davidmhunt/fmcw3/parts/datasheet_left_as_is.csv

ref | reason | value
C2 | generic-spec-only | 100 nF
C3 | generic-spec-only | 10 pF
C4 | generic-spec-only | 100 nF
C5 | generic-spec-only | 10 pF
C6 | generic-spec-only | 100 nF
C7 | generic-spec-only | 10 pF
C8 | needs-David | 10 pF
C9 | generic-spec-only | 100 nF
C10 | generic-spec-only | 2.2 nF
C11 | needs-David | 10 pF
C12 | generic-spec-only | 1 uF
C13 | generic-spec-only | 10 nF
C14 | generic-spec-only | 51 pF
C15 | generic-spec-only | 100 nF
C16 | generic-spec-only | 10 nF
C17 | generic-spec-only | 100 nF
C18 | generic-spec-only | 100 nF
C19 | generic-spec-only | 1 uF
C20 | generic-spec-only | 1 uF
C21 | generic-spec-only | 100 nF
C22 | generic-spec-only | 2.2 uF
C23 | generic-spec-only | 100 nF
C24 | generic-spec-only | 100 nF
C25 | generic-spec-only | 100 nF
C26 | generic-spec-only | 10 uF
C27 | generic-spec-only | 100 nF
C28 | generic-spec-only | 10 nF
C29 | generic-spec-only | 68 pF
C30 | generic-spec-only | 100 nF
C31 | generic-spec-only | 2.2 uF
C32 | generic-spec-only | 100 nF
C33 | generic-spec-only | 100 pF
C34 | generic-spec-only | 100 pF
C36 | generic-spec-only | 10 pF
C38 | generic-spec-only | 10 uF
C39 | generic-spec-only | 2.2 uF
C40 | generic-spec-only | 100 pF
C41 | generic-spec-only | 100 pF
C42 | needs-David | 18 pF
C43 | generic-spec-only | 100 nF
C44 | generic-spec-only | 10 pF
C46 | needs-David | 18 pF
C48 | needs-David | 0.5 pF
C49 | generic-spec-only | 100 nF
C52 | needs-David | 18 pF
C53 | generic-spec-only | 10 pF
C55 | needs-David | 18 pF
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
R79 | generic-spec-only | 2.2 kohm
R80 | generic-spec-only | 0 ohm
R81 | generic-spec-only | 0 ohm
R82 | generic-spec-only | 4.7 kohm
R83 | generic-spec-only | 10 kohm
R84 | generic-spec-only | 33 ohm
R85 | generic-spec-only | 33 ohm
R87 | generic-spec-only | 0 ohm
R88 | generic-spec-only | 33 ohm
R89 | generic-spec-only | 0 ohm
R90 | generic-spec-only | 0 ohm
R91 | generic-spec-only | 0 ohm
R93 | generic-spec-only | 0 ohm
R94 | generic-spec-only | 0 ohm
R97 | generic-spec-only | 49.9 ohm
R98 | generic-spec-only | 49.9 ohm
R99 | generic-spec-only | 49.9 ohm
R100 | generic-spec-only | 49.9 ohm
R103 | generic-spec-only | 0 ohm
R104 | generic-spec-only | 68 kohm
R109 | generic-spec-only | 240 ohm
R111 | generic-spec-only | 1 kohm
R112 | generic-spec-only | 4.7 kohm
R114 | generic-spec-only | 0 ohm
R115 | generic-spec-only | 0 ohm
R117 | generic-spec-only | 4.7 kohm
R118 | generic-spec-only | 4.7 kohm
R130 | generic-spec-only | 33 ohm
U4 | needs-David | KT2520K
U8 | needs-David | LTC2292
U31 | needs-David | USB-MICRO
