davidmhunt/fmcw3/parts/availability.csv

refs | qty | need | value | footprint | kind | status | dk_status | mpn | mfr | dkpn | stock | ok | lead_weeks | dk_package | datasheet | dk_url | match | candidates | needs_david | package | tolerance | voltage | dielectric | tolerance_hint | dielectric_hint | notes
C1;C71;C72;C81;C103;C104;C105;C107;C169;C172;C173;C177;C178;C214;C215 | 15 | 75 | DNP | fmcw3:C_0805b | dnp | DNP |  |  |  |  |  | n/a |  |  |  |  |  |  |  |  |  |  |  |  |  | DNP in schematic: footprint only, not sourced
C23;C30;C32;C90;C91;C92;C132;C133;C219;C221 | 10 | 50 | 100 nF | fmcw3:C_0402b | generic | generic-spec-only |  |  |  |  |  | n/a |  |  |  |  |  |  |  | 0402 | unspecified | >=6.3 V (inferred default: no supply rail on these nets) | unspecified |  | X7R
C2;C4;C9;C15;C17;C18;C24;C25;C27;C43;C49;C58;C138;C139;C150;C151;C152;C153;C154;C158;C159;C160;C161;C176;C207;C210;C211;C212;C223;C224;C225;C252 | 32 | 160 | 100 nF | fmcw3:C_0402b | generic | generic-spec-only |  |  |  |  |  | n/a |  |  |  |  |  |  |  | 0402 | unspecified | >=6.3 V (inferred: 3.6 V on 3V6) | unspecified |  | X7R
C6;C108;C115;C116;C120;C121;C122;C123 | 8 | 40 | 100 nF | fmcw3:C_0402b | generic | generic-spec-only |  |  |  |  |  | n/a |  |  |  |  |  |  |  | 0402 | unspecified | >=10 V (inferred: 5 V on Net-(U1-VP)) | unspecified |  | X7R
C21 | 1 | 5 | 100 nF | fmcw3:C_0402b | generic | generic-spec-only |  |  |  |  |  | n/a |  |  |  |  |  |  |  | 0402 | unspecified | >=16 V (inferred: 10 V on 10V) | unspecified |  | X7R
C36;C134;C135;C136;C137 | 5 | 25 | 10 pF | fmcw3:C_0402b | generic | generic-spec-only |  |  |  |  |  | n/a |  |  |  |  |  |  |  | 0402 | unspecified | >=6.3 V (inferred default: no supply rail on these nets) | unspecified |  | C0G/NP0
C3;C5;C44;C53 | 4 | 20 | 10 pF | fmcw3:C_0402b | generic | generic-spec-only |  |  |  |  |  | n/a |  |  |  |  |  |  |  | 0402 | unspecified | >=6.3 V (inferred: 3.3 V on 3V3A) | unspecified |  | C0G/NP0
C7 | 1 | 5 | 10 pF | fmcw3:C_0402b | generic | generic-spec-only |  |  |  |  |  | n/a |  |  |  |  |  |  |  | 0402 | unspecified | >=10 V (inferred: 5 V on Net-(U1-VP)) | unspecified |  | C0G/NP0
C8;C11;C109;C110;C111;C112;C113;C114 | 8 | 40 | 10 pF | fmcw3:C_0402b | generic | needs-David |  |  |  |  |  | n/a |  |  |  |  |  |  | needs-David | 0402 | unspecified | >=6.3 V (inferred default: no supply rail on these nets) | unspecified |  | C0G/NP0 | RF-path part given by value only: vendor/series/tolerance/SRF decide performance
C10 | 1 | 5 | 2.2 nF | fmcw3:C_0402b | generic | generic-spec-only |  |  |  |  |  | n/a |  |  |  |  |  |  |  | 0402 | unspecified | >=6.3 V (inferred default: no supply rail on these nets) | unspecified |  | X7R
C126;C127 | 2 | 10 | 2.2 nF | fmcw3:C_0402b | generic | generic-spec-only |  |  |  |  |  | n/a |  |  |  |  |  |  |  | 0402 | unspecified | >=10 V (inferred: 5 V on Net-(C126-Pad1)) | unspecified |  | X7R
C19;C20;C217;C218 | 4 | 20 | 1 uF | fmcw3:C_0603b | generic | generic-spec-only |  |  |  |  |  | n/a |  |  |  |  |  |  |  | 0603 | unspecified | >=6.3 V (inferred default: no supply rail on these nets) | unspecified |  | X7R
C12;C222;C249 | 3 | 15 | 1 uF | fmcw3:C_0603b | generic | generic-spec-only |  |  |  |  |  | n/a |  |  |  |  |  |  |  | 0603 | unspecified | >=6.3 V (inferred: 3 V on 3V0) | unspecified |  | X7R
C89 | 1 | 5 | 1 uF | fmcw3:C_0603b | generic | generic-spec-only |  |  |  |  |  | n/a |  |  |  |  |  |  |  | 0603 | unspecified | >=25 V (inferred: 15 V on 12V) | unspecified |  | X7R
C13;C16;C63;C65;C66;C95 | 6 | 30 | 10 nF | fmcw3:C_0402b | generic | generic-spec-only |  |  |  |  |  | n/a |  |  |  |  |  |  |  | 0402 | unspecified | >=6.3 V (inferred default: no supply rail on these nets) | unspecified |  | X7R
C28;C97;C99;C179;C206 | 5 | 25 | 10 nF | fmcw3:C_0402b | generic | generic-spec-only |  |  |  |  |  | n/a |  |  |  |  |  |  |  | 0402 | unspecified | >=6.3 V (inferred: 3.3 V on 3V3A) | unspecified |  | X7R
C96;C128;C129;C130;C131 | 5 | 25 | 10 nF | fmcw3:C_0402b | generic | generic-spec-only |  |  |  |  |  | n/a |  |  |  |  |  |  |  | 0402 | unspecified | >=10 V (inferred: 5 V on 5V) | unspecified |  | X7R
C14 | 1 | 5 | 51 pF | fmcw3:C_0402b | generic | generic-spec-only |  |  |  |  |  | n/a |  |  |  |  |  |  |  | 0402 | unspecified | >=6.3 V (inferred default: no supply rail on these nets) | unspecified |  | C0G/NP0
C22;C31;C216;C220 | 4 | 20 | 2.2 uF | fmcw3:C_0603b | generic | generic-spec-only |  |  |  |  |  | n/a |  |  |  |  |  |  |  | 0603 | unspecified | >=6.3 V (inferred default: no supply rail on these nets) | unspecified |  | X5R or X7R
C39 | 1 | 5 | 2.2 uF | fmcw3:C_0603b | generic | generic-spec-only |  |  |  |  |  | n/a |  |  |  |  |  |  |  | 0603 | unspecified | >=6.3 V (inferred: 3.3 V on Net-(U14-BSPLY)) | unspecified |  | X5R or X7R
C26;C38;C76;C77;C78;C80;C85;C87;C88;C93;C94;C101;C102;C106;C248 | 15 | 75 | 10 uF | fmcw3:C_0805b | generic | generic-spec-only |  |  |  |  |  | n/a |  |  |  |  |  |  |  | 0805 | unspecified | >=6.3 V (inferred: 3.6 V on 3V6) | unspecified |  | X5R or X7R
C79;C82;C83;C84;C86;C100;C162 | 7 | 35 | 10 uF | fmcw3:C_0805b | generic | generic-spec-only |  |  |  |  |  | n/a |  |  |  |  |  |  |  | 0805 | unspecified | >=10 V (inferred: 5.6 V on 5V6) | unspecified |  | X5R or X7R
C98 | 1 | 5 | 10 uF | fmcw3:C_0805b | generic | generic-spec-only |  |  |  |  |  | n/a |  |  |  |  |  |  |  | 0805 | unspecified | >=16 V (inferred: 10 V on 10V) | unspecified |  | X5R or X7R
C60;C61;C62;C64;C70 | 5 | 25 | 10 uF | fmcw3:C_0805b | generic | generic-spec-only |  |  |  |  |  | n/a |  |  |  |  |  |  |  | 0805 | unspecified | >=25 V (inferred: 15 V on 12V) | unspecified |  | X5R or X7R
C29;C69 | 2 | 10 | 68 pF | fmcw3:C_0402b | generic | generic-spec-only |  |  |  |  |  | n/a |  |  |  |  |  |  |  | 0402 | unspecified | >=6.3 V (inferred default: no supply rail on these nets) | unspecified |  | C0G/NP0
C33;C34;C68;C163;C164;C165;C166;C167;C168 | 9 | 45 | 100 pF | fmcw3:C_0402b | generic | generic-spec-only |  |  |  |  |  | n/a |  |  |  |  |  |  |  | 0402 | unspecified | >=6.3 V (inferred default: no supply rail on these nets) | unspecified |  | C0G/NP0
C40;C41;C180;C213 | 4 | 20 | 100 pF | fmcw3:C_0402b | generic | generic-spec-only |  |  |  |  |  | n/a |  |  |  |  |  |  |  | 0402 | unspecified | >=6.3 V (inferred: 3.3 V on Net-(U14-BSPLY)) | unspecified |  | C0G/NP0
C117;C118;C119 | 3 | 15 | 100 pF | fmcw3:C_0402b | generic | generic-spec-only |  |  |  |  |  | n/a |  |  |  |  |  |  |  | 0402 | unspecified | >=10 V (inferred: 5 V on 5VF) | unspecified |  | C0G/NP0
C35;C37;C45;C47;C50;C51;C54;C56;C59 | 9 | 45 | DNP | fmcw3:C_0603b | dnp | DNP |  |  |  |  |  | n/a |  |  |  |  |  |  |  |  |  |  |  |  |  | DNP in schematic: footprint only, not sourced
C42;C46;C52;C55 | 4 | 20 | 18 pF | fmcw3:C_0402b | generic | needs-David |  |  |  |  |  | n/a |  |  |  |  |  |  | needs-David | 0402 | unspecified | >=6.3 V (inferred: 3 V on Net-(U9-RFOUT)) | unspecified |  | C0G/NP0 | RF-path part given by value only: vendor/series/tolerance/SRF decide performance
C48;C57 | 2 | 10 | 0.5 pF | fmcw3:C_0402b | generic | needs-David |  |  |  |  |  | n/a |  |  |  |  |  |  | needs-David | 0402 | unspecified | >=6.3 V (inferred default: no supply rail on these nets) | unspecified |  | C0G/NP0 | RF-path part given by value only: vendor/series/tolerance/SRF decide performance
C67 | 1 | 5 | 39 pF | fmcw3:C_0402b | generic | generic-spec-only |  |  |  |  |  | n/a |  |  |  |  |  |  |  | 0402 | unspecified | >=6.3 V (inferred default: no supply rail on these nets) | unspecified |  | C0G/NP0
C73 | 1 | 5 | 15 nF | fmcw3:C_0402b | generic | generic-spec-only |  |  |  |  |  | n/a |  |  |  |  |  |  |  | 0402 | unspecified | >=6.3 V (inferred: 1 V on Net-(C73-Pad1)) | unspecified |  | X7R
C74 | 1 | 5 | 8.2 nF | fmcw3:C_0402b | generic | generic-spec-only |  |  |  |  |  | n/a |  |  |  |  |  |  |  | 0402 | unspecified | >=6.3 V (inferred: 3.6 V on Net-(C74-Pad1)) | unspecified |  | X7R
C75 | 1 | 5 | 4.7 nF | fmcw3:C_0402b | generic | generic-spec-only |  |  |  |  |  | n/a |  |  |  |  |  |  |  | 0402 | unspecified | >=10 V (inferred: 5.6 V on Net-(C75-Pad1)) | unspecified |  | X7R
C124;C125;C140;C141;C142;C143;C144;C145;C146;C147;C148;C149;C174;C175 | 14 | 70 | DNP | fmcw3:C_0402b | dnp | DNP |  |  |  |  |  | n/a |  |  |  |  |  |  |  |  |  |  |  |  |  | DNP in schematic: footprint only, not sourced
C155;C156;C157 | 3 | 15 | 4.7 uF | fmcw3:C_0603b | generic | generic-spec-only |  |  |  |  |  | n/a |  |  |  |  |  |  |  | 0603 | unspecified | >=6.3 V (inferred: 3.3 V on Net-(U33-VPHY)) | unspecified |  | X5R or X7R
C170;C171;C187;C189;C190;C191;C192;C193;C197;C198;C199;C200;C201;C202;C203;C204;C205;C250;C251 | 19 | 95 | 470 nF | fmcw3:C_0402b | generic | generic-spec-only |  |  |  |  |  | n/a |  |  |  |  |  |  |  | 0402 | unspecified | >=6.3 V (inferred: 3.3 V on 3V3D) | unspecified |  | X7R
C181 | 1 | 5 | 100 uF | Capacitors_SMD:C_1210 | generic | generic-spec-only |  |  |  |  |  | n/a |  |  |  |  |  |  |  | 1210 | unspecified | >=6.3 V (inferred: 1 V on 1V0) | unspecified |  | X5R or X7R
C182;C184;C196 | 3 | 15 | 47 uF | Capacitors_SMD:C_1206 | generic | generic-spec-only |  |  |  |  |  | n/a |  |  |  |  |  |  |  | 1206 | unspecified | >=6.3 V (inferred: 3.3 V on 3V3D) | unspecified |  | X5R or X7R
C183;C185;C186;C188;C194;C195 | 6 | 30 | 4.7 uF | fmcw3:C_0805b | generic | generic-spec-only |  |  |  |  |  | n/a |  |  |  |  |  |  |  | 0805 | unspecified | >=6.3 V (inferred: 3.3 V on 3V3D) | unspecified |  | X5R or X7R
C208;C209 | 2 | 10 | 15 pF | fmcw3:C_0402b | generic | generic-spec-only |  |  |  |  |  | n/a |  |  |  |  |  |  |  | 0402 | unspecified | >=6.3 V (inferred default: no supply rail on these nets) | unspecified |  | C0G/NP0 (crystal load caps)
CON1 | 1 | 5 | SD_Card_DM3BT | fmcw3:DM3BT-DSF-PEJS | mpn | Active | Active | DM3BT-DSF-PEJS | Hirose Electric Co Ltd | HR1942CT-ND | 16323 | yes | 16 |  | https://www.hirose.com/product/download/?distributor=digikey&type=specSheet&lang=en&num=DM3BT-DSF-PEJS | https://www.digikey.com/en/products/detail/hirose-electric-co-ltd/DM3BT-DSF-PEJS/1982749 | exact |  |  |  |  |  |  |  |  | SD card socket
CON2 | 1 | 5 | BARREL_JACK | fmcw3:EJ508A | mpn | Active | Active | EJ508A | MPD (Memory Protection Devices) | EJ508A-ND | 6629 | yes | 20 |  | https://www.memoryprotectiondevices.com/datasheets/EJ508A/EJ508A-datasheet.pdf | https://www.digikey.com/en/products/detail/mpd-memory-protection-devices/EJ508A/2439547 | exact |  |  |  |  |  |  |  |  | barrel jack
D1;D6 | 2 | 10 | LED | fmcw3:LED_0603 | generic | generic-spec-only |  |  |  |  |  | n/a |  |  |  |  |  |  |  | 0603 | n/a |  |  |  |  | LED: colour, Vf, current not in schematic
D2;D3;D4 | 3 | 15 | SS13FL | fmcw3:SOD-123F | mpn | Obsolete | Obsolete | SS13FL | onsemi | 2832-SS13FLTR-ND | 15000 | CHECK | 13 | SOD-123F | https://www.onsemi.com/pdf/datasheet/ss14fl-d.pdf | https://www.digikey.com/en/products/detail/onsemi/SS13FL/5305064 | exact |  |  |  |  |  |  |  |  | Schottky SOD-123F
F1;F2 | 2 | 10 | Via | fmcw3:RF_via | nopart | no-part |  |  |  |  |  | n/a |  |  |  |  |  |  |  |  |  |  |  |  |  | RF via footprint (PCB feature)
FB1;FB2;FB3;FB5;FB6;FB7;FB8;FB12;FB13;FB14 | 10 | 50 | BLM18PG181SN1D | fmcw3:C_0603b | mpn | Active | Active | BLM18PG181SN1D | Murata Electronics | 490-5263-1-ND | 426016 | yes | 29 |  | https://pim.murata.com/asset/pim4/ferriteBeadInductortypefilter/ENFA0003_PDF_FERRITEBEADINDUCTORTYPEFILTER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 | https://www.digikey.com/en/products/detail/murata-electronics/BLM18PG181SN1D/1634634 | exact |  |  |  |  |  |  |  |  | ferrite
FB4;FB11 | 2 | 10 | CIC21P101NE | fmcw3:C_0805b | mpn | Obsolete | Obsolete | CIC21P101NE | Samsung Electro-Mechanics | 1276-6374-2-ND | 0 | CHECK | 26 |  | //mm.digikey.com/Volume0/opasdata/d220001/medias/docus/2330/CIC21_ds.pdf | https://www.digikey.com/en/products/detail/samsung-electro-mechanics/CIC21P101NE/3973735 | exact |  |  |  |  |  |  |  |  | ferrite
L1;L3 | 2 | 10 | LQW15AN9N9J80D | fmcw3:C_0402b | mpn | Active | Active | LQW15AN9N9J80D | Murata Electronics | 490-7690-1-ND | 766 | yes | 25 | - | https://pim.murata.com/asset/pim4/inductor/JELF243A-0100_PDF_INDUCTOR | https://www.digikey.com/en/products/detail/murata-electronics/LQW15AN9N9J80D/4292403 | exact |  |  |  |  |  |  |  |  | 9.9 nH RF inductor
L2;L4 | 2 | 10 | 0.6 nH | fmcw3:C_0402b | generic | needs-David |  |  |  |  |  | n/a |  |  |  |  |  |  | needs-David | 0402 | unspecified |  |  |  |  | current/saturation rating, DCR, SRF not in schematic; RF-path part given by value only: vendor/series/tolerance/SRF decide performance
L5;L6;L7 | 3 | 15 | 33u (SRR6040A-330M) | fmcw3:SRR6040A | mpn | NFND | Not For New Designs | SRR6040A-330M | Bourns Inc. | SRR6040A-330MCT-ND | 777 | CHECK | 16 | - | https://www.bourns.com/docs/Product-Datasheets/SRR6040A.pdf | https://www.digikey.com/en/products/detail/bourns-inc/SRR6040A-330M/5031023 | exact |  |  |  |  |  |  |  |  | 33 uH buck inductor
L8;L9;L10;L11 | 4 | 20 | 2.2 uH | fmcw3:C_0805b | generic | generic-spec-only |  |  |  |  |  | n/a |  |  |  |  |  |  |  | 0805 | unspecified |  |  |  |  | current/saturation rating, DCR, SRF not in schematic
P1;P2 | 2 | 10 | SMA | fmcw3:CONSMA003.062 | mpn | Active | Active | CONSMA003.062 | TE Connectivity Linx | CONSMA003.062-ND | 5904 | yes | 4 |  | https://linxtechnologies.com/wp/wp-content/uploads/sma_rp-sma_specs.pdf | https://www.digikey.com/en/products/detail/te-connectivity-linx/CONSMA003-062/1577208 | exact |  |  |  |  |  |  |  |  | Linx edge-launch SMA (same footprint as U15)
P3;P4 | 2 | 10 | CONN_02X04 | Pin_Headers:Pin_Header_Straight_2x04_Pitch2.54mm_SMD | generic | generic-spec-only |  |  |  |  |  | n/a |  |  |  |  |  |  |  | SMD 2x4 2.54 mm | n/a |  |  |  |  | 2x4 2.54 mm SMD pin header, footprint Pin_Header_Straight_2x04_Pitch2.54mm_SMD; MPN to be picked by David
P5;P7;P8 | 3 | 15 | CONN_01X01 | fmcw3:MountingHole_3.2mm_M3_Pad_Via_mod | nopart | no-part |  |  |  |  |  | n/a |  |  |  |  |  |  |  |  |  |  |  |  |  | M3 mounting hole (mechanical)
P6;P9;P10;P11;P12;P13;P14;P15;P16 | 9 | 45 | CONN_01X01 | fmcw3:TP_1.00 | nopart | no-part |  |  |  |  |  | n/a |  |  |  |  |  |  |  |  |  |  |  |  |  | 1 mm test-point pad (PCB feature)
Q1 | 1 | 5 | RE1C002UN | fmcw3:SOT-416 | mpn | Active | Active | RE1C002UNTCL | Rohm Semiconductor | RE1C002UNTCLCT-ND | 586719 | yes | 16 | EMT3F (SOT-416FL) | https://fscdn.rohm.com/en/products/databook/datasheet/discrete/transistor/mosfet/re1c002untcl-e.pdf | https://www.digikey.com/en/products/detail/rohm-semiconductor/RE1C002UNTCL/5042785 | exact |  |  |  |  |  |  |  |  | MOSFET SOT-416FL; TCL = taping
Q2 | 1 | 5 | DNP(RE1C002UN) | fmcw3:SOT-416 | dnp | DNP |  |  |  |  |  | n/a |  |  |  |  |  |  |  |  |  |  |  |  |  | DNP in schematic: footprint only, not sourced
R1 | 1 | 5 | 5.49 kohm | fmcw3:R_0402b | generic | generic-spec-only |  |  |  |  |  | n/a |  |  |  |  |  |  |  | 0402 | unspecified |  |  | E96 value, 1% implied |  | power rating not in schematic (0402 default 1/16 W)
R2;R31;R40;R50;R63;R64;R65;R66;R67;R68;R69;R74;R75;R76;R77;R78;R86;R92;R101;R110 | 20 | 100 | DNP | fmcw3:R_0402b | dnp | DNP |  |  |  |  |  | n/a |  |  |  |  |  |  |  |  |  |  |  |  |  | DNP in schematic: footprint only, not sourced
R3;R8 | 2 | 10 | 470 kohm | fmcw3:R_0402b | generic | generic-spec-only |  |  |  |  |  | n/a |  |  |  |  |  |  |  | 0402 | unspecified |  |  | E24 value, 5% implied |  | power rating not in schematic (0402 default 1/16 W)
R4 | 1 | 5 | 3.1 kohm | fmcw3:R_0402b | generic | generic-spec-only |  |  |  |  |  | n/a |  |  |  |  |  |  |  | 0402 | unspecified |  |  | value outside E24/E96 |  | power rating not in schematic (0402 default 1/16 W)
R5;R6;R7;R18;R82;R112;R117;R118 | 8 | 40 | 4.7 kohm | fmcw3:R_0402b | generic | generic-spec-only |  |  |  |  |  | n/a |  |  |  |  |  |  |  | 0402 | unspecified |  |  | E24 value, 5% implied |  | power rating not in schematic (0402 default 1/16 W)
R9;R11;R12 | 3 | 15 | 18 ohm | fmcw3:R_0402b | generic | needs-David |  |  |  |  |  | n/a |  |  |  |  |  |  | needs-David | 0402 | unspecified |  |  | E24 value, 5% implied |  | power rating not in schematic (0402 default 1/16 W); RF-path part given by value only: vendor/series/tolerance/SRF decide performance
R10 | 1 | 5 | 6.98 kohm | fmcw3:R_0402b | generic | generic-spec-only |  |  |  |  |  | n/a |  |  |  |  |  |  |  | 0402 | unspecified |  |  | E96 value, 1% implied |  | power rating not in schematic (0402 default 1/16 W)
R13;R15;R16;R38;R84;R85;R88;R130 | 8 | 40 | 33 ohm | fmcw3:R_0402b | generic | generic-spec-only |  |  |  |  |  | n/a |  |  |  |  |  |  |  | 0402 | unspecified |  |  | E24 value, 5% implied |  | power rating not in schematic (0402 default 1/16 W)
R14 | 1 | 5 | 39 kohm | fmcw3:R_0402b | generic | generic-spec-only |  |  |  |  |  | n/a |  |  |  |  |  |  |  | 0402 | unspecified |  |  | E24 value, 5% implied |  | power rating not in schematic (0402 default 1/16 W)
R51;R52;R53;R54;R97;R98;R99;R100 | 8 | 40 | 49.9 ohm | fmcw3:R_0402b | generic | generic-spec-only |  |  |  |  |  | n/a |  |  |  |  |  |  |  | 0402 | unspecified |  |  | E96 value, 1% implied |  | power rating not in schematic (0402 default 1/16 W)
R17 | 1 | 5 | 49.9 ohm | fmcw3:R_0402b | generic | needs-David |  |  |  |  |  | n/a |  |  |  |  |  |  | needs-David | 0402 | unspecified |  |  | E96 value, 1% implied |  | power rating not in schematic (0402 default 1/16 W); RF-path part given by value only: vendor/series/tolerance/SRF decide performance
R20;R70;R80;R81;R87;R89;R90;R91;R93;R94;R103;R114;R115 | 13 | 65 | 0 ohm | fmcw3:R_0402b | generic | generic-spec-only |  |  |  |  |  | n/a |  |  |  |  |  |  |  | 0402 | unspecified |  |  | 0 ohm jumper |  | power rating not in schematic (0402 default 1/16 W)
R21 | 1 | 5 | 22 ohm | fmcw3:R_0402b | generic | generic-spec-only |  |  |  |  |  | n/a |  |  |  |  |  |  |  | 0402 | unspecified |  |  | E24 value, 5% implied |  | power rating not in schematic (0402 default 1/16 W)
R22;R23;R42 | 3 | 15 | 100 ohm | fmcw3:R_0402b | generic | generic-spec-only |  |  |  |  |  | n/a |  |  |  |  |  |  |  | 0402 | unspecified |  |  | E96 value, 1% implied |  | power rating not in schematic (0402 default 1/16 W)
R24;R109 | 2 | 10 | 240 ohm | fmcw3:R_0402b | generic | generic-spec-only |  |  |  |  |  | n/a |  |  |  |  |  |  |  | 0402 | unspecified |  |  | E24 value, 5% implied |  | power rating not in schematic (0402 default 1/16 W)
R25;R26;R104 | 3 | 15 | 68 kohm | fmcw3:R_0402b | generic | generic-spec-only |  |  |  |  |  | n/a |  |  |  |  |  |  |  | 0402 | unspecified |  |  | E24 value, 5% implied |  | power rating not in schematic (0402 default 1/16 W)
R27 | 1 | 5 | 15 kohm | fmcw3:R_0402b | generic | generic-spec-only |  |  |  |  |  | n/a |  |  |  |  |  |  |  | 0402 | unspecified |  |  | E96 value, 1% implied |  | power rating not in schematic (0402 default 1/16 W)
R28 | 1 | 5 | 59 kohm | fmcw3:R_0402b | generic | generic-spec-only |  |  |  |  |  | n/a |  |  |  |  |  |  |  | 0402 | unspecified |  |  | E96 value, 1% implied |  | power rating not in schematic (0402 default 1/16 W)
R29 | 1 | 5 | 6.8 kohm | fmcw3:R_0402b | generic | generic-spec-only |  |  |  |  |  | n/a |  |  |  |  |  |  |  | 0402 | unspecified |  |  | E24 value, 5% implied |  | power rating not in schematic (0402 default 1/16 W)
R30;R59;R60;R61;R62 | 5 | 25 | 8.2 kohm | fmcw3:R_0402b | generic | generic-spec-only |  |  |  |  |  | n/a |  |  |  |  |  |  |  | 0402 | unspecified |  |  | E24 value, 5% implied |  | power rating not in schematic (0402 default 1/16 W)
R32;R34;R36 | 3 | 15 | 4.99 kohm | fmcw3:R_0402b | generic | generic-spec-only |  |  |  |  |  | n/a |  |  |  |  |  |  |  | 0402 | unspecified |  |  | E96 value, 1% implied |  | power rating not in schematic (0402 default 1/16 W)
R33 | 1 | 5 | 7.5 kohm | fmcw3:R_0402b | generic | generic-spec-only |  |  |  |  |  | n/a |  |  |  |  |  |  |  | 0402 | unspecified |  |  | E96 value, 1% implied |  | power rating not in schematic (0402 default 1/16 W)
R35;R72;R111 | 3 | 15 | 1 kohm | fmcw3:R_0402b | generic | generic-spec-only |  |  |  |  |  | n/a |  |  |  |  |  |  |  | 0402 | unspecified |  |  | E96 value, 1% implied |  | power rating not in schematic (0402 default 1/16 W)
R37 | 1 | 5 | 590 ohm | fmcw3:R_0402b | generic | generic-spec-only |  |  |  |  |  | n/a |  |  |  |  |  |  |  | 0402 | unspecified |  |  | E96 value, 1% implied |  | power rating not in schematic (0402 default 1/16 W)
R39 | 1 | 5 | 47 kohm | fmcw3:R_0402b | generic | generic-spec-only |  |  |  |  |  | n/a |  |  |  |  |  |  |  | 0402 | unspecified |  |  | E24 value, 5% implied |  | power rating not in schematic (0402 default 1/16 W)
R41 | 1 | 5 | 56 ohm | fmcw3:R_0402b | generic | generic-spec-only |  |  |  |  |  | n/a |  |  |  |  |  |  |  | 0402 | unspecified |  |  | E24 value, 5% implied |  | power rating not in schematic (0402 default 1/16 W)
R43 | 1 | 5 | 10.5 kohm | fmcw3:R_0402b | generic | generic-spec-only |  |  |  |  |  | n/a |  |  |  |  |  |  |  | 0402 | unspecified |  |  | E96 value, 1% implied |  | power rating not in schematic (0402 default 1/16 W)
R44;R49 | 2 | 10 | 2 kohm | fmcw3:R_0402b | generic | generic-spec-only |  |  |  |  |  | n/a |  |  |  |  |  |  |  | 0402 | unspecified |  |  | E96 value, 1% implied |  | power rating not in schematic (0402 default 1/16 W)
R45 | 1 | 5 | 1.87 kohm | fmcw3:R_0402b | generic | generic-spec-only |  |  |  |  |  | n/a |  |  |  |  |  |  |  | 0402 | unspecified |  |  | E96 value, 1% implied |  | power rating not in schematic (0402 default 1/16 W)
R46 | 1 | 5 | 1.5 kohm | fmcw3:R_0402b | generic | generic-spec-only |  |  |  |  |  | n/a |  |  |  |  |  |  |  | 0402 | unspecified |  |  | E96 value, 1% implied |  | power rating not in schematic (0402 default 1/16 W)
R47 | 1 | 5 | 3.57 kohm | fmcw3:R_0402b | generic | generic-spec-only |  |  |  |  |  | n/a |  |  |  |  |  |  |  | 0402 | unspecified |  |  | E96 value, 1% implied |  | power rating not in schematic (0402 default 1/16 W)
R48 | 1 | 5 | 1.15 kohm | fmcw3:R_0402b | generic | generic-spec-only |  |  |  |  |  | n/a |  |  |  |  |  |  |  | 0402 | unspecified |  |  | E96 value, 1% implied |  | power rating not in schematic (0402 default 1/16 W)
R55;R56;R57;R58 | 4 | 20 | 550 ohm | fmcw3:R_0402b | generic | generic-spec-only |  |  |  |  |  | n/a |  |  |  |  |  |  |  | 0402 | unspecified |  |  | value outside E24/E96 |  | power rating not in schematic (0402 default 1/16 W)
R71 | 1 | 5 | 12 kohm | fmcw3:R_0402b | generic | generic-spec-only |  |  |  |  |  | n/a |  |  |  |  |  |  |  | 0402 | unspecified |  |  | E24 value, 5% implied |  | power rating not in schematic (0402 default 1/16 W)
R73;R83 | 2 | 10 | 10 kohm | fmcw3:R_0402b | generic | generic-spec-only |  |  |  |  |  | n/a |  |  |  |  |  |  |  | 0402 | unspecified |  |  | E96 value, 1% implied |  | power rating not in schematic (0402 default 1/16 W)
R79 | 1 | 5 | 2.2 kohm | fmcw3:R_0402b | generic | generic-spec-only |  |  |  |  |  | n/a |  |  |  |  |  |  |  | 0402 | unspecified |  |  | E24 value, 5% implied |  | power rating not in schematic (0402 default 1/16 W)
SW2 | 1 | 5 | SW_PUSH | fmcw3:EVP-AWBA2A | mpn | Obsolete | Obsolete | EVP-AWBA2A | Panasonic Industry | P16850TR-ND | 0 | CHECK | 12 |  | //mm.digikey.com/Volume0/opasdata/d220001/medias/docus/2142/EVPAW.pdf | https://www.digikey.com/en/products/detail/panasonic-industry/EVP-AWBA2A/4930563 | exact |  |  |  |  |  |  |  |  | tactile switch
U1 | 1 | 5 | ADF4158 | fmcw3:VFQFN-24 | mpn | Active | Active | ADF4158CCPZ | Analog Devices Inc. | 505-ADF4158CCPZ-ND | 838 | yes | 12 | 24-LFCSP (4x4) | https://www.analog.com/media/en/technical-documentation/data-sheets/ADF4158.pdf | https://www.digikey.com/en/products/detail/analog-devices-inc/ADF4158CCPZ/2700204 | exact |  |  |  |  |  |  |  |  | PLL; MPN from schematic manf# field
U2 | 1 | 5 | LP5907-1.8 | fmcw3:SOT-23-5 | mpn | Active | Active | LP5907MFX-1.8/NOPB | Texas Instruments | 296-41463-1-ND | 9060 | yes | 16 | SOT-23-5 | https://www.ti.com/lit/ds/symlink/lp5907.pdf?ts=1782050205678 | https://www.digikey.com/en/products/detail/texas-instruments/LP5907MFX-1-8-NOPB/3911201 | exact |  |  |  |  |  |  |  |  | LDO; MFX = SOT-23-5 (matches footprint)
U3;U12 | 2 | 10 | PAT1220-6dB | fmcw3:PAT1220 | mpn | Active | Active | PAT1220-C-6DB-T5 | Susumu | PAT126CT-ND | 4759 | yes | 32 |  | https://www.susumu.co.jp/common/pdf/n_catalog_partition16_en.pdf | https://www.digikey.com/en/products/detail/susumu/PAT1220-C-6DB-T5/948837 | exact |  |  |  |  |  |  |  |  | Susumu 0805 attenuator: C=50 ohm, 06=6 dB, T5=tape
U4 | 1 | 5 | KT2520K | fmcw3:KT2520K | mpn | needs-David |  |  |  |  |  | n/a |  |  |  |  | candidates | KT2520K26000ZAW18TAS [Obsolete, stock 0, 478-KT2520K26000ZAW18TASTR-ND]; KT2520K40000DAW18TAS [Obsolete, stock 0, 478-KT2520K40000DAW18TASTR-ND]; KT2520K37400ZAW18TBS [Active, stock 0, 478-KT2520K37400ZAW18TBS-ND]; KT2520K38400ZAW18TES [Obsolete, stock 0, 478-KT2520K38400ZAW18TESTR-ND]; KT2520K16369ACW18TAS [Obsolete, stock 0, 478-KT2520K16369ACW18TASTR-ND] | needs-David |  |  |  |  |  |  | TCXO: frequency and stability not in schematic or docs; supply is 1.8 V (net 1V8_OSC) so only 1.8 V variants listed; family mostly Obsolete
U5 | 1 | 5 | NC7S04P5X | TO_SOT_Packages_SMD:SOT-353_SC-70-5 | mpn | Active | Active | NC7S04P5X | onsemi | NC7S04P5XCT-ND | 77480 | yes | 52 | SC-70-5 | https://www.onsemi.com/pub/Collateral/NC7S04-D.PDF | https://www.digikey.com/en/products/detail/onsemi/NC7S04P5X/965417 | exact
U6 | 1 | 5 | NB3N551 | fmcw3:DFN-8 | mpn | Obsolete | Obsolete | NB3N551MNR4G | onsemi | NB3N551MNR4GOSCT-ND | 0 | CHECK | 28 | 8-DFN (2x2) | //mm.digikey.com/Volume0/opasdata/d220001/medias/docus/7560/NB3N551DR2G%20%281%29.pdf | https://www.digikey.com/en/products/detail/onsemi/NB3N551MNR4G/1792369 | exact |  |  |  |  |  |  |  |  | clock buffer; DFN-8 2x2 footprint (onsemi 506CN) -> MN variant, only DFN8 orderable code
U7 | 1 | 5 | TLV172DCK | TO_SOT_Packages_SMD:SOT-353_SC-70-5 | mpn | Active | Active | TLV172IDCKR | Texas Instruments | 296-48697-1-ND | 2171 | yes | 9 | SC-70-5 | https://www.ti.com/general/docs/suppproductinfo.tsp?distId=10 | https://www.digikey.com/en/products/detail/texas-instruments/TLV172IDCKR/6564682 | exact |  |  |  |  |  |  |  |  | value TLV172DCK; I grade, SC70-5 reel
U8 | 1 | 5 | LTC2292 | Housings_DFN_QFN:QFN-64-1EP_9x9mm_Pitch0.5mm | mpn | needs-David |  |  |  |  |  | n/a |  |  |  |  | candidates | LTC2292CUP#PBF [Active, stock 60, LTC2292CUP#PBF-ND]; LTC2292IUP#PBF [Active, stock 344, 505-LTC2292IUP#PBF-ND] | needs-David |  |  |  |  |  |  | dual ADC, 64-QFN 9x9 = UP package; C (0-70 C) vs I (-40-85 C) grade not in schematic
U9;U13 | 2 | 10 | TRF37A73 | fmcw3:DFN-8-1EP_2x2mm_Pitch0.5mm | mpn | Active | Active | TRF37A73IDSGR | Texas Instruments | 296-48786-1-ND | 3550 | yes | 26 | 8-WSON (2x2) | https://www.ti.com/general/docs/suppproductinfo.tsp?distId=10 | https://www.digikey.com/en/products/detail/texas-instruments/TRF37A73IDSGR/6572562 | exact |  |  |  |  |  |  |  |  | RF amp, WSON-8 2x2; IDSGT is the 250-pc reel of the same part
U10 | 1 | 5 | HMC431LP4 | fmcw3:VQFN-24 | mpn | Active | Active | HMC431LP4ETR | Analog Devices Inc. | 1127-1036-1-ND | 0 | CHECK | 10 | 24-QFN (4x4) | https://www.analog.com/media/en/technical-documentation/data-sheets/hmc431.pdf | https://www.digikey.com/en/products/detail/analog-devices-inc/HMC431LP4ETR/3452258 | exact |  |  |  |  |  |  |  |  | VCO; MPN from schematic manf# field
U11;U16 | 2 | 10 | SKY65404 | fmcw3:XFDFN-6 | mpn | Active | Active | SKY65404-31 | Skyworks Solutions Inc. | 863-1398-1-ND | 76248 | yes | 22 | 6-QFN (1.5x1.5) | https://www.skyworksinc.com/-/media/5C3EBEFF9AA745DDA3613C3EA77D7ADB.pdf | https://www.digikey.com/en/products/detail/skyworks-solutions-inc/SKY65404-31/2764790 | exact |  |  |  |  |  |  |  |  | LNA 4.9-5.9 GHz
U14 | 1 | 5 | MGA-25203 | fmcw3:MGA-25203 | mpn | Obsolete | Obsolete | MGA-25203-BLKG | Broadcom Limited | 516-2289-ND | 0 | CHECK | 16 | - |  | https://www.digikey.com/en/products/detail/broadcom-limited/MGA-25203-BLKG/4966712 | exact |  |  |  |  |  |  |  |  | PA; MPN from schematic manf# field
U15 | 1 | 5 | SMA | fmcw3:CONSMA003.062 | mpn | Active | Active | CONSMA003.062 | TE Connectivity Linx | CONSMA003.062-ND | 5904 | yes | 4 |  | https://linxtechnologies.com/wp/wp-content/uploads/sma_rp-sma_specs.pdf | https://www.digikey.com/en/products/detail/te-connectivity-linx/CONSMA003-062/1577208 | exact |  |  |  |  |  |  |  |  | Linx edge-launch SMA
U17;U18;U19 | 3 | 15 | L7980 | Housings_DFN_QFN:DFN-8-1EP_3x3mm_Pitch0.5mm | mpn | Active | Active | L7980TR | STMicroelectronics | 497-10813-1-ND | 177 | yes | 30 | 8-VFQFPN (3x3) | https://www.st.com/content/ccc/resource/technical/document/datasheet/19/f6/ef/53/6a/98/4f/36/CD00217462.pdf/files/CD00217462.pdf/jcr:content/translations/en.C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 | https://www.digikey.com/en/products/detail/stmicroelectronics/L7980TR/2469143 | exact |  |  |  |  |  |  |  |  | buck; footprint DFN-8-1EP 3x3 -> L7980 (VFQFPN 3x3); the old L7980ATR pick was HSOP8, wrong package
U20;U39 | 2 | 10 | LP5907-3.0 | fmcw3:SOT-23-5 | mpn | Active | Active | LP5907MFX-3.0/NOPB | Texas Instruments | 296-40357-1-ND | 15562 | yes | 16 | SOT-23-5 | https://www.ti.com/lit/ds/symlink/lp5907.pdf?ts=1782050205678 | https://www.digikey.com/en/products/detail/texas-instruments/LP5907MFX-3-0-NOPB/3906438 | exact |  |  |  |  |  |  |  |  | LDO; MFX = SOT-23-5
U21 | 1 | 5 | LP2985A-10DBVR | fmcw3:SOT-23-5 | mpn | Active | Active | LP2985A-10DBVR | Texas Instruments | 296-24264-1-ND | 2970 | yes | 9 | SOT-23-5 | https://www.ti.com/general/docs/suppproductinfo.tsp?distId=10 | https://www.digikey.com/en/products/detail/texas-instruments/LP2985A-10DBVR/2038541 | exact |  |  |  |  |  |  |  |  | LDO, 1.0 V fixed; value field is the full MPN
U22;U23;U24 | 3 | 15 | TPS7A91 | fmcw3:SON-10_2.5x2.5mm | mpn | Active | Active | TPS7A9101DSKT | Texas Instruments | 296-45298-1-ND | 82 | yes | 16 | 10-SON (2.5x2.5) | https://www.ti.com/general/docs/suppproductinfo.tsp?distId=10 | https://www.digikey.com/en/products/detail/texas-instruments/TPS7A9101DSKT/6588889 | exact |  |  |  |  |  |  |  |  | adjustable LDO (FB nets present), DSK = 10-SON 2.5x2.5; DSKR is the same die in 3000-pc reel
U25 | 1 | 5 | MIC5301-3.3 | fmcw3:SOT-23-5 | mpn | Active | Active | MIC5301-3.3YD5-TR | Microchip Technology | 576-2840-1-ND | 5482 | yes | 6 | TSOT-23-5 | https://ww1.microchip.com/downloads/en/DeviceDoc/mic5301.pdf | https://www.digikey.com/en/products/detail/microchip-technology/MIC5301-3-3YD5-TR/1616991 | exact |  |  |  |  |  |  |  |  | 3.3 V LDO; footprint SOT-23-5 -> YD5 (TSOT-23-5); the old YMT pick was 6-pin 1.6x1.6 MLF, wrong package
U26;U27;U28 | 3 | 15 | 5400BL15B050E | fmcw3:5400BL15B050E | mpn | Active | Active | 5400BL15B0050001E | Johanson Technology Inc. | 712-5400BL15B0050001ECT-ND | 6878 | yes | 18 |  | https://www.johansontechnology.com/datasheets/5400BL15B050/5400BL15B050.pdf | https://www.digikey.com/en/products/detail/johanson-technology-inc/5400BL15B0050001E/1560729 | exact |  |  |  |  |  |  |  |  | Johanson balun; 050 = 50 ohm balanced (0100/0200 are 100/200 ohm variants)
U29 | 1 | 5 | ADL5802 | Housings_DFN_QFN:QFN-24-1EP_4x4mm_Pitch0.5mm | mpn | Active | Active | ADL5802ACPZ-R7 | Analog Devices Inc. | ADL5802ACPZ-R7CT-ND | 1473 | yes | 10 | 24-LFCSP (4x4) | https://www.analog.com/media/en/technical-documentation/data-sheets/ADL5802.pdf | https://www.digikey.com/en/products/detail/analog-devices-inc/ADL5802ACPZ-R7/2606734 | exact |  |  |  |  |  |  |  |  | mixer; only A-grade LFCSP-24 4x4 orderable code
U30 | 1 | 5 | XC7A15T-1FTG256C | fmcw3:FTG256 | mpn | Active | Active | XC7A15T-1FTG256C | AMD | 122-1930-ND | 0 | CHECK | 52 | 256-FTBGA (17x17) | https://docs.amd.com/v/u/en-US/ds180_7Series_Overview | https://www.digikey.com/en/products/detail/amd/XC7A15T-1FTG256C/5248117 | exact |  |  |  |  |  |  |  |  | Artix-7 FPGA; 7 schematic units A-G = 1 physical part
U31 | 1 | 5 | USB-MICRO | fmcw3:USB_MICRO | mpn | needs-David |  |  |  |  |  | n/a |  |  |  |  | candidates | 10118194-0001LF [Active, stock 75505, 609-4618-1-ND]; 0473460001 [Active, stock 15312, WM17141CT-ND]; 1050170001 [Active, stock 52976, WM1399CT-ND]; 629105136821 [Active, stock 8686, 732-3155-1-ND] | needs-David |  |  |  |  |  |  | micro-B USB receptacle; footprint USB_MICRO is 5 pads at 0.65 mm pitch (0.4x1.35) plus shield pads; no MPN anywhere in the design; compare footprint to candidate drawings
U32 | 1 | 5 | 93LC46B | fmcw3:SOT-23-6 | mpn | Active | Active | 93LC46BT-I/OT | Microchip Technology | 93LC46BT-I/OTCT-ND | 175016 | yes | 17 | SOT-23-6 | https://ww1.microchip.com/downloads/en/DeviceDoc/20001749K.pdf | https://www.digikey.com/en/products/detail/microchip-technology/93LC46BT-I-OT/572840 | exact |  |  |  |  |  |  |  |  | EEPROM, SOT-23-6 = OT package; I temp grade chosen as default (E/OT also exists)
U33 | 1 | 5 | FT2232H | Housings_QFP:LQFP-64_10x10mm_Pitch0.5mm | mpn | Active | Active | FT2232HL-REEL | FTDI, Future Technology Devices International Ltd | 768-1024-1-ND | 0 | CHECK | 50 | 64-LQFP (10x10) | https://ftdichip.com/wp-content/uploads/2025/11/DS_FT2232H.pdf | https://www.digikey.com/en/products/detail/ftdi-future-technology-devices-international-ltd/FT2232HL-REEL/1986053 | exact |  |  |  |  |  |  |  |  | USB bridge, LQFP-64 10x10 = HL; FT2232HL-TRAY is the tray pack
U34;U35 | 2 | 10 | ADA4940-2 | fmcw3:VFQFN-24 | mpn | Active | Active | ADA4940-2ACPZ-R7 | Analog Devices Inc. | 505-ADA4940-2ACPZ-R7CT-ND | 0 | CHECK | 55 | 24-LFCSP (4x4) | https://www.analog.com/media/en/technical-documentation/data-sheets/ADA4940-1_4940-2.pdf | https://www.digikey.com/en/products/detail/analog-devices-inc/ADA4940-2ACPZ-R7/2793303 | exact |  |  |  |  |  |  |  |  | dual ADC driver, LFCSP-24; U34/U35 are 2 physical ICs (units A,B each); -R2/-RL are other reel sizes
U40 | 1 | 5 | W25Q32JV | Housings_DFN_QFN:DFN-S-8-1EP_6x5mm_Pitch1.27mm | mpn | Obsolete | Obsolete | W25Q32JVZPIQ | Winbond Electronics | 256-W25Q32JVZPIQ-TUBE-ND | 129555 | CHECK | 52 | 8-WSON (6x5) | https://www.winbond.com/resource-files/w25q32jv%20revg%2003272018%20plus.pdf | https://www.digikey.com/en/products/detail/winbond-electronics/W25Q32JVZPIQ/6167525 | exact |  |  |  |  |  |  |  |  | DFN-S-8 6x5 = WSON-8 (ZP)
Y1 | 1 | 5 | ABM10-167-12.000MHZ-T3 | fmcw3:ABM10 | mpn | Active | Active | ABM10-167-12.000MHZ-T3 | Abracon LLC | 535-13521-1-ND | 19864 | yes | 14 | 4-SMD (2.5x2) | https://abracon.com/Resonators/ABM10-167-12.000MHz.pdf | https://www.digikey.com/en/products/detail/abracon-llc/ABM10-167-12-000MHZ-T3/6140264 | exact |  |  |  |  |  |  |  |  | crystal
Z1 | 1 | 5 | 15dB COUPLER | fmcw3:coupler | nopart | no-part |  |  |  |  |  | n/a |  |  |  |  |  |  |  |  |  |  |  |  |  | printed 15 dB coupler (PCB copper, footprint 'coupler')
