davidmhunt/fmcw3/parts/fields_to_apply.csv

ref | kind | Manufacturer | MPN | DigiKey PN | Status | Package | Tolerance | Voltage | Dielectric | spec_only | basis
C23 | generic |  |  |  |  | 0402 | unspecified | >=6.3 V (inferred default: no supply rail on these nets) | unspecified | yes | value+footprint from schematic; voltage inferred from net; tolerance/dielectric unspecified
C30 | generic |  |  |  |  | 0402 | unspecified | >=6.3 V (inferred default: no supply rail on these nets) | unspecified | yes | value+footprint from schematic; voltage inferred from net; tolerance/dielectric unspecified
C32 | generic |  |  |  |  | 0402 | unspecified | >=6.3 V (inferred default: no supply rail on these nets) | unspecified | yes | value+footprint from schematic; voltage inferred from net; tolerance/dielectric unspecified
C90 | generic |  |  |  |  | 0402 | unspecified | >=6.3 V (inferred default: no supply rail on these nets) | unspecified | yes | value+footprint from schematic; voltage inferred from net; tolerance/dielectric unspecified
C91 | generic |  |  |  |  | 0402 | unspecified | >=6.3 V (inferred default: no supply rail on these nets) | unspecified | yes | value+footprint from schematic; voltage inferred from net; tolerance/dielectric unspecified
C92 | generic |  |  |  |  | 0402 | unspecified | >=6.3 V (inferred default: no supply rail on these nets) | unspecified | yes | value+footprint from schematic; voltage inferred from net; tolerance/dielectric unspecified
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
C182 | generic |  |  |  |  | 1206 | unspecified | >=6.3 V (inferred: 3.3 V on 3V3D) | unspecified | yes | value+footprint from schematic; voltage inferred from net; tolerance/dielectric unspecified
C184 | generic |  |  |  |  | 1206 | unspecified | >=6.3 V (inferred: 3.3 V on 3V3D) | unspecified | yes | value+footprint from schematic; voltage inferred from net; tolerance/dielectric unspecified
C196 | generic |  |  |  |  | 1206 | unspecified | >=6.3 V (inferred: 3.3 V on 3V3D) | unspecified | yes | value+footprint from schematic; voltage inferred from net; tolerance/dielectric unspecified
C183 | generic |  |  |  |  | 0805 | unspecified | >=6.3 V (inferred: 3.3 V on 3V3D) | unspecified | yes | value+footprint from schematic; voltage inferred from net; tolerance/dielectric unspecified
C185 | generic |  |  |  |  | 0805 | unspecified | >=6.3 V (inferred: 3.3 V on 3V3D) | unspecified | yes | value+footprint from schematic; voltage inferred from net; tolerance/dielectric unspecified
C186 | generic |  |  |  |  | 0805 | unspecified | >=6.3 V (inferred: 3.3 V on 3V3D) | unspecified | yes | value+footprint from schematic; voltage inferred from net; tolerance/dielectric unspecified
C188 | generic |  |  |  |  | 0805 | unspecified | >=6.3 V (inferred: 3.3 V on 3V3D) | unspecified | yes | value+footprint from schematic; voltage inferred from net; tolerance/dielectric unspecified
C194 | generic |  |  |  |  | 0805 | unspecified | >=6.3 V (inferred: 3.3 V on 3V3D) | unspecified | yes | value+footprint from schematic; voltage inferred from net; tolerance/dielectric unspecified
C195 | generic |  |  |  |  | 0805 | unspecified | >=6.3 V (inferred: 3.3 V on 3V3D) | unspecified | yes | value+footprint from schematic; voltage inferred from net; tolerance/dielectric unspecified
C208 | generic |  |  |  |  | 0402 | unspecified | >=6.3 V (inferred default: no supply rail on these nets) | unspecified | yes | value+footprint from schematic; voltage inferred from net; tolerance/dielectric unspecified
C209 | generic |  |  |  |  | 0402 | unspecified | >=6.3 V (inferred default: no supply rail on these nets) | unspecified | yes | value+footprint from schematic; voltage inferred from net; tolerance/dielectric unspecified
CON1 | mpn | Hirose Electric Co Ltd | DM3BT-DSF-PEJS | HR1942CT-ND |  |  |  |  |  | no | exact MPN, DigiKey lookup
CON2 | mpn | MPD (Memory Protection Devices) | EJ508A | EJ508A-ND |  |  |  |  |  | no | exact MPN, DigiKey lookup
D1 | generic |  |  |  |  | 0603 | n/a |  |  | yes | value+footprint from schematic; voltage inferred from net; tolerance/dielectric unspecified
D6 | generic |  |  |  |  | 0603 | n/a |  |  | yes | value+footprint from schematic; voltage inferred from net; tolerance/dielectric unspecified
D2 | mpn | onsemi | SS13FL | 2832-SS13FLTR-ND | Obsolete: see docs/hardware/fmcw3 memo |  |  |  |  | no | exact MPN, DigiKey lookup
D3 | mpn | onsemi | SS13FL | 2832-SS13FLTR-ND | Obsolete: see docs/hardware/fmcw3 memo |  |  |  |  | no | exact MPN, DigiKey lookup
D4 | mpn | onsemi | SS13FL | 2832-SS13FLTR-ND | Obsolete: see docs/hardware/fmcw3 memo |  |  |  |  | no | exact MPN, DigiKey lookup
FB1 | mpn | Murata Electronics | BLM18PG181SN1D | 490-5263-1-ND |  |  |  |  |  | no | exact MPN, DigiKey lookup
FB2 | mpn | Murata Electronics | BLM18PG181SN1D | 490-5263-1-ND |  |  |  |  |  | no | exact MPN, DigiKey lookup
FB3 | mpn | Murata Electronics | BLM18PG181SN1D | 490-5263-1-ND |  |  |  |  |  | no | exact MPN, DigiKey lookup
FB5 | mpn | Murata Electronics | BLM18PG181SN1D | 490-5263-1-ND |  |  |  |  |  | no | exact MPN, DigiKey lookup
FB6 | mpn | Murata Electronics | BLM18PG181SN1D | 490-5263-1-ND |  |  |  |  |  | no | exact MPN, DigiKey lookup
FB7 | mpn | Murata Electronics | BLM18PG181SN1D | 490-5263-1-ND |  |  |  |  |  | no | exact MPN, DigiKey lookup
FB8 | mpn | Murata Electronics | BLM18PG181SN1D | 490-5263-1-ND |  |  |  |  |  | no | exact MPN, DigiKey lookup
FB12 | mpn | Murata Electronics | BLM18PG181SN1D | 490-5263-1-ND |  |  |  |  |  | no | exact MPN, DigiKey lookup
FB13 | mpn | Murata Electronics | BLM18PG181SN1D | 490-5263-1-ND |  |  |  |  |  | no | exact MPN, DigiKey lookup
FB14 | mpn | Murata Electronics | BLM18PG181SN1D | 490-5263-1-ND |  |  |  |  |  | no | exact MPN, DigiKey lookup
FB4 | mpn | Samsung Electro-Mechanics | CIC21P101NE | 1276-6374-2-ND | Obsolete: see docs/hardware/fmcw3 memo |  |  |  |  | no | exact MPN, DigiKey lookup
FB11 | mpn | Samsung Electro-Mechanics | CIC21P101NE | 1276-6374-2-ND | Obsolete: see docs/hardware/fmcw3 memo |  |  |  |  | no | exact MPN, DigiKey lookup
L1 | mpn | Murata Electronics | LQW15AN9N9J80D | 490-7690-1-ND |  |  |  |  |  | no | exact MPN, DigiKey lookup
L3 | mpn | Murata Electronics | LQW15AN9N9J80D | 490-7690-1-ND |  |  |  |  |  | no | exact MPN, DigiKey lookup
L2 | generic |  |  |  | needs-David: see docs/hardware/fmcw3 memo | 0402 | unspecified |  |  | yes | value+footprint from schematic; voltage inferred from net; tolerance/dielectric unspecified
L4 | generic |  |  |  | needs-David: see docs/hardware/fmcw3 memo | 0402 | unspecified |  |  | yes | value+footprint from schematic; voltage inferred from net; tolerance/dielectric unspecified
L5 | mpn | Bourns Inc. | SRR6040A-330M | SRR6040A-330MCT-ND | NFND: see docs/hardware/fmcw3 memo |  |  |  |  | no | exact MPN, DigiKey lookup
L6 | mpn | Bourns Inc. | SRR6040A-330M | SRR6040A-330MCT-ND | NFND: see docs/hardware/fmcw3 memo |  |  |  |  | no | exact MPN, DigiKey lookup
L7 | mpn | Bourns Inc. | SRR6040A-330M | SRR6040A-330MCT-ND | NFND: see docs/hardware/fmcw3 memo |  |  |  |  | no | exact MPN, DigiKey lookup
L8 | generic |  |  |  |  | 0805 | unspecified |  |  | yes | value+footprint from schematic; voltage inferred from net; tolerance/dielectric unspecified
L9 | generic |  |  |  |  | 0805 | unspecified |  |  | yes | value+footprint from schematic; voltage inferred from net; tolerance/dielectric unspecified
L10 | generic |  |  |  |  | 0805 | unspecified |  |  | yes | value+footprint from schematic; voltage inferred from net; tolerance/dielectric unspecified
L11 | generic |  |  |  |  | 0805 | unspecified |  |  | yes | value+footprint from schematic; voltage inferred from net; tolerance/dielectric unspecified
P1 | mpn | TE Connectivity Linx | CONSMA003.062 | CONSMA003.062-ND |  |  |  |  |  | no | exact MPN, DigiKey lookup
P2 | mpn | TE Connectivity Linx | CONSMA003.062 | CONSMA003.062-ND |  |  |  |  |  | no | exact MPN, DigiKey lookup
P3 | generic |  |  |  |  | SMD 2x4 2.54 mm | n/a |  |  | yes | value+footprint from schematic; voltage inferred from net; tolerance/dielectric unspecified
P4 | generic |  |  |  |  | SMD 2x4 2.54 mm | n/a |  |  | yes | value+footprint from schematic; voltage inferred from net; tolerance/dielectric unspecified
Q1 | mpn | Rohm Semiconductor | RE1C002UNTCL | RE1C002UNTCLCT-ND |  |  |  |  |  | no | exact MPN, DigiKey lookup
R1 | generic |  |  |  |  | 0402 | unspecified |  |  | yes | value+footprint from schematic; voltage inferred from net; tolerance/dielectric unspecified
R3 | generic |  |  |  |  | 0402 | unspecified |  |  | yes | value+footprint from schematic; voltage inferred from net; tolerance/dielectric unspecified
R8 | generic |  |  |  |  | 0402 | unspecified |  |  | yes | value+footprint from schematic; voltage inferred from net; tolerance/dielectric unspecified
R4 | generic |  |  |  |  | 0402 | unspecified |  |  | yes | value+footprint from schematic; voltage inferred from net; tolerance/dielectric unspecified
R5 | generic |  |  |  |  | 0402 | unspecified |  |  | yes | value+footprint from schematic; voltage inferred from net; tolerance/dielectric unspecified
R6 | generic |  |  |  |  | 0402 | unspecified |  |  | yes | value+footprint from schematic; voltage inferred from net; tolerance/dielectric unspecified
R7 | generic |  |  |  |  | 0402 | unspecified |  |  | yes | value+footprint from schematic; voltage inferred from net; tolerance/dielectric unspecified
R18 | generic |  |  |  |  | 0402 | unspecified |  |  | yes | value+footprint from schematic; voltage inferred from net; tolerance/dielectric unspecified
R82 | generic |  |  |  |  | 0402 | unspecified |  |  | yes | value+footprint from schematic; voltage inferred from net; tolerance/dielectric unspecified
R112 | generic |  |  |  |  | 0402 | unspecified |  |  | yes | value+footprint from schematic; voltage inferred from net; tolerance/dielectric unspecified
R117 | generic |  |  |  |  | 0402 | unspecified |  |  | yes | value+footprint from schematic; voltage inferred from net; tolerance/dielectric unspecified
R118 | generic |  |  |  |  | 0402 | unspecified |  |  | yes | value+footprint from schematic; voltage inferred from net; tolerance/dielectric unspecified
R9 | generic |  |  |  | needs-David: see docs/hardware/fmcw3 memo | 0402 | unspecified |  |  | yes | value+footprint from schematic; voltage inferred from net; tolerance/dielectric unspecified
R11 | generic |  |  |  | needs-David: see docs/hardware/fmcw3 memo | 0402 | unspecified |  |  | yes | value+footprint from schematic; voltage inferred from net; tolerance/dielectric unspecified
R12 | generic |  |  |  | needs-David: see docs/hardware/fmcw3 memo | 0402 | unspecified |  |  | yes | value+footprint from schematic; voltage inferred from net; tolerance/dielectric unspecified
R10 | generic |  |  |  |  | 0402 | unspecified |  |  | yes | value+footprint from schematic; voltage inferred from net; tolerance/dielectric unspecified
R13 | generic |  |  |  |  | 0402 | unspecified |  |  | yes | value+footprint from schematic; voltage inferred from net; tolerance/dielectric unspecified
R15 | generic |  |  |  |  | 0402 | unspecified |  |  | yes | value+footprint from schematic; voltage inferred from net; tolerance/dielectric unspecified
R16 | generic |  |  |  |  | 0402 | unspecified |  |  | yes | value+footprint from schematic; voltage inferred from net; tolerance/dielectric unspecified
R38 | generic |  |  |  |  | 0402 | unspecified |  |  | yes | value+footprint from schematic; voltage inferred from net; tolerance/dielectric unspecified
R84 | generic |  |  |  |  | 0402 | unspecified |  |  | yes | value+footprint from schematic; voltage inferred from net; tolerance/dielectric unspecified
R85 | generic |  |  |  |  | 0402 | unspecified |  |  | yes | value+footprint from schematic; voltage inferred from net; tolerance/dielectric unspecified
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
R79 | generic |  |  |  |  | 0402 | unspecified |  |  | yes | value+footprint from schematic; voltage inferred from net; tolerance/dielectric unspecified
SW2 | mpn | Panasonic Industry | EVP-AWBA2A | P16850TR-ND | Obsolete: see docs/hardware/fmcw3 memo |  |  |  |  | no | exact MPN, DigiKey lookup
U1 | mpn | Analog Devices Inc. | ADF4158CCPZ | 505-ADF4158CCPZ-ND |  |  |  |  |  | no | exact MPN, DigiKey lookup
U2 | mpn | Texas Instruments | LP5907MFX-1.8/NOPB | 296-41463-1-ND |  |  |  |  |  | no | exact MPN, DigiKey lookup
U3 | mpn | Susumu | PAT1220-C-6DB-T5 | PAT126CT-ND |  |  |  |  |  | no | exact MPN, DigiKey lookup
U12 | mpn | Susumu | PAT1220-C-6DB-T5 | PAT126CT-ND |  |  |  |  |  | no | exact MPN, DigiKey lookup
U4 | mpn |  |  |  | needs-David: see docs/hardware/fmcw3 memo |  |  |  |  | no
U5 | mpn | onsemi | NC7S04P5X | NC7S04P5XCT-ND |  |  |  |  |  | no | exact MPN, DigiKey lookup
U6 | mpn | onsemi | NB3N551MNR4G | NB3N551MNR4GOSCT-ND | Obsolete: see docs/hardware/fmcw3 memo |  |  |  |  | no | exact MPN, DigiKey lookup
U7 | mpn | Texas Instruments | TLV172IDCKR | 296-48697-1-ND |  |  |  |  |  | no | exact MPN, DigiKey lookup
U8 | mpn |  |  |  | needs-David: see docs/hardware/fmcw3 memo |  |  |  |  | no
U9 | mpn | Texas Instruments | TRF37A73IDSGR | 296-48786-1-ND |  |  |  |  |  | no | exact MPN, DigiKey lookup
U13 | mpn | Texas Instruments | TRF37A73IDSGR | 296-48786-1-ND |  |  |  |  |  | no | exact MPN, DigiKey lookup
U10 | mpn | Analog Devices Inc. | HMC431LP4ETR | 1127-1036-1-ND |  |  |  |  |  | no | exact MPN, DigiKey lookup
U11 | mpn | Skyworks Solutions Inc. | SKY65404-31 | 863-1398-1-ND |  |  |  |  |  | no | exact MPN, DigiKey lookup
U16 | mpn | Skyworks Solutions Inc. | SKY65404-31 | 863-1398-1-ND |  |  |  |  |  | no | exact MPN, DigiKey lookup
U14 | mpn | Broadcom Limited | MGA-25203-BLKG | 516-2289-ND | Obsolete: see docs/hardware/fmcw3 memo |  |  |  |  | no | exact MPN, DigiKey lookup
U15 | mpn | TE Connectivity Linx | CONSMA003.062 | CONSMA003.062-ND |  |  |  |  |  | no | exact MPN, DigiKey lookup
U17 | mpn | STMicroelectronics | L7980TR | 497-10813-1-ND |  |  |  |  |  | no | exact MPN, DigiKey lookup
U18 | mpn | STMicroelectronics | L7980TR | 497-10813-1-ND |  |  |  |  |  | no | exact MPN, DigiKey lookup
U19 | mpn | STMicroelectronics | L7980TR | 497-10813-1-ND |  |  |  |  |  | no | exact MPN, DigiKey lookup
U20 | mpn | Texas Instruments | LP5907MFX-3.0/NOPB | 296-40357-1-ND |  |  |  |  |  | no | exact MPN, DigiKey lookup
U39 | mpn | Texas Instruments | LP5907MFX-3.0/NOPB | 296-40357-1-ND |  |  |  |  |  | no | exact MPN, DigiKey lookup
U21 | mpn | Texas Instruments | LP2985A-10DBVR | 296-24264-1-ND |  |  |  |  |  | no | exact MPN, DigiKey lookup
U22 | mpn | Texas Instruments | TPS7A9101DSKT | 296-45298-1-ND |  |  |  |  |  | no | exact MPN, DigiKey lookup
U23 | mpn | Texas Instruments | TPS7A9101DSKT | 296-45298-1-ND |  |  |  |  |  | no | exact MPN, DigiKey lookup
U24 | mpn | Texas Instruments | TPS7A9101DSKT | 296-45298-1-ND |  |  |  |  |  | no | exact MPN, DigiKey lookup
U25 | mpn | Microchip Technology | MIC5301-3.3YD5-TR | 576-2840-1-ND |  |  |  |  |  | no | exact MPN, DigiKey lookup
U26 | mpn | Johanson Technology Inc. | 5400BL15B0050001E | 712-5400BL15B0050001ECT-ND |  |  |  |  |  | no | exact MPN, DigiKey lookup
U27 | mpn | Johanson Technology Inc. | 5400BL15B0050001E | 712-5400BL15B0050001ECT-ND |  |  |  |  |  | no | exact MPN, DigiKey lookup
U28 | mpn | Johanson Technology Inc. | 5400BL15B0050001E | 712-5400BL15B0050001ECT-ND |  |  |  |  |  | no | exact MPN, DigiKey lookup
U29 | mpn | Analog Devices Inc. | ADL5802ACPZ-R7 | ADL5802ACPZ-R7CT-ND |  |  |  |  |  | no | exact MPN, DigiKey lookup
U30 | mpn | AMD | XC7A15T-1FTG256C | 122-1930-ND |  |  |  |  |  | no | exact MPN, DigiKey lookup
U31 | mpn |  |  |  | needs-David: see docs/hardware/fmcw3 memo |  |  |  |  | no
U32 | mpn | Microchip Technology | 93LC46BT-I/OT | 93LC46BT-I/OTCT-ND |  |  |  |  |  | no | exact MPN, DigiKey lookup
U33 | mpn | FTDI, Future Technology Devices International Ltd | FT2232HL-REEL | 768-1024-1-ND |  |  |  |  |  | no | exact MPN, DigiKey lookup
U34 | mpn | Analog Devices Inc. | ADA4940-2ACPZ-R7 | 505-ADA4940-2ACPZ-R7CT-ND |  |  |  |  |  | no | exact MPN, DigiKey lookup
U35 | mpn | Analog Devices Inc. | ADA4940-2ACPZ-R7 | 505-ADA4940-2ACPZ-R7CT-ND |  |  |  |  |  | no | exact MPN, DigiKey lookup
U40 | mpn | Winbond Electronics | W25Q32JVZPIQ | 256-W25Q32JVZPIQ-TUBE-ND | Obsolete: see docs/hardware/fmcw3 memo |  |  |  |  | no | exact MPN, DigiKey lookup
Y1 | mpn | Abracon LLC | ABM10-167-12.000MHZ-T3 | 535-13521-1-ND |  |  |  |  |  | no | exact MPN, DigiKey lookup
