davidmhunt/fmcw3/parts/datasheets/manifest.csv

MPN | key | refs | manufacturer | url | local_filename | sha256 | retrieved | status | mirrors | notes
DM3BT-DSF-PEJS |  | CON1 | Hirose Electric Co Ltd | https://www.hirose.com/product/download/?distributor=digikey&type=specSheet&lang=en&num=DM3BT-DSF-PEJS | DM3BT-DSF-PEJS.pdf | acc2594b1eca43381a9cf2905e4b9865dae7398562d894eb9a32612a29a4313b | 2026-09-30 | fetched
EJ508A |  | CON2 | MPD (Memory Protection Devices) | https://www.memoryprotectiondevices.com/datasheets/EJ508A/EJ508A-datasheet.pdf | EJ508A-datasheet.pdf | 71f8107da26a7def30b2d42122af2e2c6a6a653bd1b3798088db9164e33e675a | 2026-09-30 | fetched
SS13FL | ss13fl | D2;D3;D4 | onsemi | https://www.onsemi.com/pdf/datasheet/ss14fl-d.pdf | ss14fl-d.pdf | 0d6ebeb827eccbdec126406bdf36c0bd4a76215fbd6b4569a108120a1b436d40 | 2026-09-30 | fetched
BLM18PG181SN1D |  | FB1;FB2;FB3;FB5;FB6;FB7;FB8;FB12;FB13;FB14 | Murata Electronics | https://pim.murata.com/asset/pim4/ferriteBeadInductortypefilter/ENFA0003_PDF_FERRITEBEADINDUCTORTYPEFILTER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 | BLM18PG181SN1D.pdf | 82694c0ea97fe0d08407dbb680c179e1354f7103a48d03c11ee97ea0a4593876 | 2026-09-30 | fetched
CIC21P101NE | cic21 | FB4;FB11 | Samsung Electro-Mechanics | https://mm.digikey.com/Volume0/opasdata/d220001/medias/docus/2330/CIC21_ds.pdf | CIC21_ds.pdf | df15e8dc23ed0fbcb01d9bf19a268b66a6d15345d22ba57a425ba881bcceacdf | 2026-09-30 | fetched
LQW15AN9N9J80D |  | L1;L3 | Murata Electronics | https://pim.murata.com/asset/pim4/inductor/JELF243A-0100_PDF_INDUCTOR | LQW15AN9N9J80D.pdf | 2bca847ecc569c11674d6af7ab390ed19be23467d925f48e04e7800825cb0a7c | 2026-09-30 | fetched
SRR6040A-330M | srr6040a | L5;L6;L7 | Bourns Inc. | https://www.bourns.com/docs/Product-Datasheets/SRR6040A.pdf | SRR6040A.pdf | 23fd3511104e636e3bc54f9ad0dd6f5756245b5ec44f4d7690745b41bffbd360 | 2026-09-30 | fetched
CONSMA003.062 |  | P1;P2;U15 | TE Connectivity Linx | https://linxtechnologies.com/wp/wp-content/uploads/sma_rp-sma_specs.pdf | sma_rp-sma_specs.pdf |  |  | unreachable |  | note: file name suggests an RP-SMA family spec; confirm it covers CONSMA003.062 (standard SMA edge mount) when pulled
RE1C002UNTCL |  | Q1 | Rohm Semiconductor | https://fscdn.rohm.com/en/products/databook/datasheet/discrete/transistor/mosfet/re1c002untcl-e.pdf | re1c002untcl-e.pdf | 55cb3637d7d88357ba7de26af070392291146e1beb4629fffcff99aa9196c435 | 2026-09-30 | fetched
EVP-AWBA2A | evp | SW2 | Panasonic Industry | https://mm.digikey.com/Volume0/opasdata/d220001/medias/docus/2142/EVPAW.pdf | EVPAW.pdf | e990c92df0636f80b15304a40d7b23826eb1a20c2eb0659d5a00d838c6b5fc77 | 2026-09-30 | fetched
ADF4158CCPZ |  | U1 | Analog Devices Inc. | https://www.analog.com/media/en/technical-documentation/data-sheets/ADF4158.pdf | ADF4158.pdf | 2560d0cbf414267eb7b7776840c86d7d0fbf7990bf769ae4351f58a5678d3919 | 2026-09-30 | fetched
LP5907MFX-1.8/NOPB;LP5907MFX-3.0/NOPB |  | U2;U20;U39 | Texas Instruments | https://www.ti.com/lit/ds/symlink/lp5907.pdf | lp5907.pdf | f5deda2f0cd6f251622fa0fbb57fd0ddff831b797f96b9a0a53ed35059e1c4ba | 2026-09-30 | fetched
PAT1220-C-6DB-T5 |  | U3;U12 | Susumu | https://www.susumu.co.jp/common/pdf/n_catalog_partition16_en.pdf | n_catalog_partition16_en.pdf | c8399aff8f6ca27f8b392d1488c3db3061828da831ce9197d40da635fa6b50d2 | 2026-09-30 | fetched
NC7S04P5X |  | U5 | onsemi | https://www.onsemi.com/pub/Collateral/NC7S04-D.PDF | NC7S04-D.pdf | 0738c7fa4d9c60f144df0f8e1c690b6a691c98a32a18d3e41380f1ac23f114eb | 2026-09-30 | fetched
NB3N551MNR4G |  | U6 | onsemi | https://mm.digikey.com/Volume0/opasdata/d220001/medias/docus/7560/NB3N551DR2G%20%281%29.pdf | NB3N551_ds.pdf | 1baa7951fc0a3ea8e8c069e2bc48dddefafabf28dcef199eb355a3aa801e3b88 | 2026-09-30 | fetched
TLV172IDCKR |  | U7 | Texas Instruments | https://www.ti.com/lit/ds/symlink/tlv172.pdf | tlv172.pdf | 54f3b511c86fd2fc6ed1ee4e83f9c5345ec0b950b4411c7c287dd6350f7829f4 | 2026-09-30 | fetched
TRF37A73IDSGR |  | U9;U13 | Texas Instruments | https://www.ti.com/lit/ds/symlink/trf37a73.pdf | trf37a73.pdf | 776e5945eda48dd1008366ac0589030f2c740e1184d61d64e4ade5759cf564e3 | 2026-09-30 | fetched
HMC431LP4ETR |  | U10 | Analog Devices Inc. | https://www.analog.com/media/en/technical-documentation/data-sheets/hmc431.pdf | hmc431.pdf | c5a1cde939a0c30b5d200990fa0f1a031a676259f3117d4b0f658ed781eba5dc | 2026-09-30 | fetched
SKY65404-31 |  | U11;U16 | Skyworks Solutions Inc. | https://www.skyworksinc.com/-/media/5C3EBEFF9AA745DDA3613C3EA77D7ADB.pdf | SKY65404-31.pdf | 1825735b6ad3aec564f7fc7a6d0f6ef29e3ce2be7b88fff5b2224526b8457f13 | 2026-09-30 | fetched
MGA-25203-BLKG | mga | U14 | Broadcom Limited | https://docs.rs-online.com/1583/0900766b812f924c.pdf | MGA-25203_ds.pdf | f68ee90e421cfaa14d1a916d458e08763eedc0a6a907eb6424b9aa56a3c3b5ac | 2026-09-30 | fetched
L7980TR |  | U17;U18;U19 | STMicroelectronics | https://www.st.com/resource/en/datasheet/l7980.pdf | l7980.pdf | b7f105882a98b839ff8e15f0b47fda897746f7f88454b9de9475bfcddcc9a49b | 2026-09-30 | fetched
LP2985A-10DBVR |  | U21 | Texas Instruments | https://www.ti.com/lit/ds/symlink/lp2985.pdf | lp2985.pdf | 29a9758cb28a12c1990cb8dba96cb792554906f00fe625aa310bc6cd6ea3f26f | 2026-09-30 | fetched
TPS7A9101DSKT |  | U22;U23;U24 | Texas Instruments | https://www.ti.com/lit/ds/symlink/tps7a91.pdf | tps7a91.pdf | b824121af123ed0cc8240cb7a9fc6d83d51fedaf3b3a8083e8f2be576206c1e7 | 2026-09-30 | fetched
MIC5301-3.3YD5-TR |  | U25 | Microchip Technology | https://ww1.microchip.com/downloads/en/DeviceDoc/mic5301.pdf | mic5301.pdf | 9b64563312cfa7ff00d64b87fbf4c3c53e0f9ef2a0b57b5bb50479463f340ece | 2026-09-30 | fetched
5400BL15B0050001E |  | U26;U27;U28 | Johanson Technology Inc. | https://www.johansontechnology.com/datasheets/5400BL15B050/5400BL15B050.pdf | 5400BL15B050.pdf | 523539ab176758a7df02bae64647b2f0b4163459f27bccdc36fc9469f9420442 | 2026-09-30 | fetched
ADL5802ACPZ-R7 |  | U29 | Analog Devices Inc. | https://www.analog.com/media/en/technical-documentation/data-sheets/ADL5802.pdf | ADL5802.pdf | 4b435a1df5354bf63e68a6c213d64ff1f4d6c570fc74160e793608564a8fb7c2 | 2026-09-30 | fetched
XC7A15T-1FTG256C |  | U30 | AMD | https://docs.amd.com/v/u/en-US/ds180_7Series_Overview | ds180_7Series_Overview.pdf | c59daf6779821b478788c145643fc1e2d0b742d5cc3249b516c79bba424101a1 | 2026-09-30 | fetched | https://www.farnell.com/datasheets/2553941.pdf|https://www.eng.auburn.edu/~nelson/courses/elec4200/FPGA/ds180_7Series_Overview.pdf | mirror is DS180 v2.5 (2017); newer revisions at the vendor URL
93LC46BT-I/OT | mc93 | U32 | Microchip Technology | https://ww1.microchip.com/downloads/en/DeviceDoc/20001749K.pdf | 93XX46ABC_20001749K.pdf | 979133d99be10a4839c438e3c6d8a45ee861f94289722210a92b94b5434c042b | 2026-09-30 | fetched
FT2232HL-REEL | ft2232 | U33 | FTDI, Future Technology Devices International Ltd | https://ftdichip.com/wp-content/uploads/2025/11/DS_FT2232H.pdf | DS_FT2232H.pdf | fdad2bde5c68310de44e04860f325f0f1976a6b8facf5cd9b0656626f291544b | 2026-09-30 | fetched | https://www.farnell.com/datasheets/2066050.pdf|https://www.farnell.com/datasheets/327778.pdf | mirror is v2.3; vendor URL has v2.8+
ADA4940-2ACPZ-R7 |  | U34;U35 | Analog Devices Inc. | https://www.analog.com/media/en/technical-documentation/data-sheets/ADA4940-1_4940-2.pdf | ADA4940-1_4940-2.pdf | 6b693320b837e145ce5ac07b669329dbbe332eb2712c97793c7a8230bd87dbe8 | 2026-09-30 | fetched
W25Q32JVZPIQ | w25 | U40 | Winbond Electronics | https://www.winbond.com/resource-files/w25q32jv%20revg%2003272018%20plus.pdf | W25Q32JV.pdf | b2585095ac503e7cee7916ab3f025a51699b49e2cad7f6782e92b828c1cc09d8 | 2026-09-30 | fetched
ABM10-167-12.000MHZ-T3 |  | Y1 | Abracon LLC | https://abracon.com/Resonators/ABM10-167-12.000MHz.pdf | ABM10-167-12.000MHz.pdf | 7661b52ac01693f8d6c15db0e0405efca5b1f6fbeaf522a7d183897f4ec3e107 | 2026-09-30 | fetched
KT2520K40000DAW18TAS | kyo40 |  | Kyocera | https://mm.digikey.com/Volume0/opasdata/d220001/medias/docus/26/KT2520K40000DAW18TAS_Spec.pdf | KT2520K40000DAW18TAS_Spec.pdf | 5cfcdbcccfbd7c742eea70703e4c2f8c72806728d28d41c8241f2aa526d3ac8f | 2026-09-30 | fetched |  | U4 original (Obsolete, unresolved/needs-David; Datasheet field left as is)
TG2520SMN 40.0000M-ECGNNM0 | epson |  | Seiko Epson | https://download.epsondevice.com/td/pdf/brief/TG2016SMN_en.pdf | TG2016SMN_en.pdf | e70abee4adef9e668cfbe767d0943de7bb6dcdc0fa3403a8de28913000d3925f | 2026-09-30 | fetched |  | U4 candidate (brief; no phase noise)
TG2520SMN (full) |  |  | Seiko Epson | https://www5.epsondevice.com/en/products/tcxo/tg2520smn.html | TG2520SMN_product_page.html | ce106eb4730abbb95cf786961064db775a3b59dc8971b82225e045a39a49e320 | 2026-09-30 | fetched |  | U4 candidate full datasheet with phase noise: product page (HTML); use its datasheet link
SE5004L-R | se5004 |  | Skyworks Solutions Inc. | https://www.skyworksinc.com/-/media/2C9BF894D0E745E694030D0B4226B4E0.pdf | SE5004L.pdf | 3236a5ff9a30a2a7067775d4b8e55f0d9138a55b21282354a968649672dbbdf6 | 2026-09-30 | fetched |  | U14 candidate
SRR6838A-330M | srr6838a |  | Bourns Inc. | https://bourns.com/docs/product-datasheets/srr6838a.pdf | SRR6838A.pdf | f78b54b0d3016f83885b93ab3716cbf7b17b18067ef7e9b7c65bbf10488e55be | 2026-09-30 | fetched |  | L5-L7 candidate
SRN6045TA-330M | srn6045 |  | Bourns Inc. | https://www.bourns.com/docs/Product-Datasheets/SRN6045TA.pdf | SRN6045TA.pdf | a5144a82a215a9176eef5deb8baa5879f8a261f6cc56027fda4ac47c303905be | 2026-09-30 | fetched |  | L5-L7 candidate
BLM21PG121SN1D;BLM21PG221SN1D | blm21 |  | Murata Electronics | https://pim.murata.com/asset/pim4/ferriteBeadInductortypefilter/ENFA0005_PDF_FERRITEBEADINDUCTORTYPEFILTER | ENFA0005_BLM21P.pdf | 423ebf03ae5b5550b7f2f86b4832111972705d0ef721c650ec44a2129b5d6034 | 2026-09-30 | fetched |  | FB4/FB11 candidates
EVP-AWBD4A | evpd4 |  | Panasonic Industry | https://www3.panasonic.biz/ac/cdn/e/control/switch/light-touch/catalog/sw_lt_eng_3020s.pdf | sw_lt_eng_3020s.pdf | 905fc7e573b2795a070690c9c9674f864af395fc1bf005112dc4133341ceba27 | 2026-09-30 | fetched |  | SW2 candidate
MBR130LSFT1G | mbr130 |  | onsemi | https://www.onsemi.com/pdf/datasheet/mbr130lsft1-d.pdf | mbr130lsft1-d.pdf | 75431c4729230d063b9975f3035ce775cabdd65cef08c798665e0e9a2be05b21 | 2026-09-30 | fetched |  | D2-D4 candidate
DSS13U | dss13u |  | SMC Diode Solutions | https://www.smc-diodes.com/propdf/DSS12U%20THRU%20DSS125U%20N1873%20REV.A.pdf | DSS12U_THRU_DSS125U.pdf | 2c8741a71615c657c68b145829a06c57c4ed0c964944c00e940359345626611c | 2026-09-30 | fetched | https://datasheet.octopart.com/DSS14UTR-SMC-Diode-Solutions-datasheet-156002739.pdf | D2-D4 candidate; family datasheet (DSS12U thru DSS120U) via Octopart mirror
5PB1104CMG | r5pb |  | Renesas | https://www.renesas.com/us/en/document/dst/5pb11xx-family-datasheet | 5pb11xx-family-datasheet.pdf | 24ac8e22b754e383410c700b6187be6ec25dc684bd79c6841704dcde6a19438f | 2026-09-30 | fetched |  | U6 candidate
CDCLVC1104PW |  |  | Texas Instruments | https://www.ti.com/lit/ds/symlink/cdclvc1104.pdf | cdclvc1104.pdf | 7b5ccb44b8bc0016ad2ccc11335aaed807d6dd04dce0078dc0ea0fc196be7820 | 2026-09-30 | fetched |  | U6 candidate
MX25L3233FZNI-08G | mx25 |  | Macronix | https://www.macronix.com/Lists/Datasheet/Attachments/8933/MX25L3233F,%203V,%2032Mb,%20v1.7.pdf | MX25L3233F.pdf | c34badd3067e5f29ccc790fbf9d0e37ccc4b29d7f9384cc830bf478b96f2822d | 2026-09-30 | fetched |  | U40 candidate
IS25LP032D-JKLE | is25 |  | ISSI | https://www.issi.com/WW/pdf/25LP-WP032D.pdf | 25LP-WP032D.pdf | 7c0d9aae36858bb5ff61a34b5b8e278d052a51648e3097bd43830e532fef1b29 | 2026-09-30 | fetched |  | U40 candidate
LTC2292 | ltc2292 |  | Linear Technology / Analog Devices | https://mm.digikey.com/Volume0/opasdata/d220001/medias/docus/747/LTC2291-93_RevA_8-10-07.pdf | LTC2291-93_RevA.pdf | fd4f66ca71b66bbd56404a21468dffa49d8051921fbf2c3a4f525ac7d0fceac0 | 2026-09-30 | fetched |  | U8 (needs-David, C vs I grade; Datasheet field left as is)
629105136821 | wurth |  | Wurth Elektronik | https://www.we-online.com/catalog/datasheet/629105136821.pdf | 629105136821.pdf | 8e31b959aa98025dae836a9defdd251f9dedf206a7e17ae99ca426962b3ee447 | 2026-09-30 | fetched |  | U31 candidate
10118194-0001LF |  |  | Amphenol ICC | https://cdn.amphenol-cs.com/media/wysiwyg/files/documentation/datasheet/inputoutput/io_usb_micro.pdf | io_usb_micro.pdf |  |  | unreachable |  | U31 candidate
105017-0001 |  |  | Molex | https://www.molex.com/pdm_docs/sd/1050170001_sd.pdf | 1050170001_sd.pdf | 0f9a2c473931680b823f154528f671584077b75a098af873c9e9e6ebc3bad45c | 2026-09-30 | fetched | https://www.farnell.com/datasheets/1810930.pdf | U31 candidate; Farnell mirror (Molex product page, 2014)
47346-0001 |  |  | Molex | https://www.molex.com/en-us/products/part-detail/473460001?display=pdf | 473460001_sd.pdf | 1e78f9c1521e4012e3fdec7a7244862cbb1090ad30e23c95a7edad947ae62a79 | 2026-09-30 | fetched | https://www.farnell.com/datasheets/1630785.pdf|https://static.chipdip.ru/lib/086/DOC034086450.pdf | U31 candidate; Farnell mirror (Molex product page)
Artix-7 product table | avnet |  | Xilinx / AMD | https://www.avnet.com/fsp/opasdata/d120001/medias/docus/3/$v2/Xilinx_Artix7-Product-Table.pdf | Xilinx_Artix7-Product-Table.pdf | e0d3de4147cfb244c06d25968f3ed0269717f73ab87d9b120c2916589e73107e | 2026-09-30 | fetched |  | U30 migration (FTG256 table)
(blog) Third version of homemade 6 GHz FMCW radar | forsten |  | Forsten | https://hforsten.com/third-version-of-homemade-6-ghz-fmcw-radar.html | forsten_blog.html | 247304efb06c4488c6acc5a3f0caed9da385d57608cea78e20b692d66da50d6c | 2026-09-30 | fetched |  | memo source, not a datasheet
(README) matthuszagh/fmcw-radar | fork |  | matthuszagh | https://github.com/matthuszagh/fmcw-radar | fork_readme.org | 90dfec9a87f55993560e64b139b8ca7b33a9c3307301bd14585980d1a4f04d87 | 2026-09-30 | fetched | https://raw.githubusercontent.com/matthuszagh/fmcw-radar/master/README.org | memo source, not a datasheet
