davidmhunt/fmcw3/hardware/fmcw3.pdf

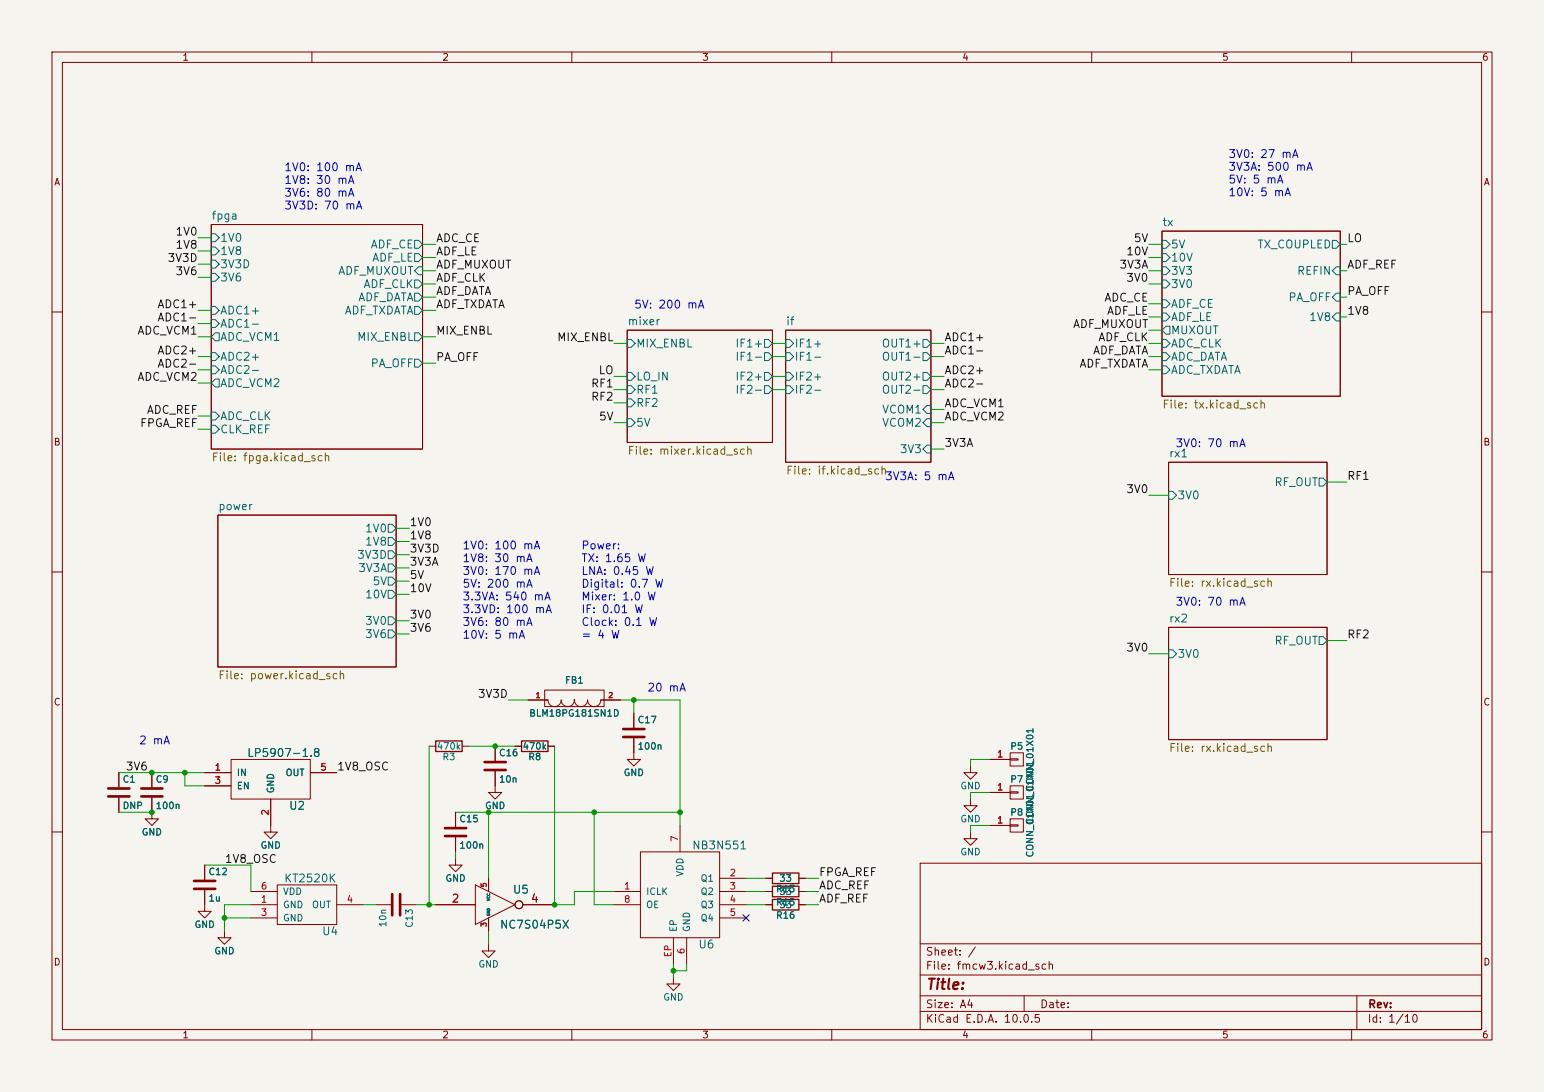
[picture p1: page 1]

Size: A4 | Rev:
KiCad E.D.A. 10.0.5 | Id: 1/10

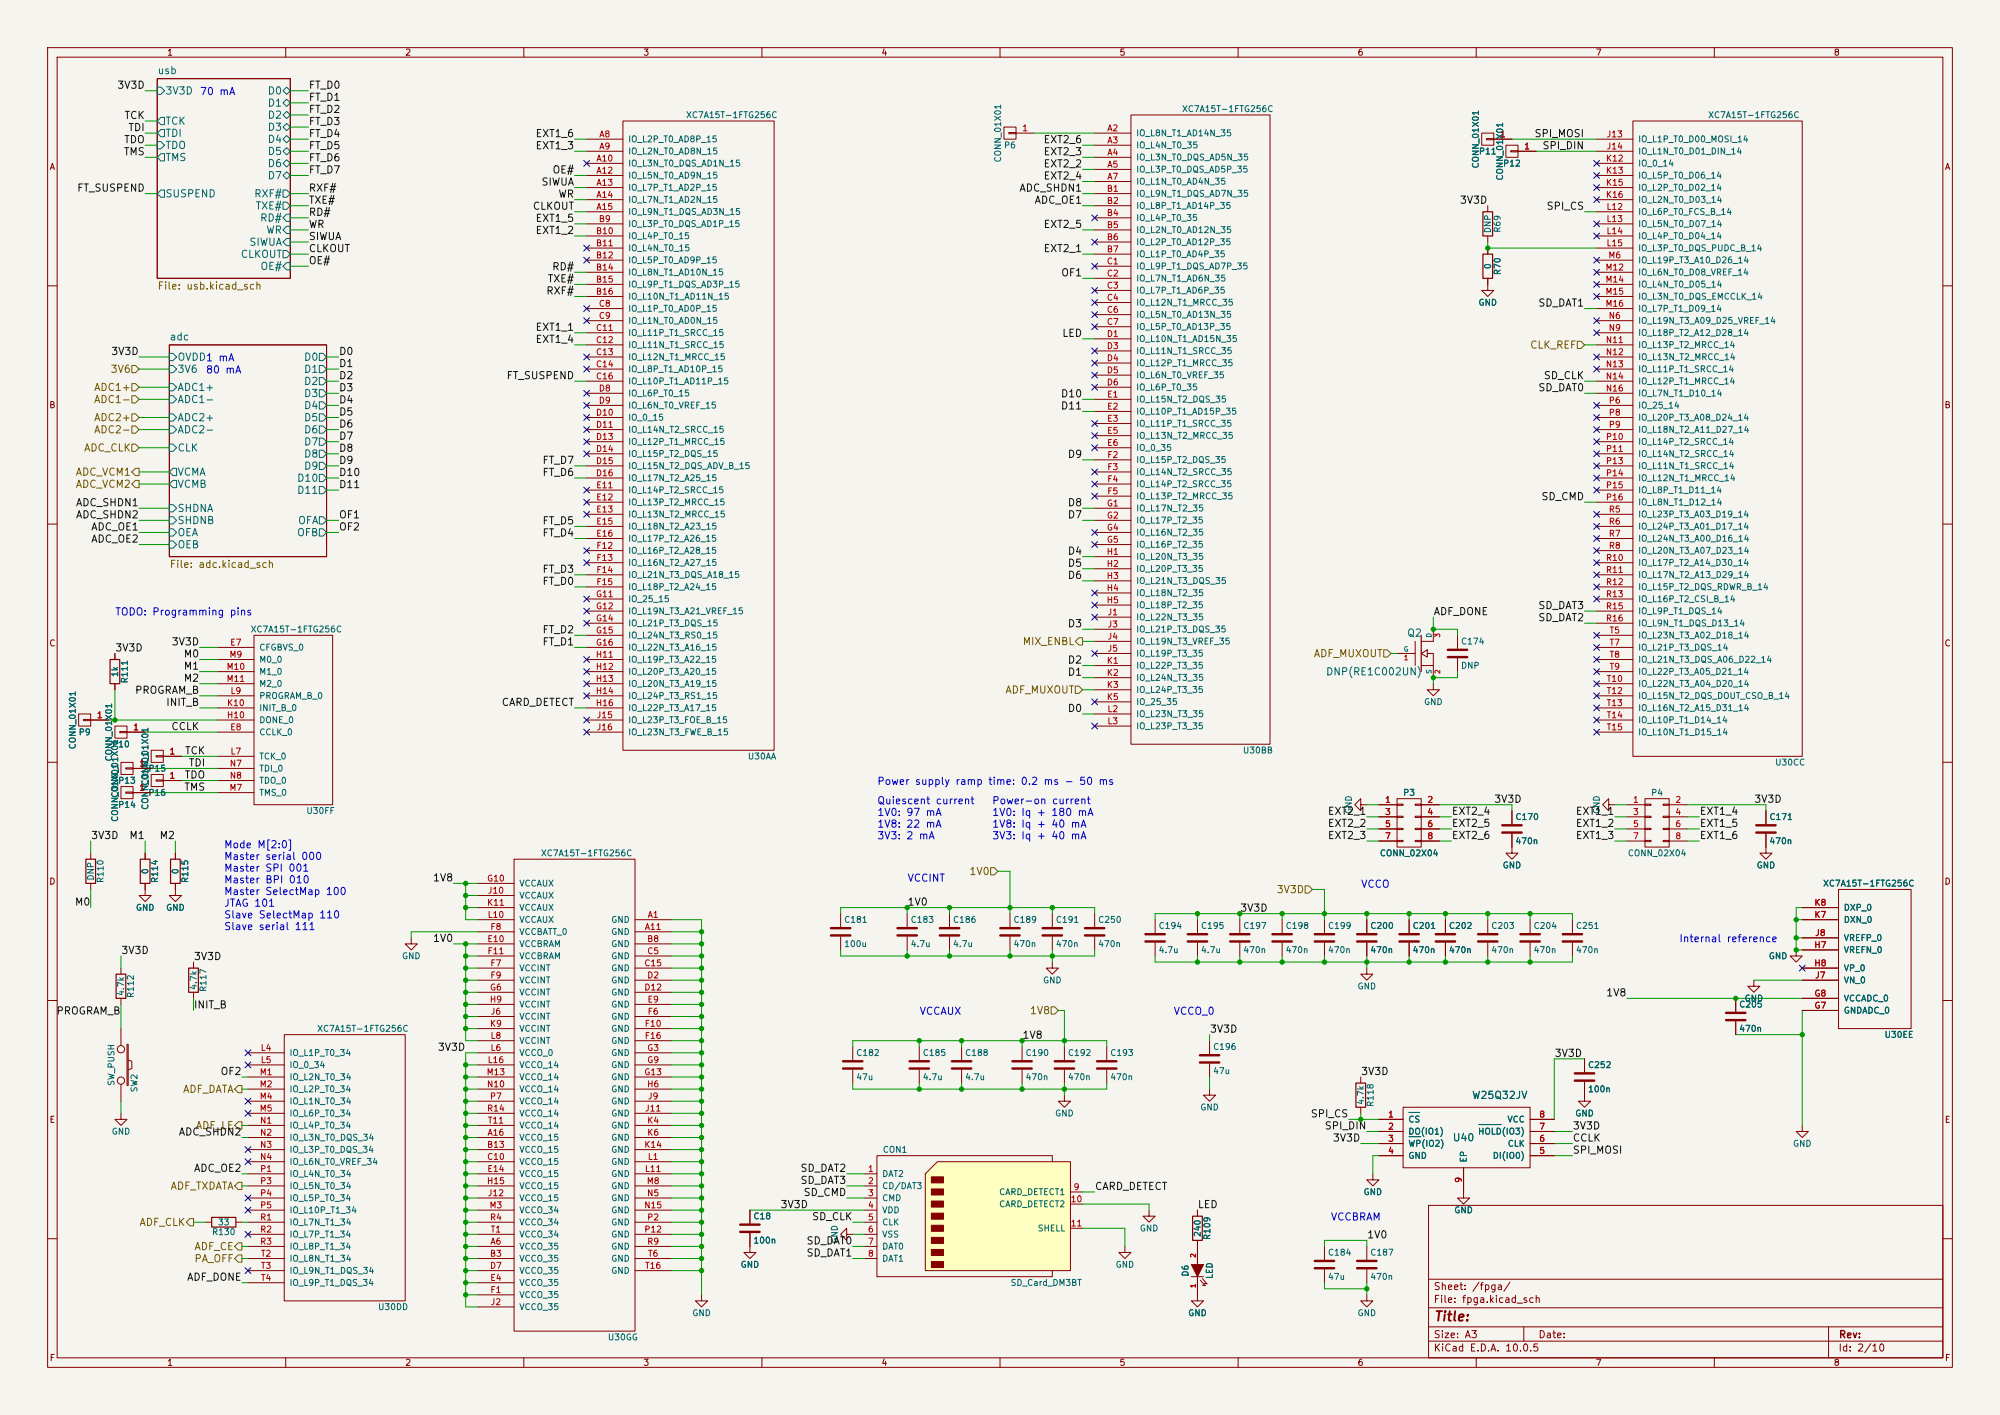
[picture p2: page 2]

1 P10 CONN_01X01
GND R115 0 R114 0 GND DNP R110 GND

Power supply ramp time: 0.2 ms - 50 ms Power-on current

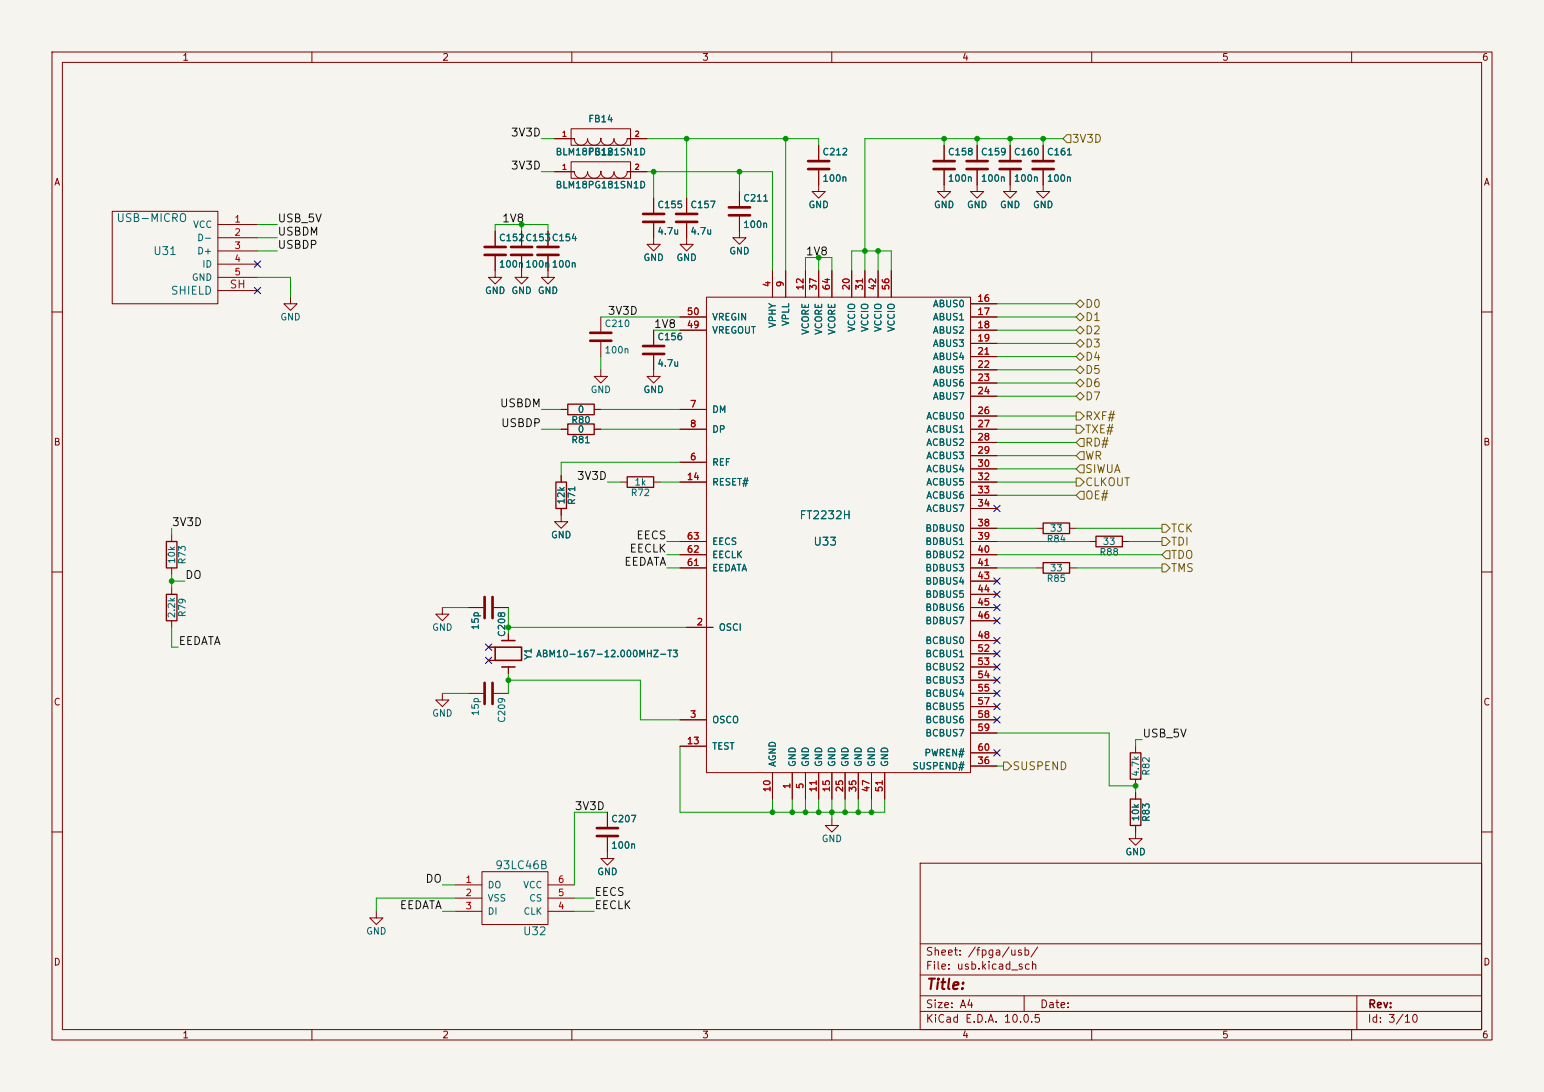
[picture p3: page 3]

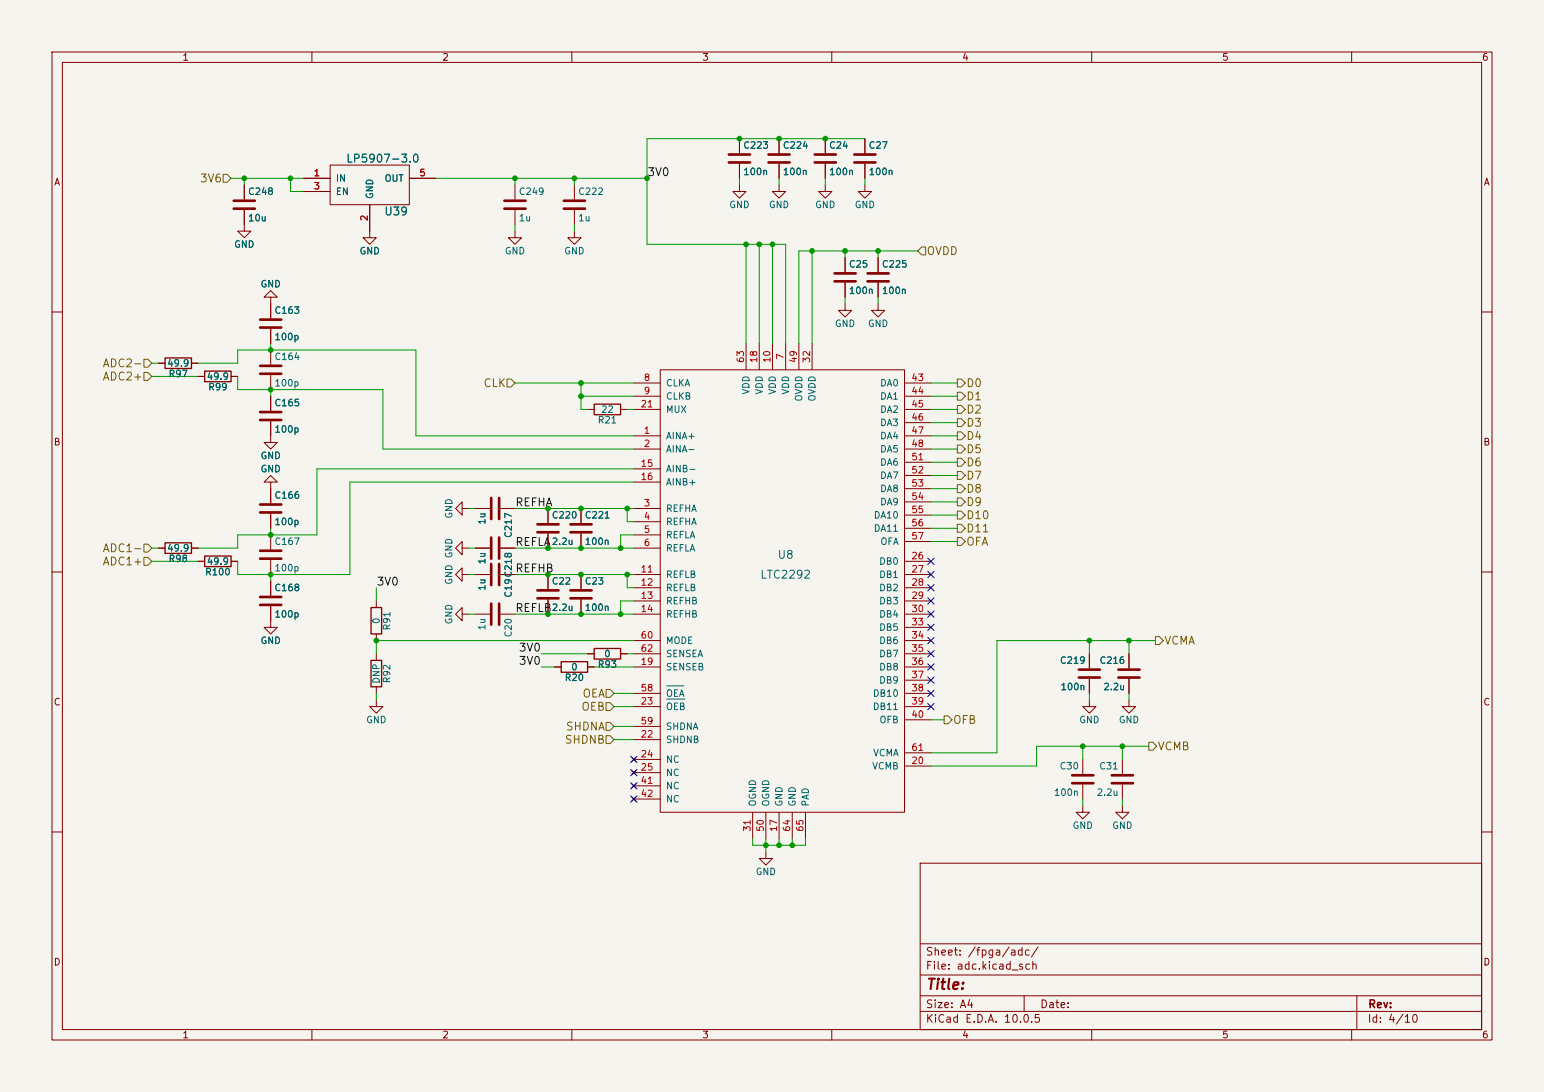
[picture p4: page 4]

7 CLKA 8 CLKB 9 VDD 10 REFLB 11 REFLB 12 REFHB 13 REFHB 14

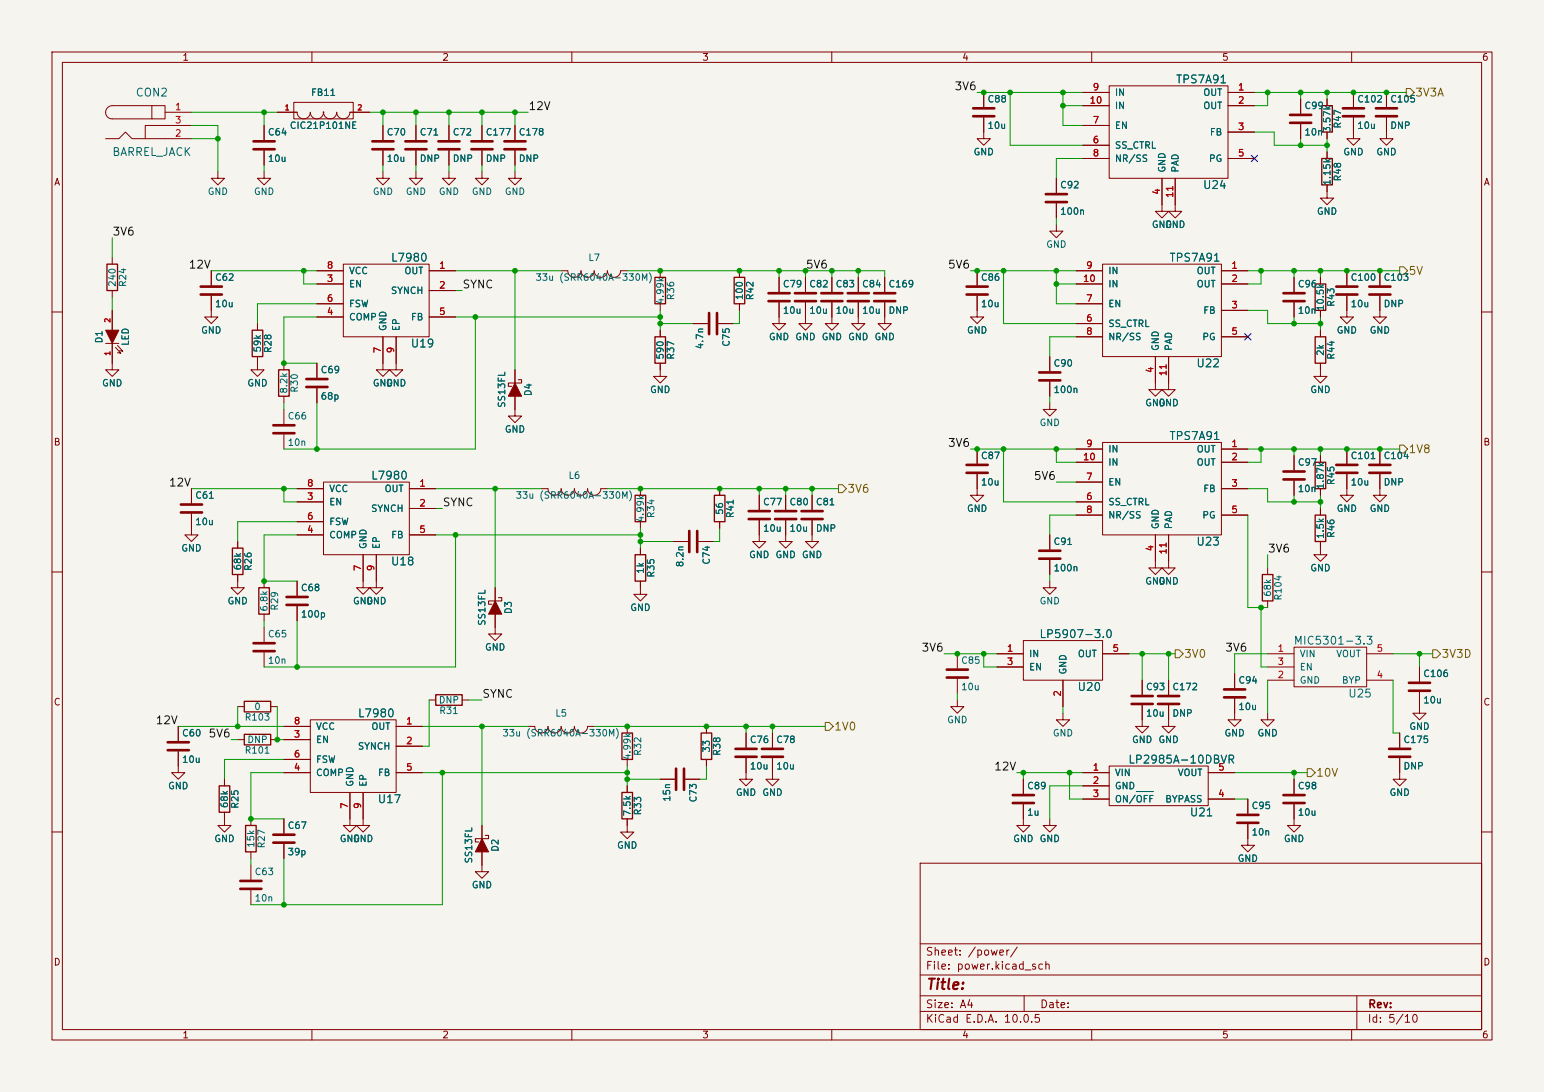
[picture p5: page 5]

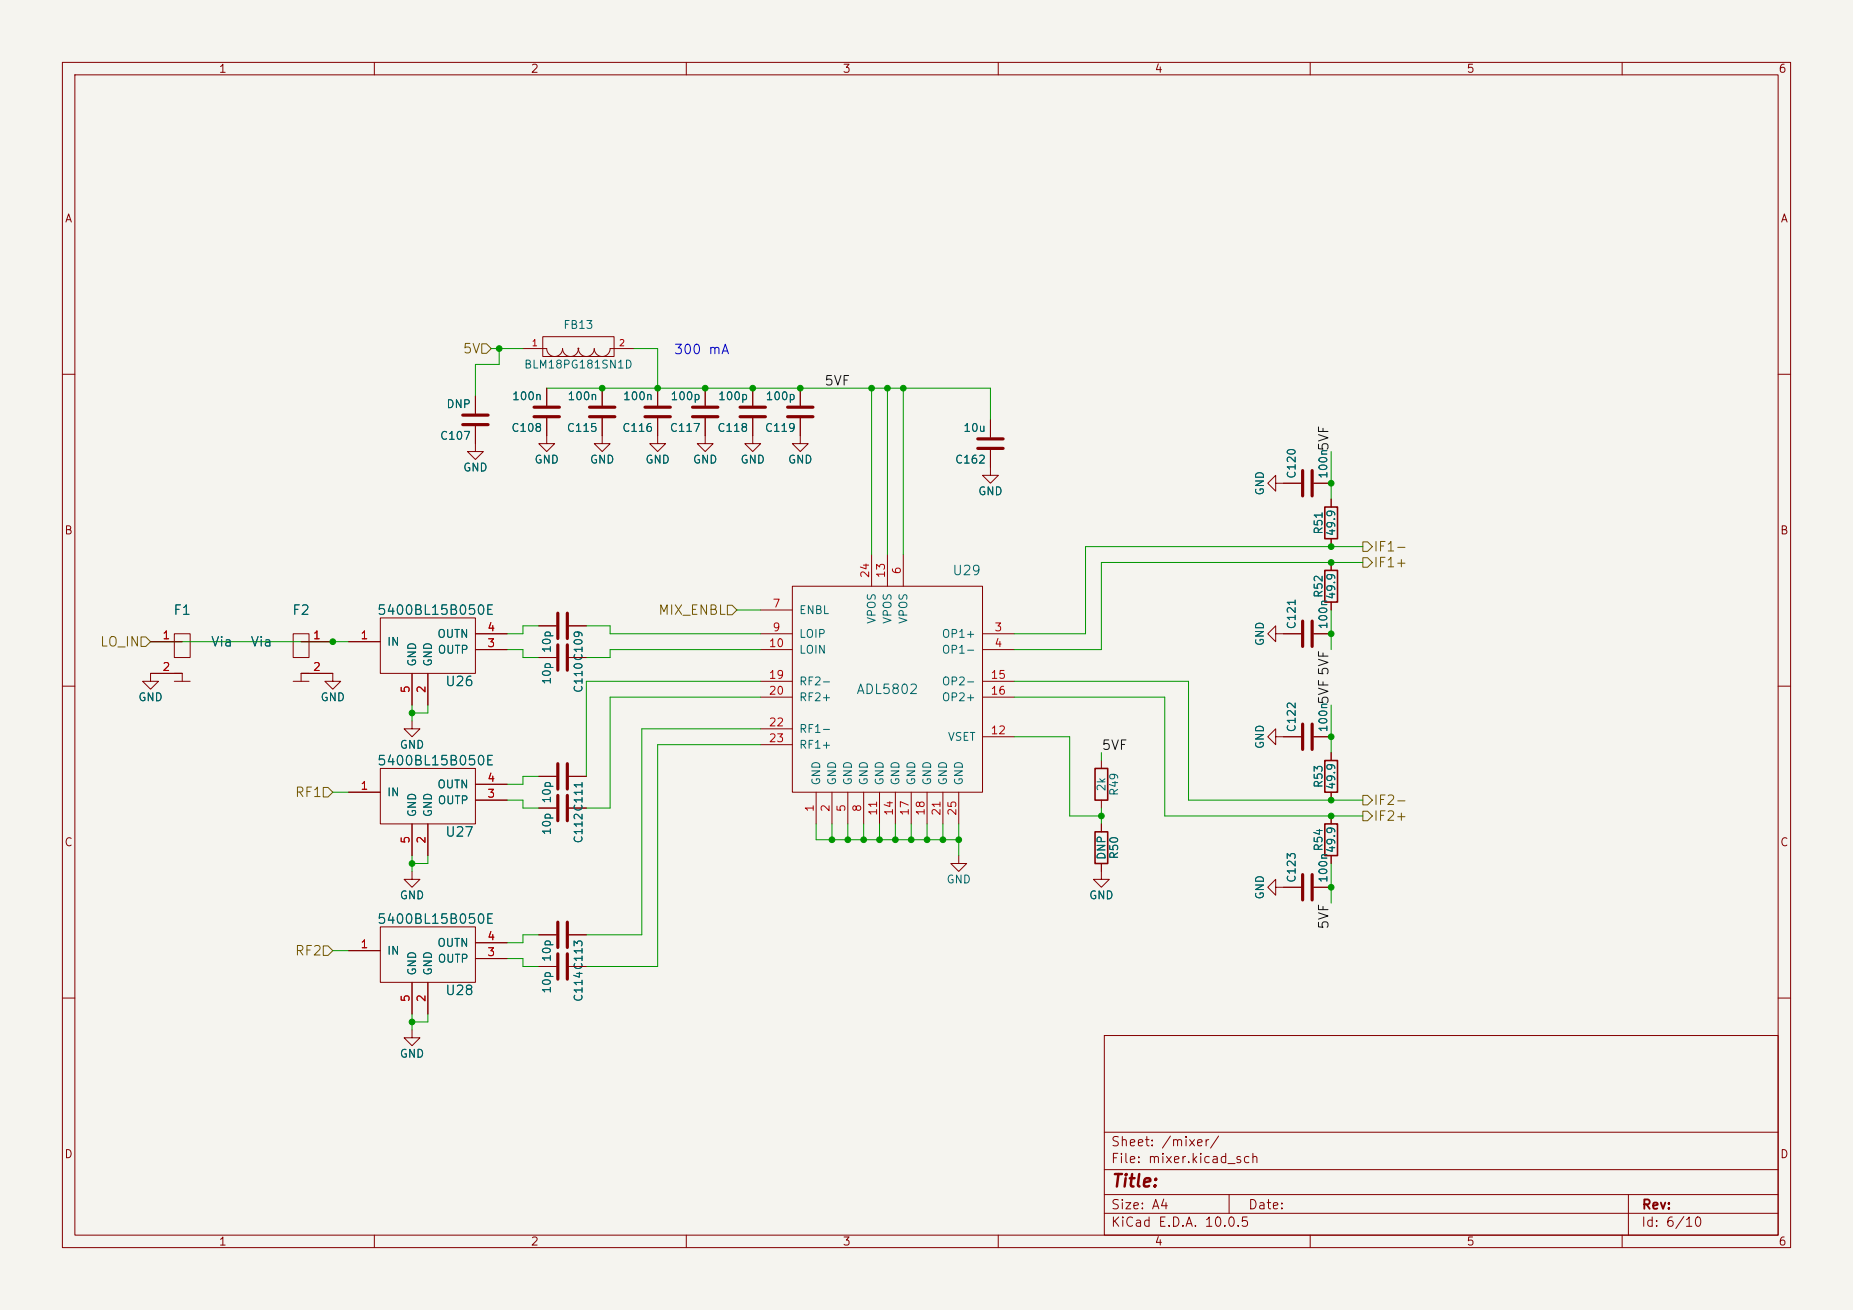
[picture p6: page 6]

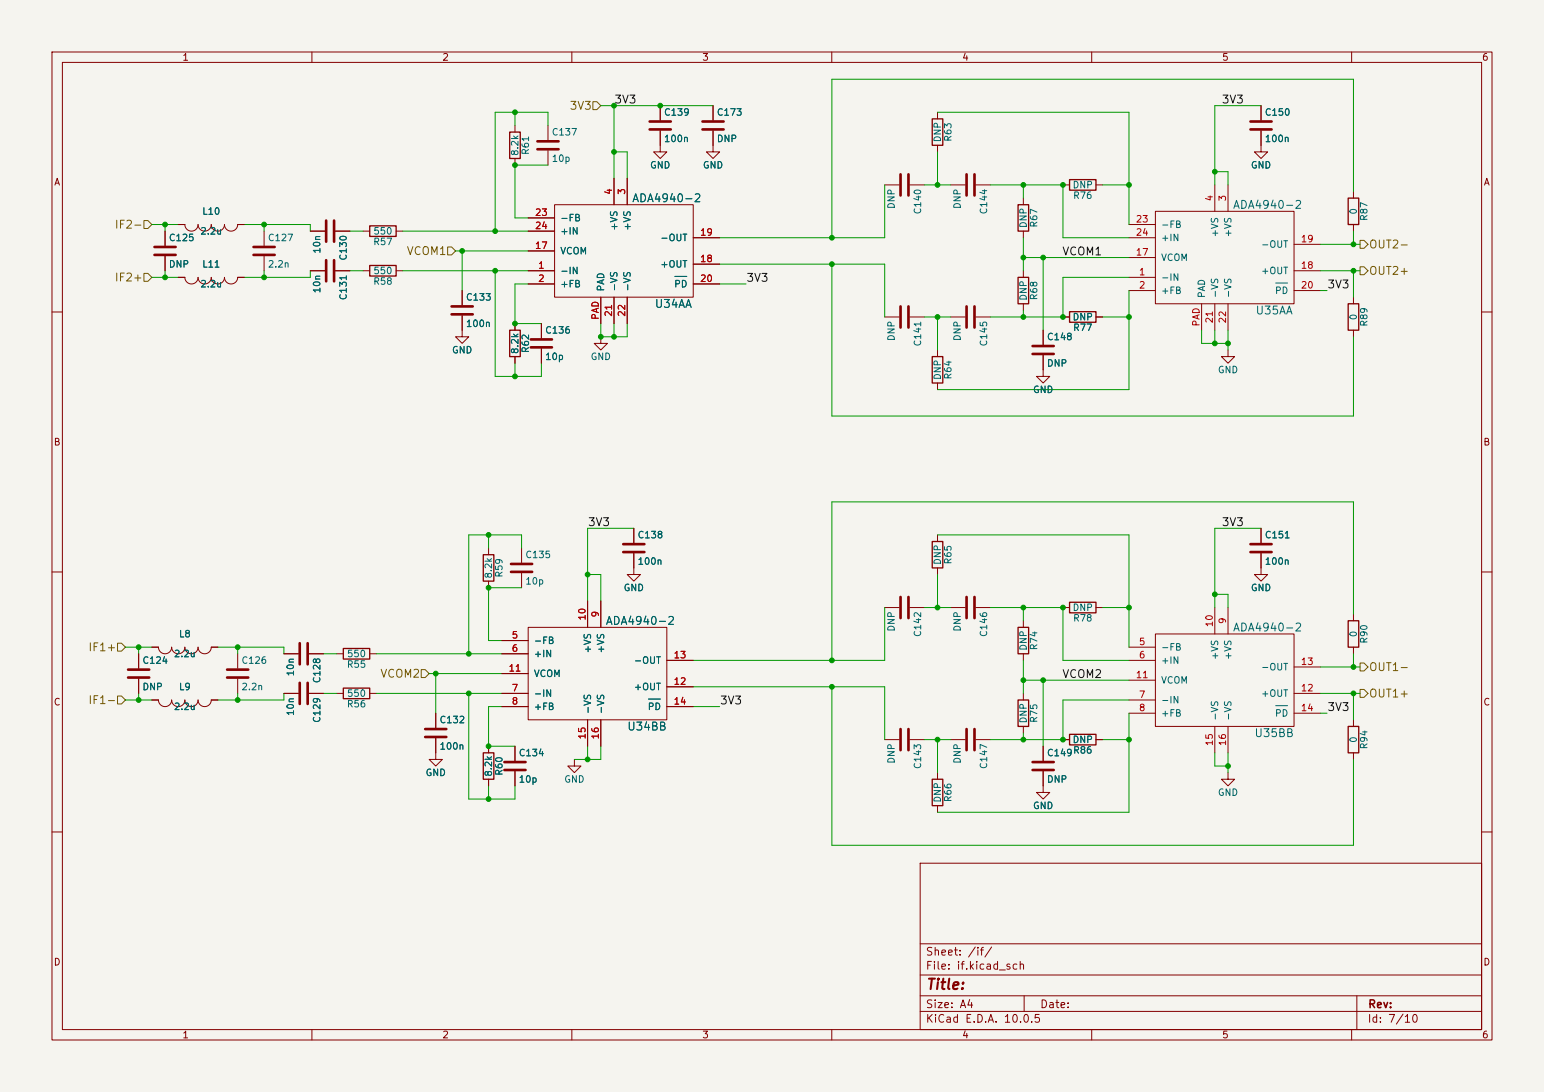
[picture p7: page 7]

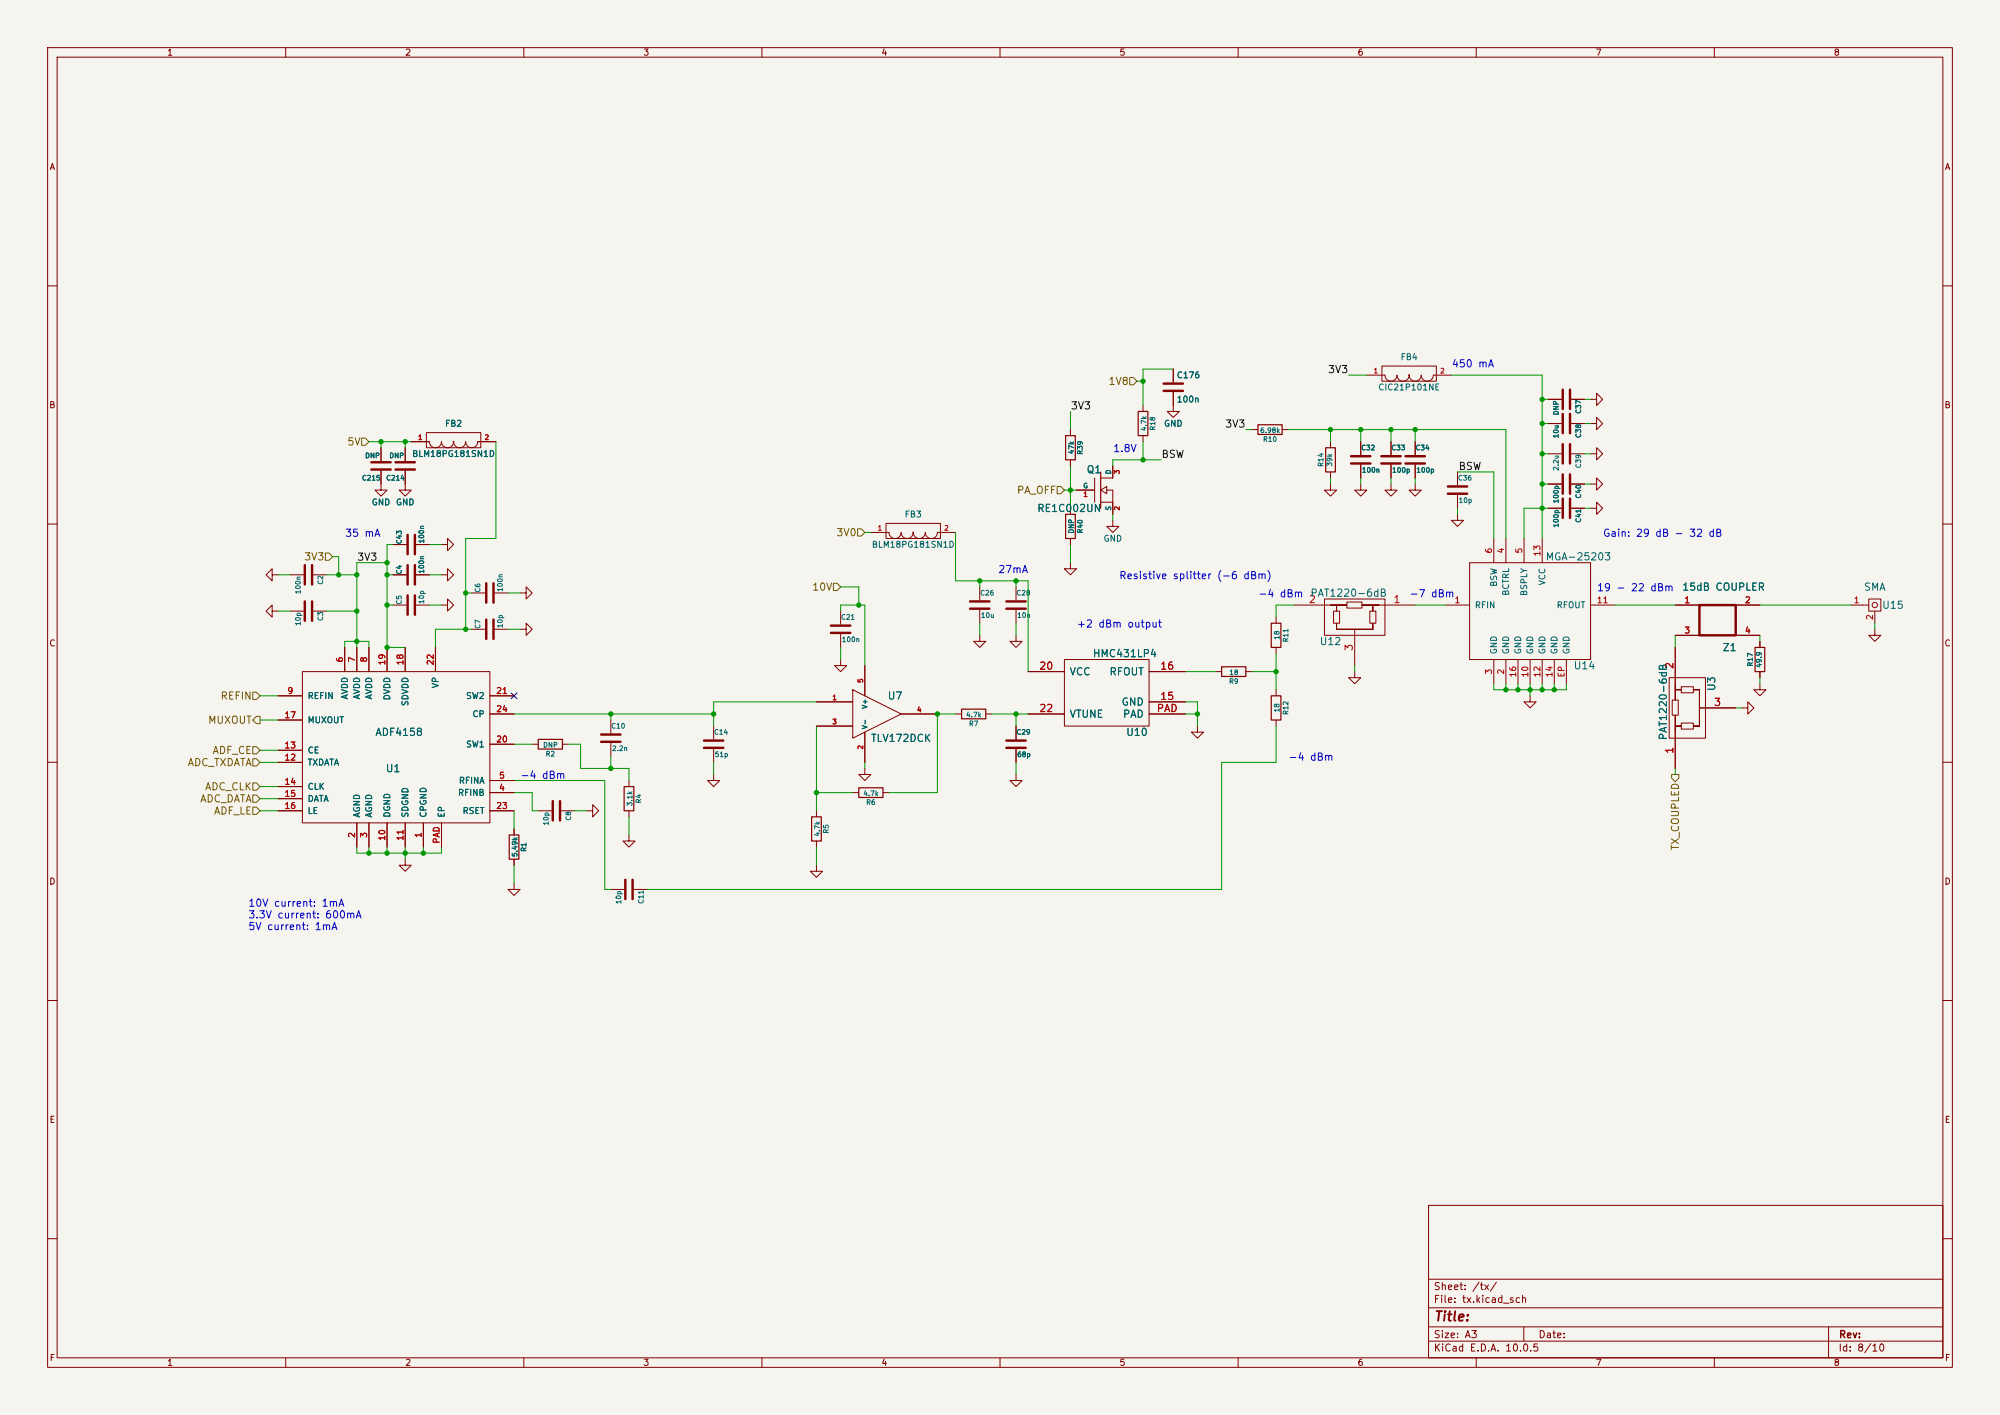
[picture p8: page 8]

6 GND 10 RFOUT 11 GND 12 VCC 13 GND 14 GND 16 GND EPU14

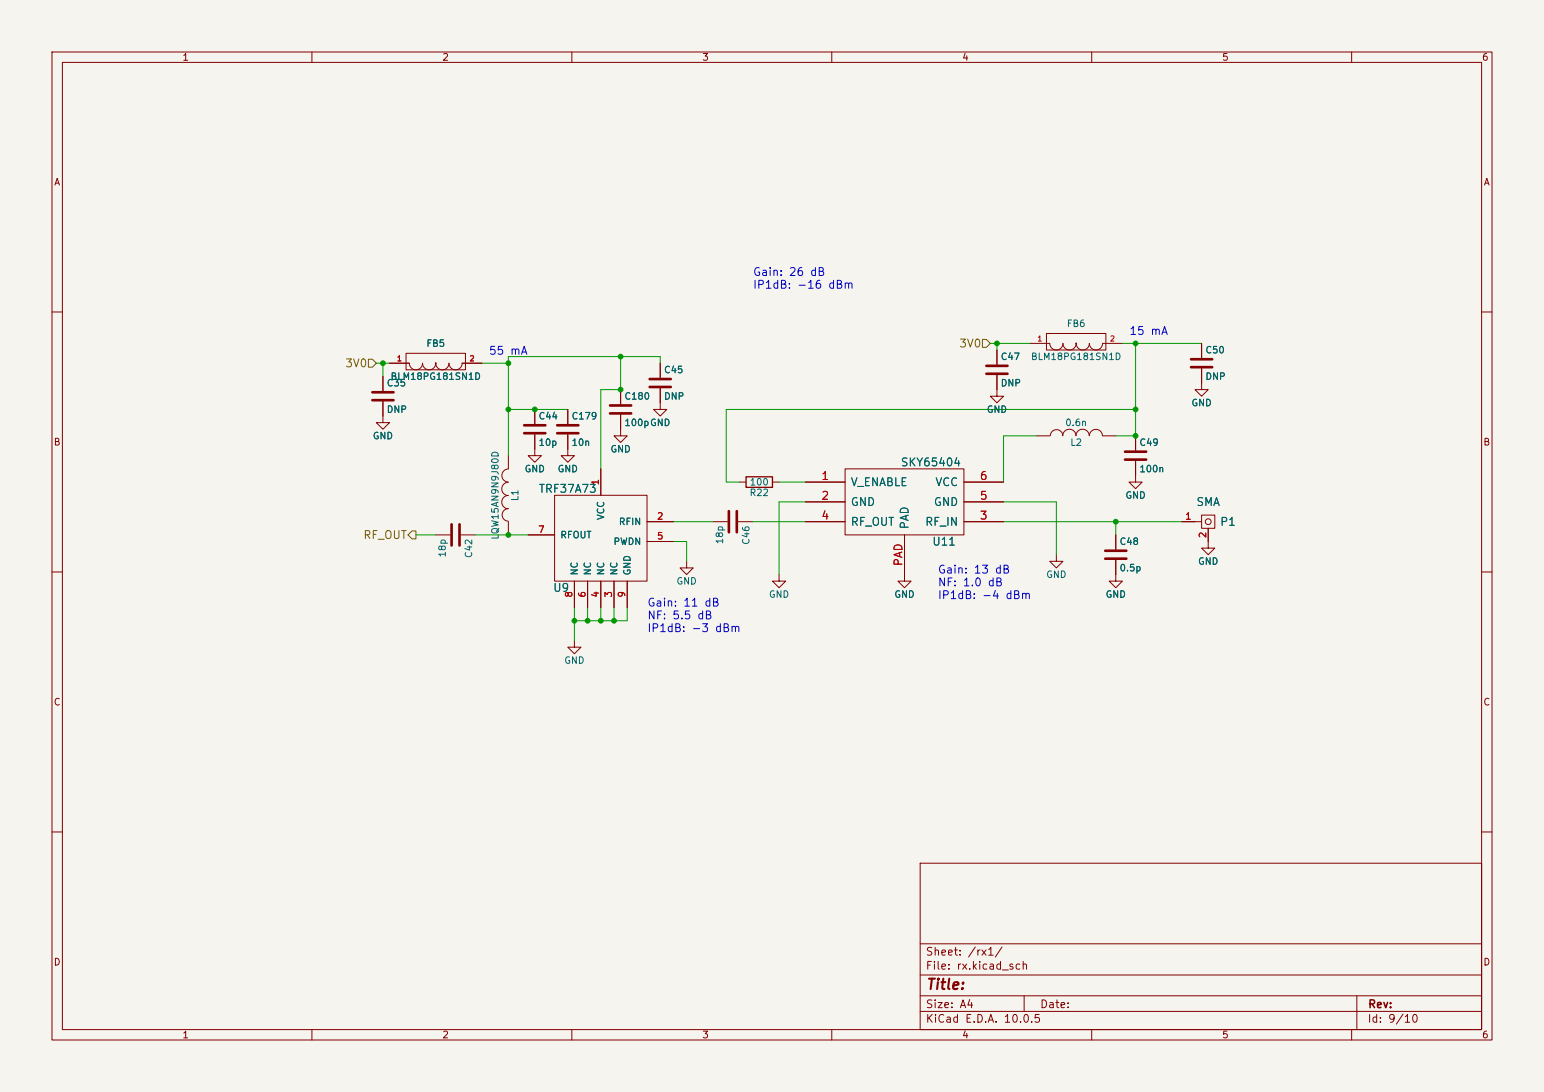
[picture p9: page 9]

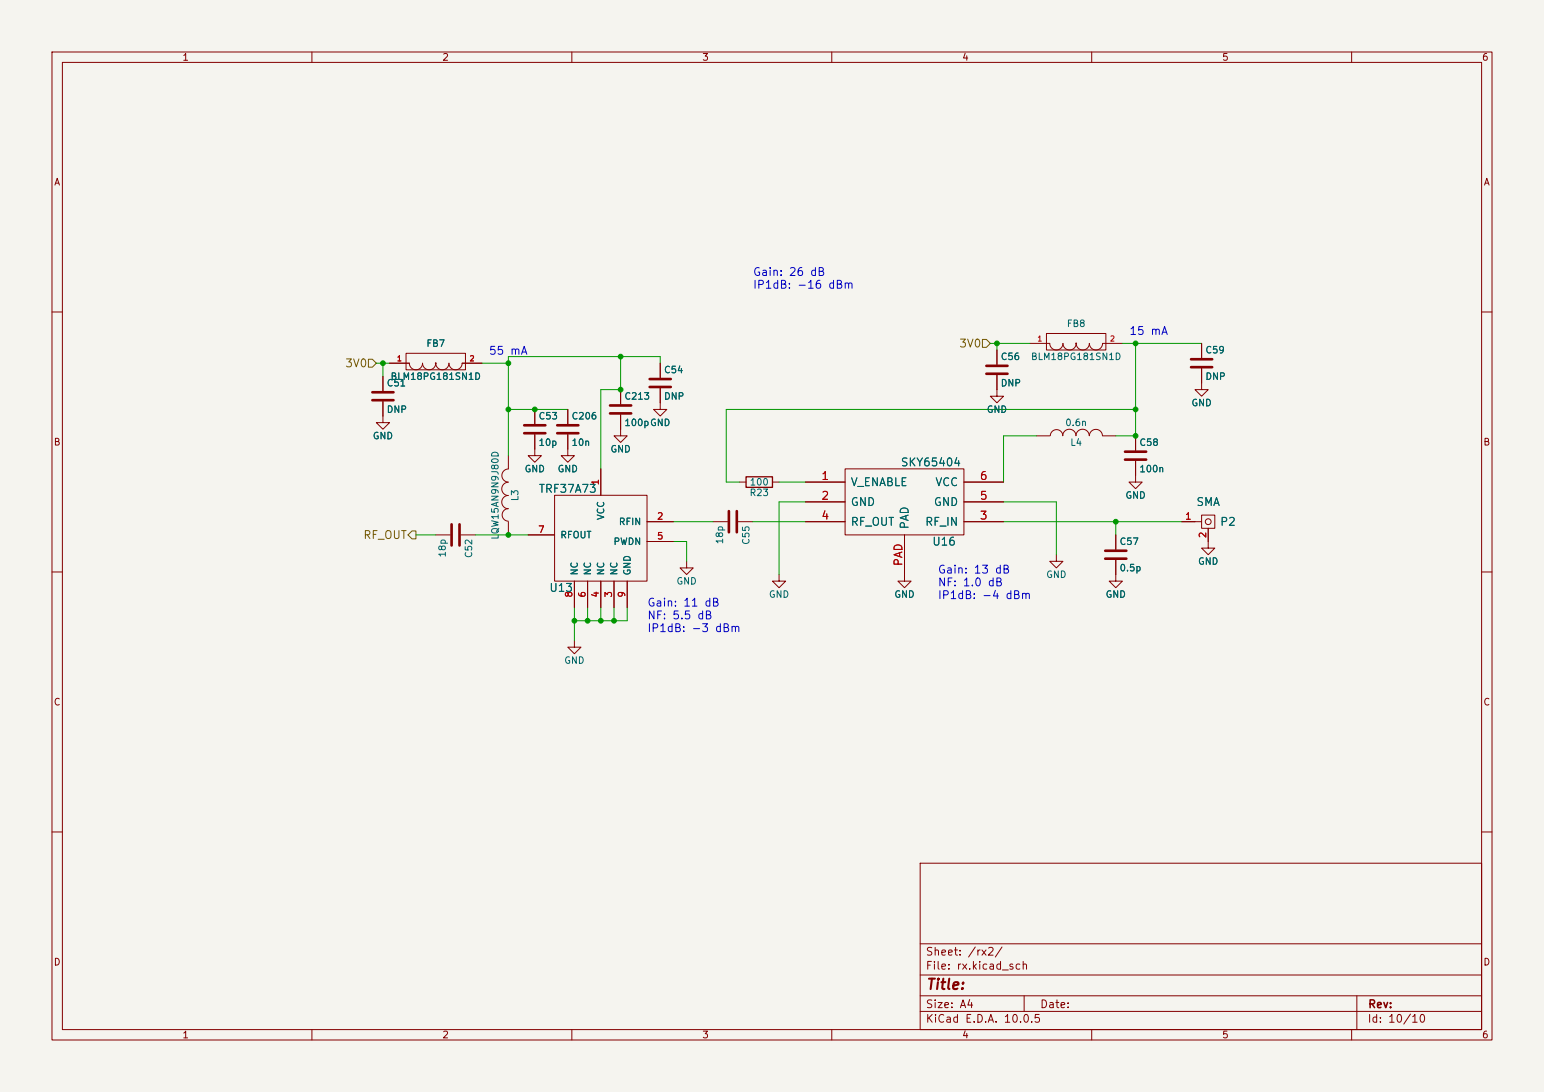
[picture p10: page 10]
