davidmhunt/fmcw3/hardware/legacy/fmcw3_original_2017.pdf

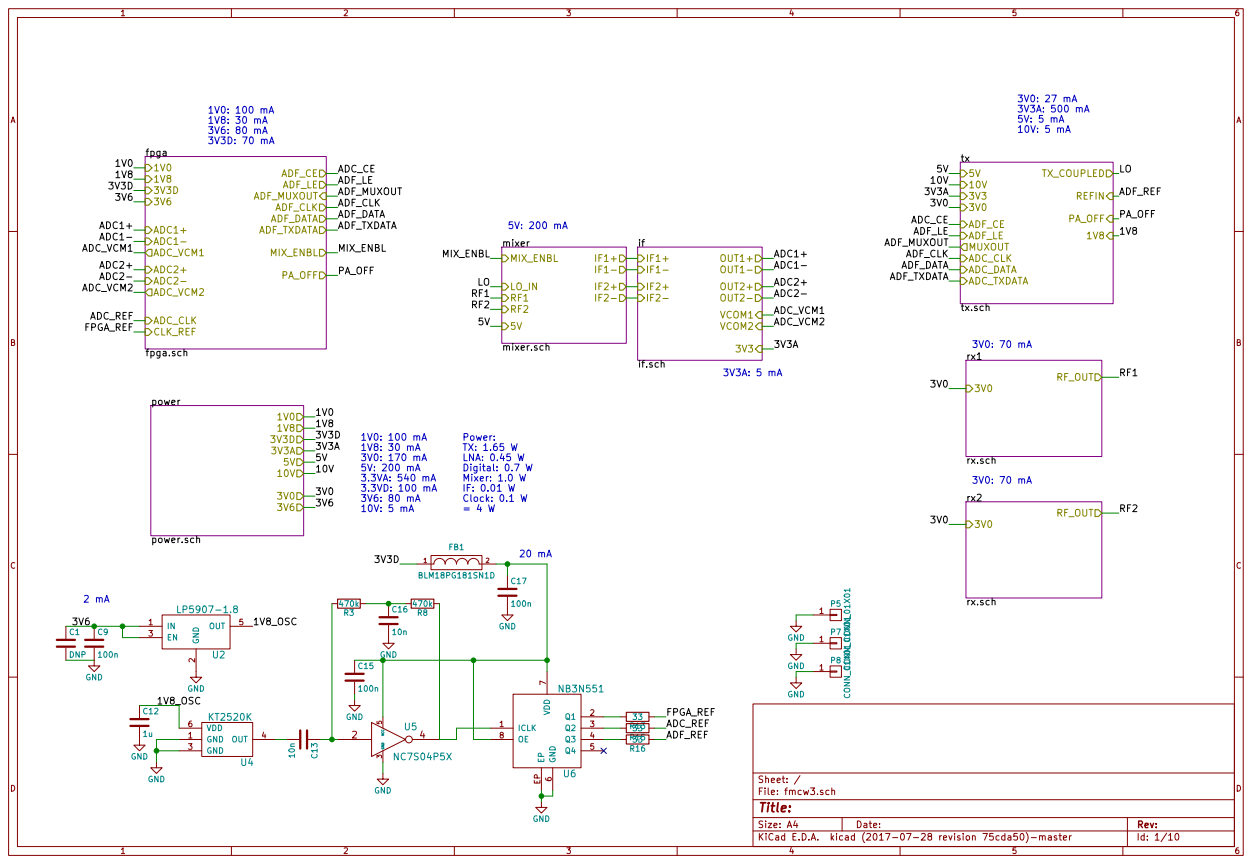
[picture p11: page 1]

Id: 1/10 Title: File: fmcw3.sch Sheet: /

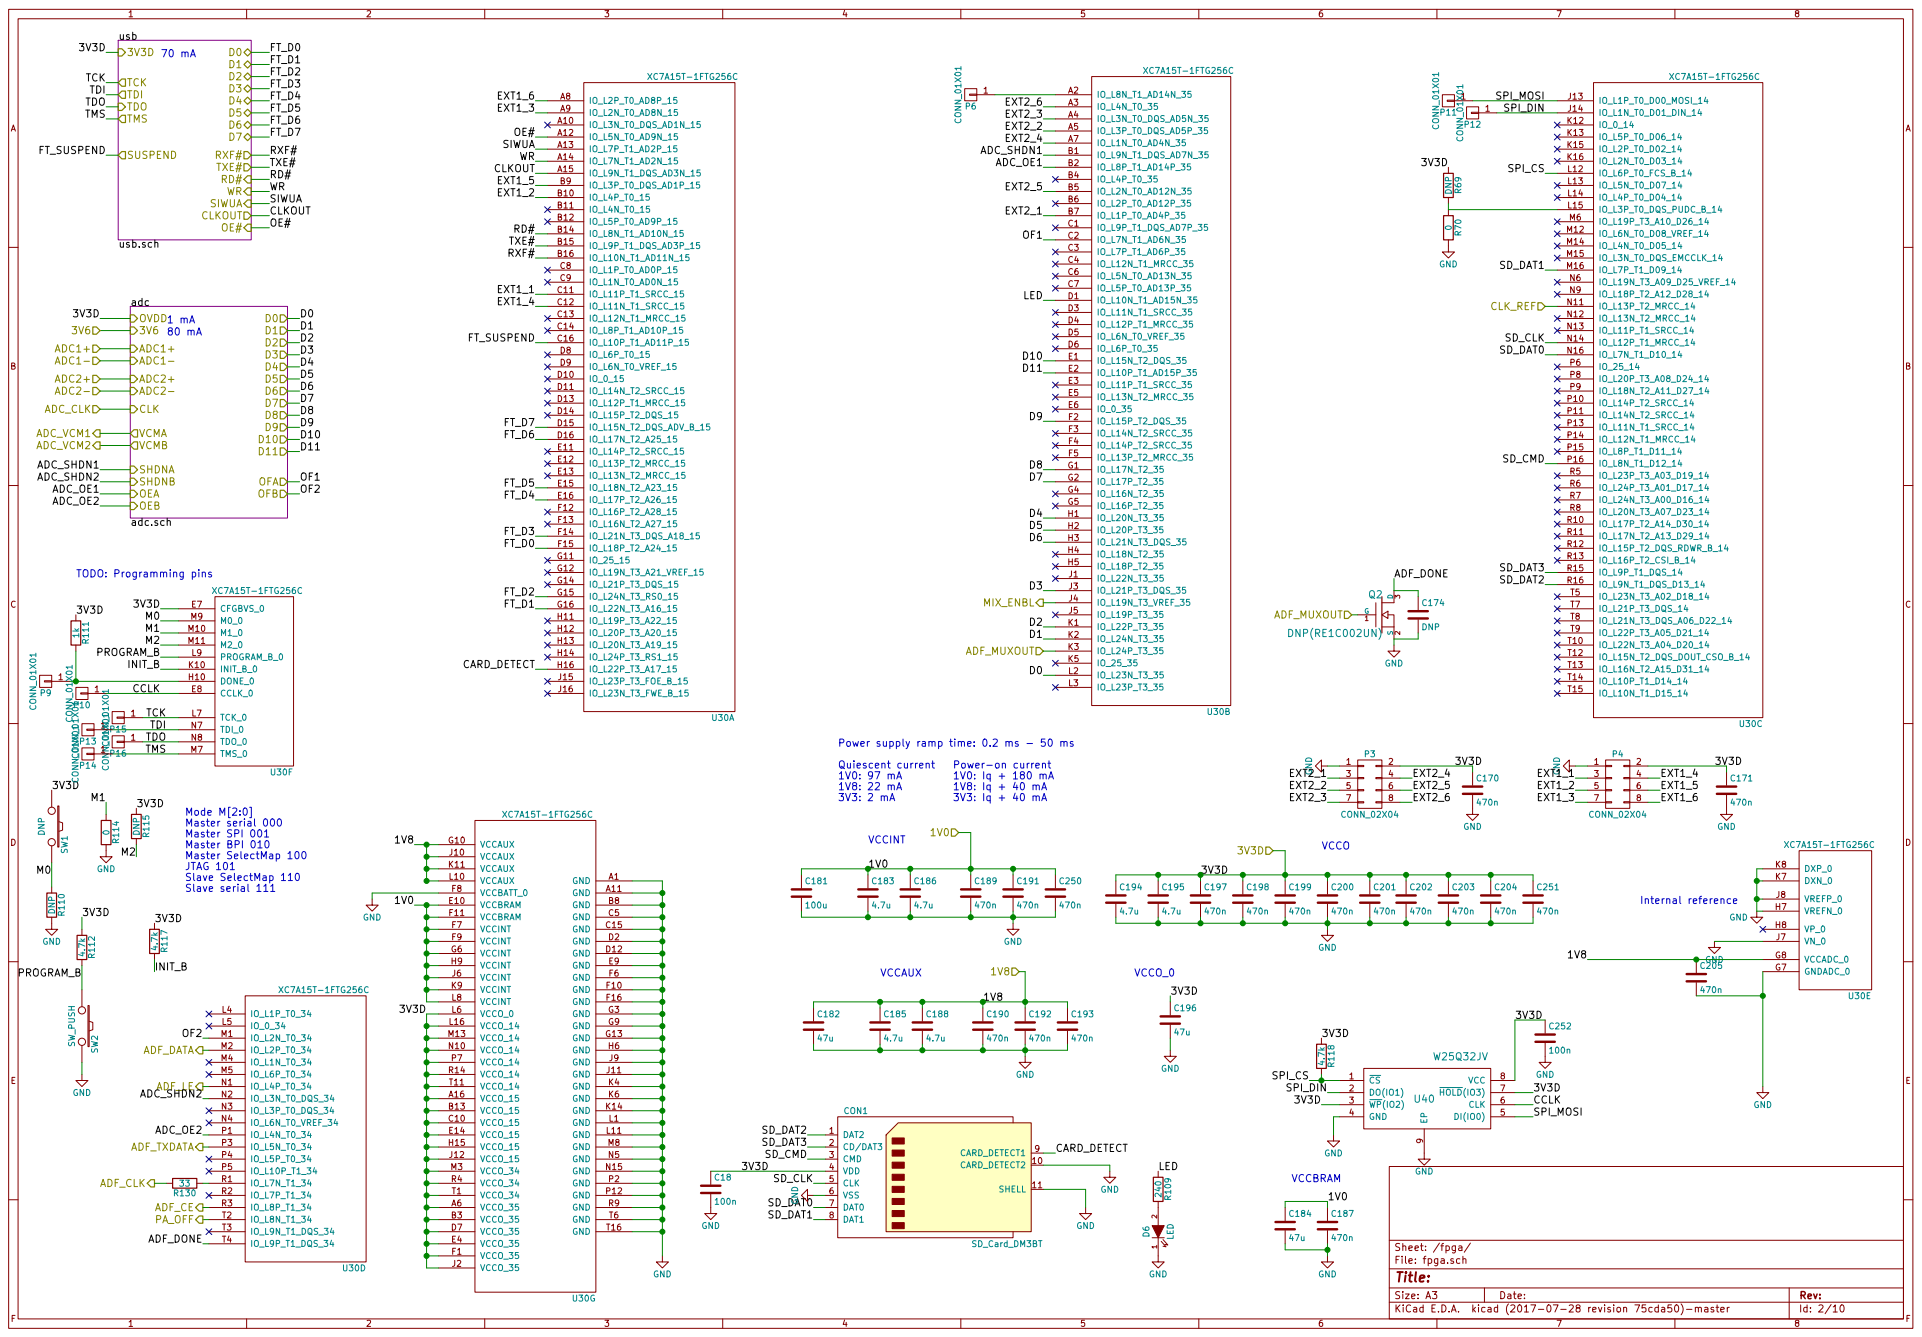
[picture p12: page 2]

SIWUA CLKOUT OE# SUSPEND

Power supply ramp time: 0.2 ms - 50 ms
Internal reference Quiescent current 1V0: 97 mA

Power-on current 1V0: Iq + 180 mA

Id: 2/10 Title: File: fpga.sch Sheet: /fpga/

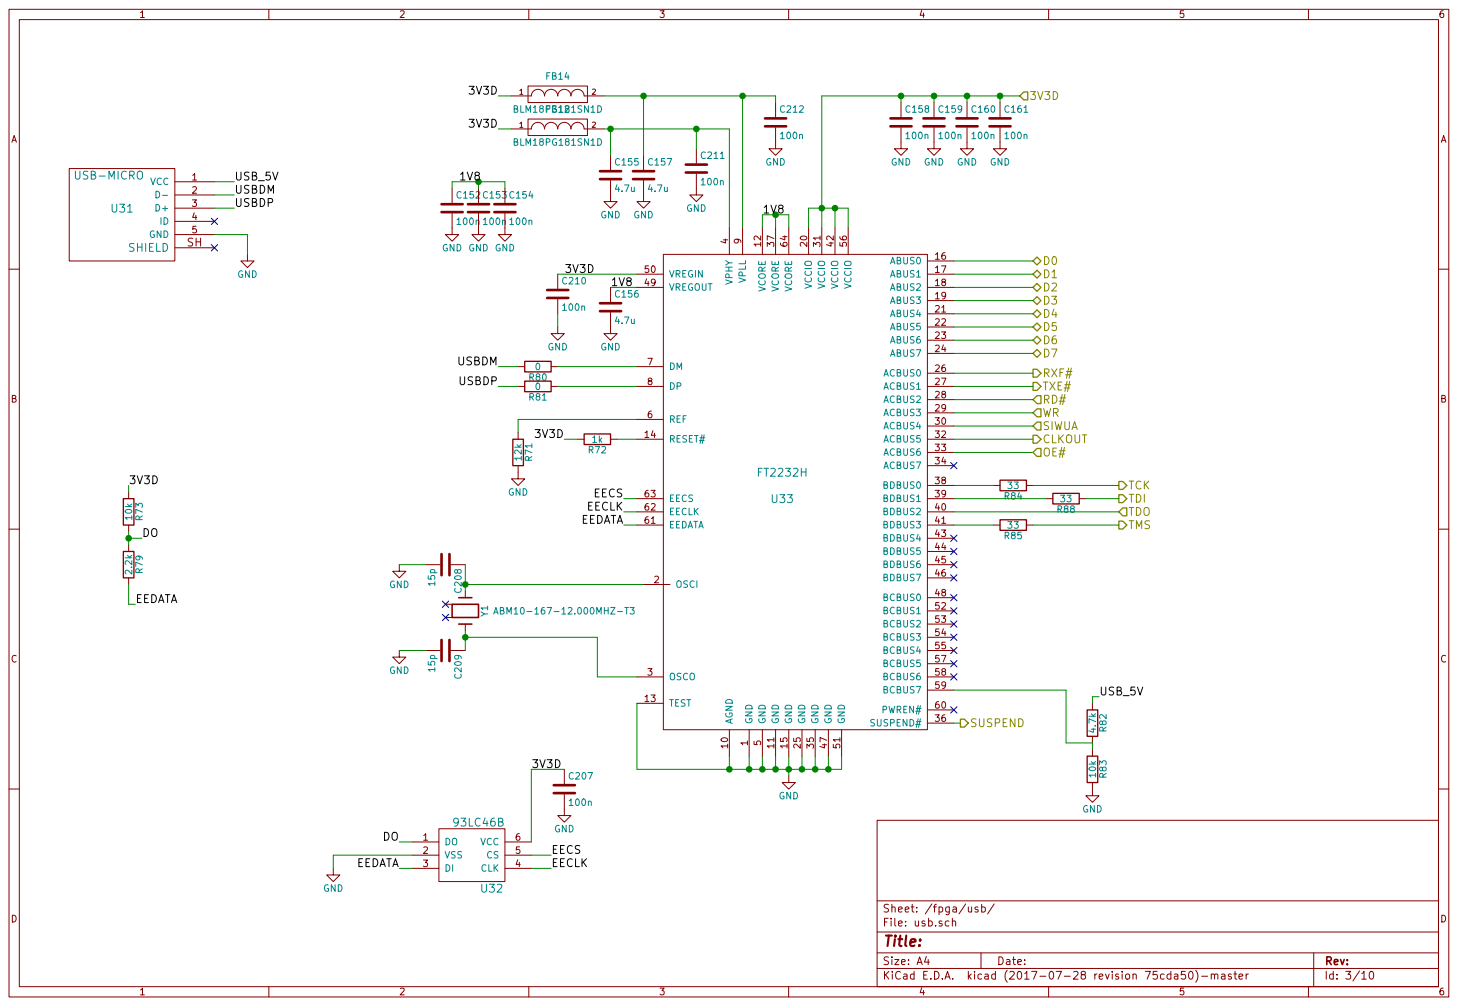
[picture p13: page 3]

Id: 3/10 Title: File: usb.sch Sheet: /fpga/usb/

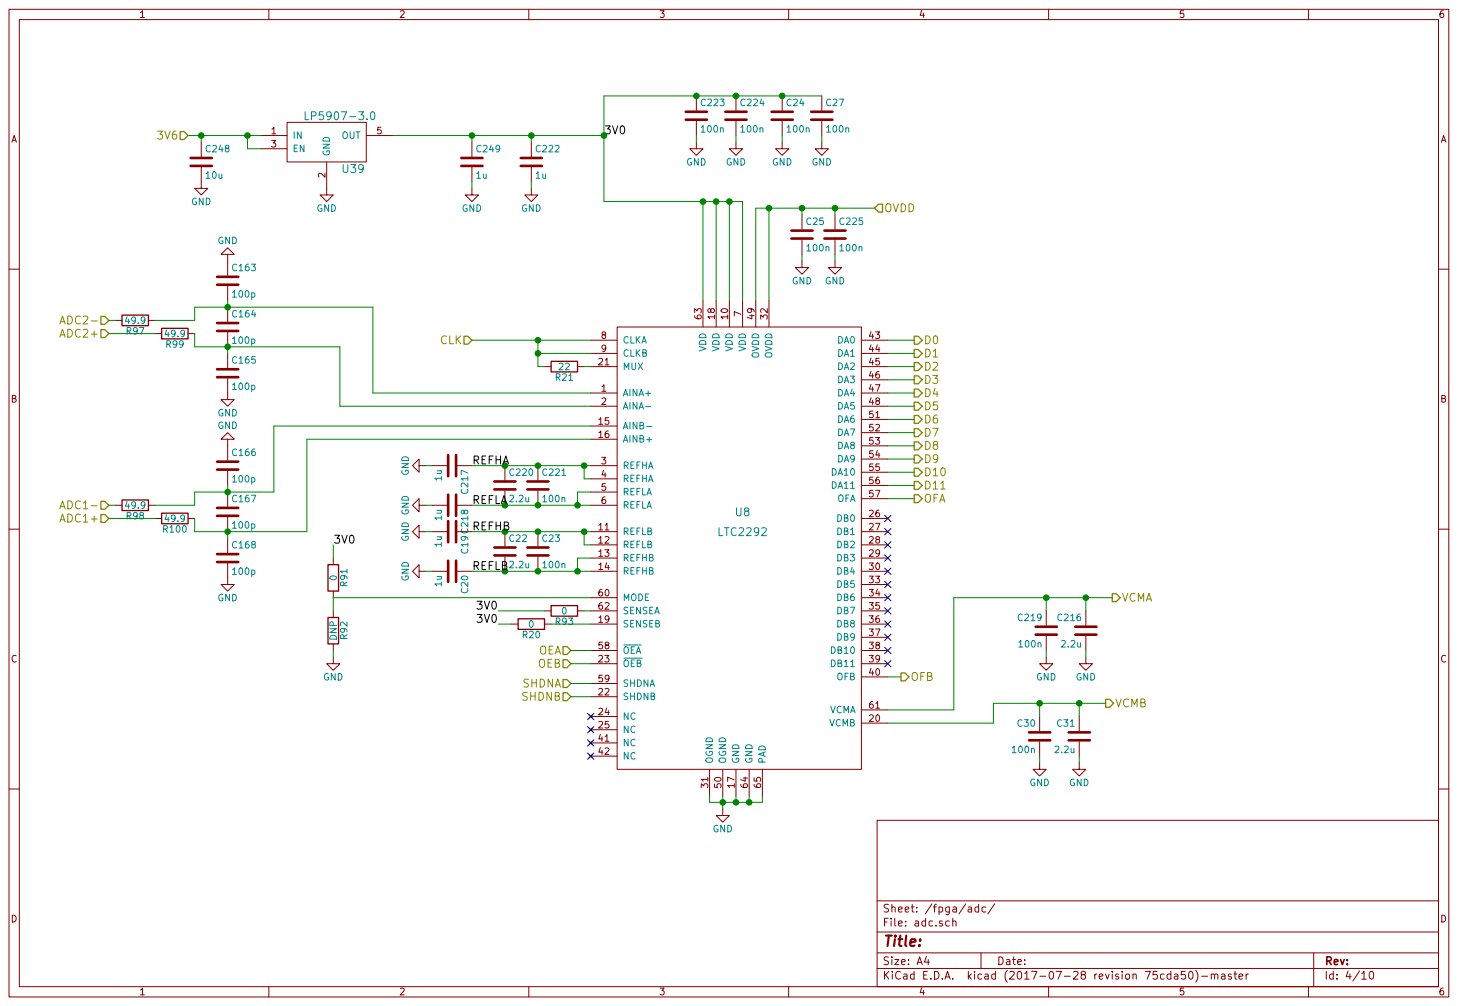
[picture p14: page 4]

7 CLKA 8 CLKB 9 VDD 10 VCMB 20 DB4 30 OFB 40 OGND 50 MODE 60 REFLB 11 MUX 21 OGND 31 NC 41 DA6 51 VCMA 61 REFLB 12 SHDNB 22 OVDD 32 NC 42 DA7 52 SENSEA 62 REFHB 13 OEB 23 DB5 33 DA0 43 DA8 53 VDD 63 REFHB 14 NC 24 DB6 34 DA1 44 DA9 54 GND 64 AINB- 15 NC 25 DB7 35 DA2 45 DA10 55 PAD 65 AINB+ 16 DB0 26 DB8 36 DA3 46 DA11 56 GND 17 DB1 27 DB9 37 DA4 47 OFA 57 VDD 18 DB2 28 DB10 38 DA5 48 OEA 58 SENSEB 19 DB3 29 DB11 39 OVDD 49 SHDNA 59 U8

Id: 4/10 Title: File: adc.sch Sheet: /fpga/adc/

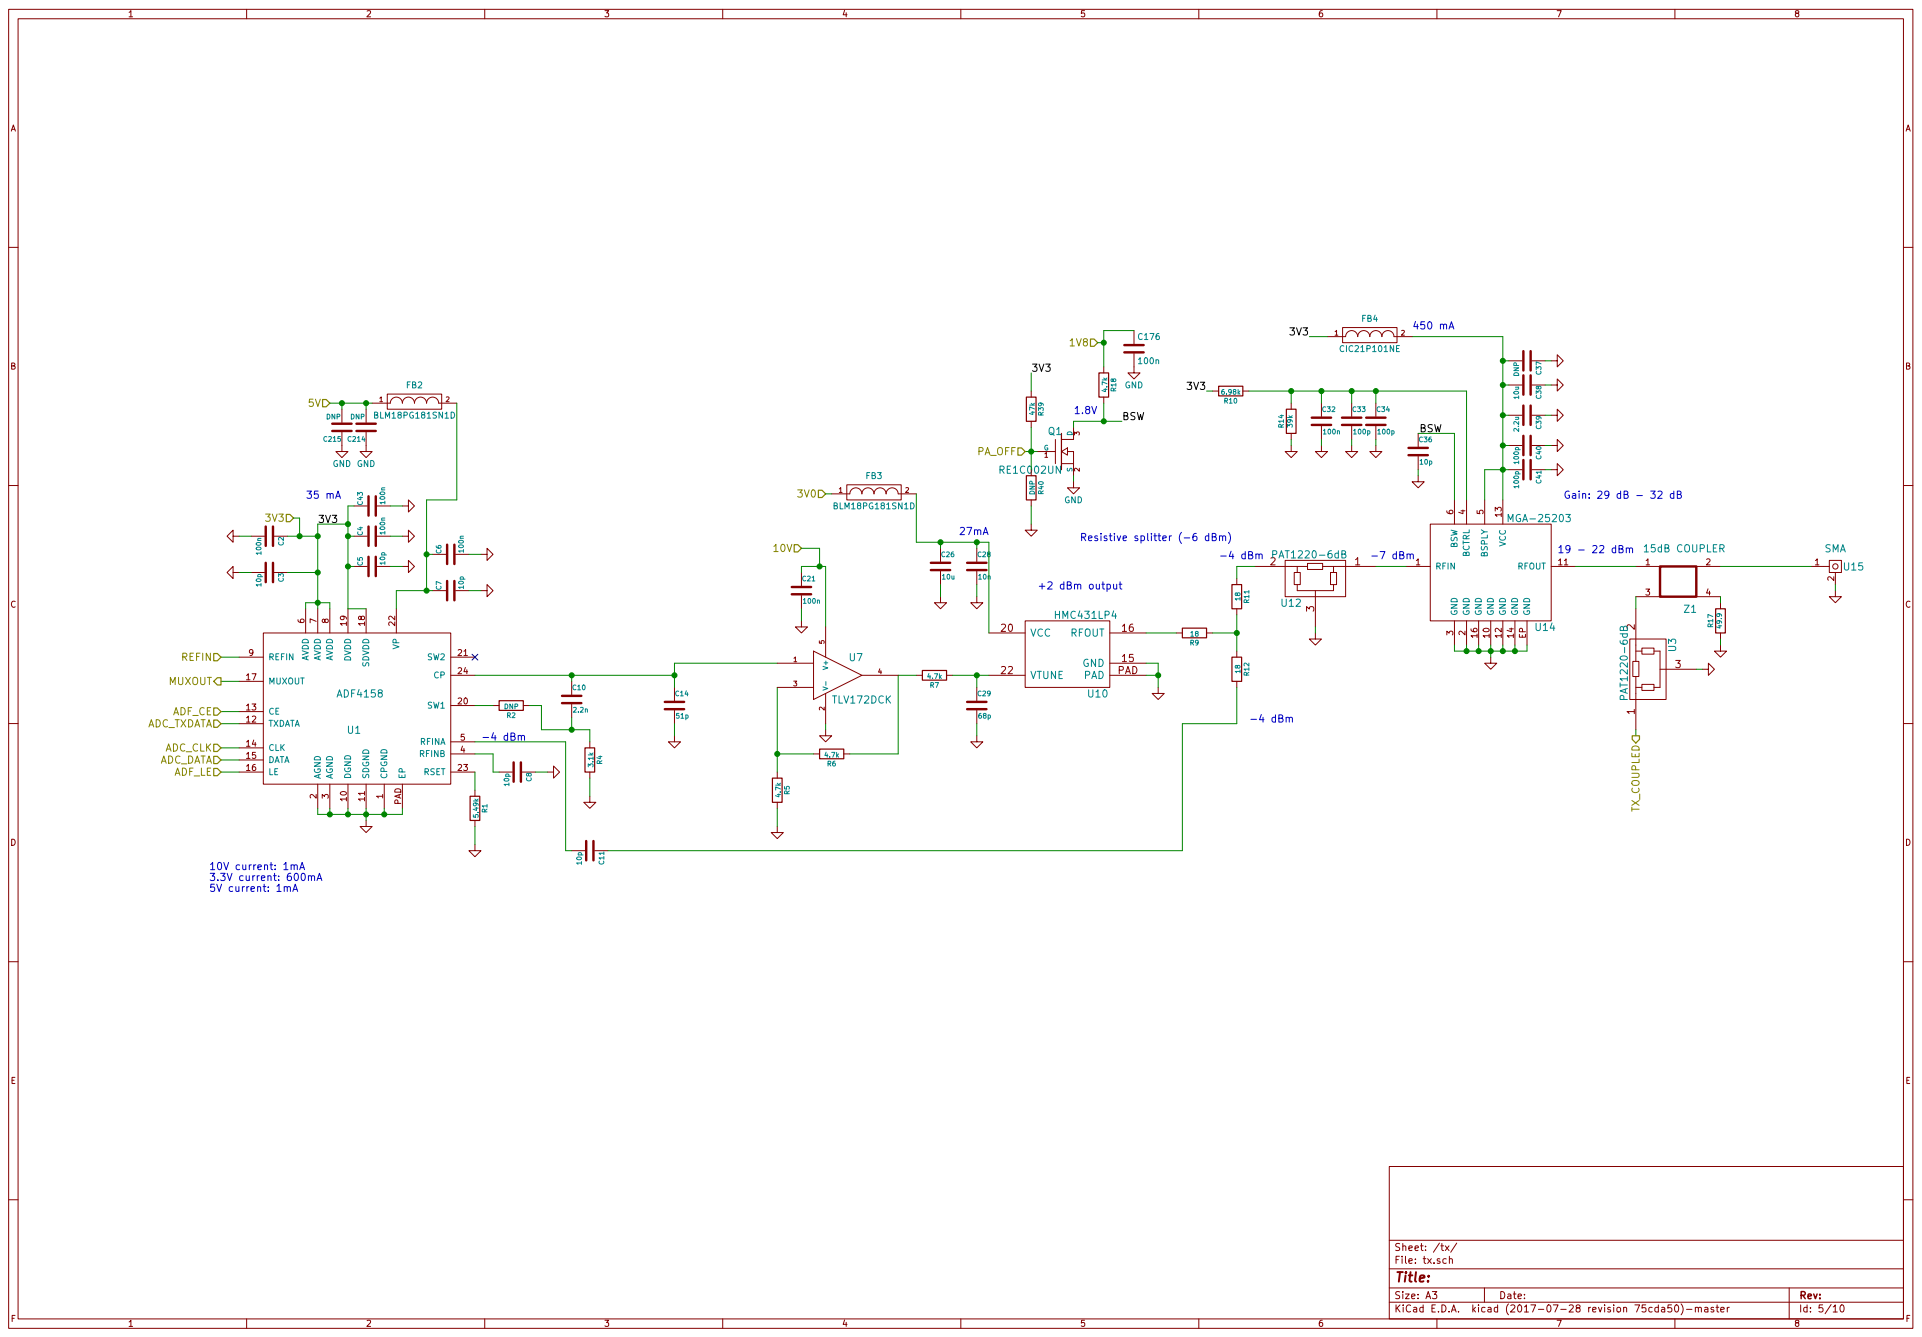
[picture p15: page 5]

6 GND 10 RFOUT 11 GND 12 VCC 13 GND 14 GND 16 GND EPU14 MGA-25203 C40 100p C39 2.2u 10u C38 DNP C37 C33

8 REFIN 9 DGND 10 SW1 20 SDGND 11 SW2 21 TXDATA 12 VP 22 CE 13 RSET 23 CLK 14 CP 24 DATA 15

Id: 5/10 Title: File: tx.sch Sheet: /tx/

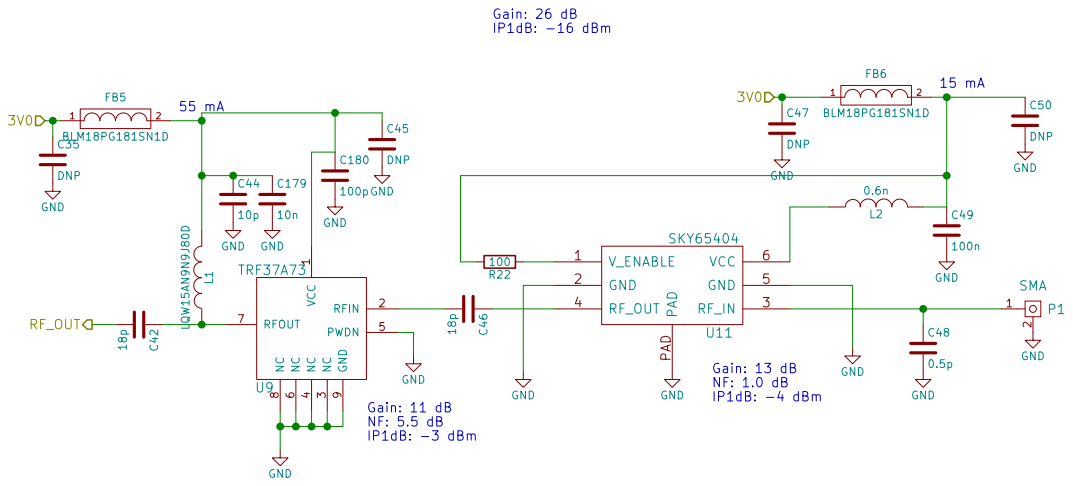
[picture p16: page 6]

IP1dB: -16 dBm
C47 DNP GND Gain: 13 dB NF: 1.0 dB

Gain: 11 dB NF: 5.5 dB

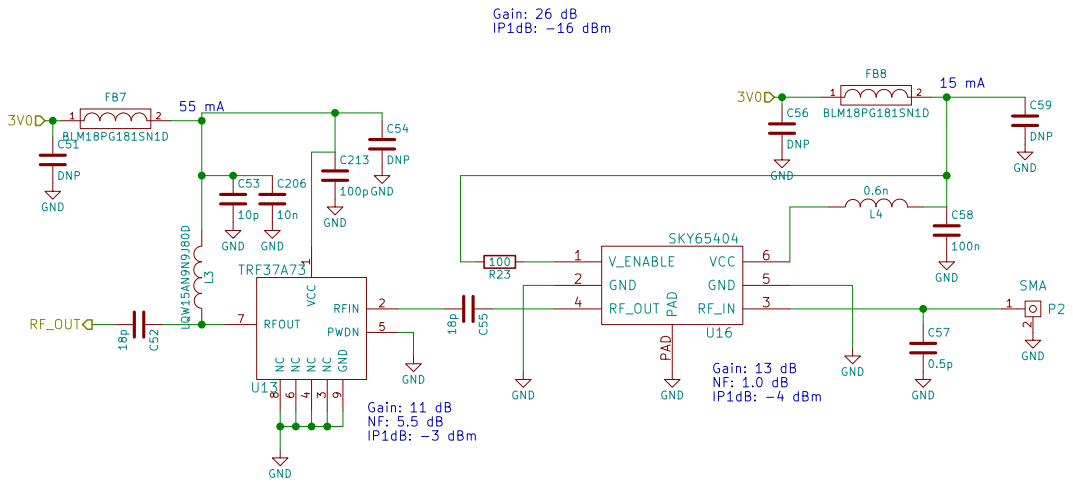
[picture p17: page 7]

IP1dB: -16 dBm
C56 DNP GND Gain: 13 dB NF: 1.0 dB

Gain: 11 dB NF: 5.5 dB

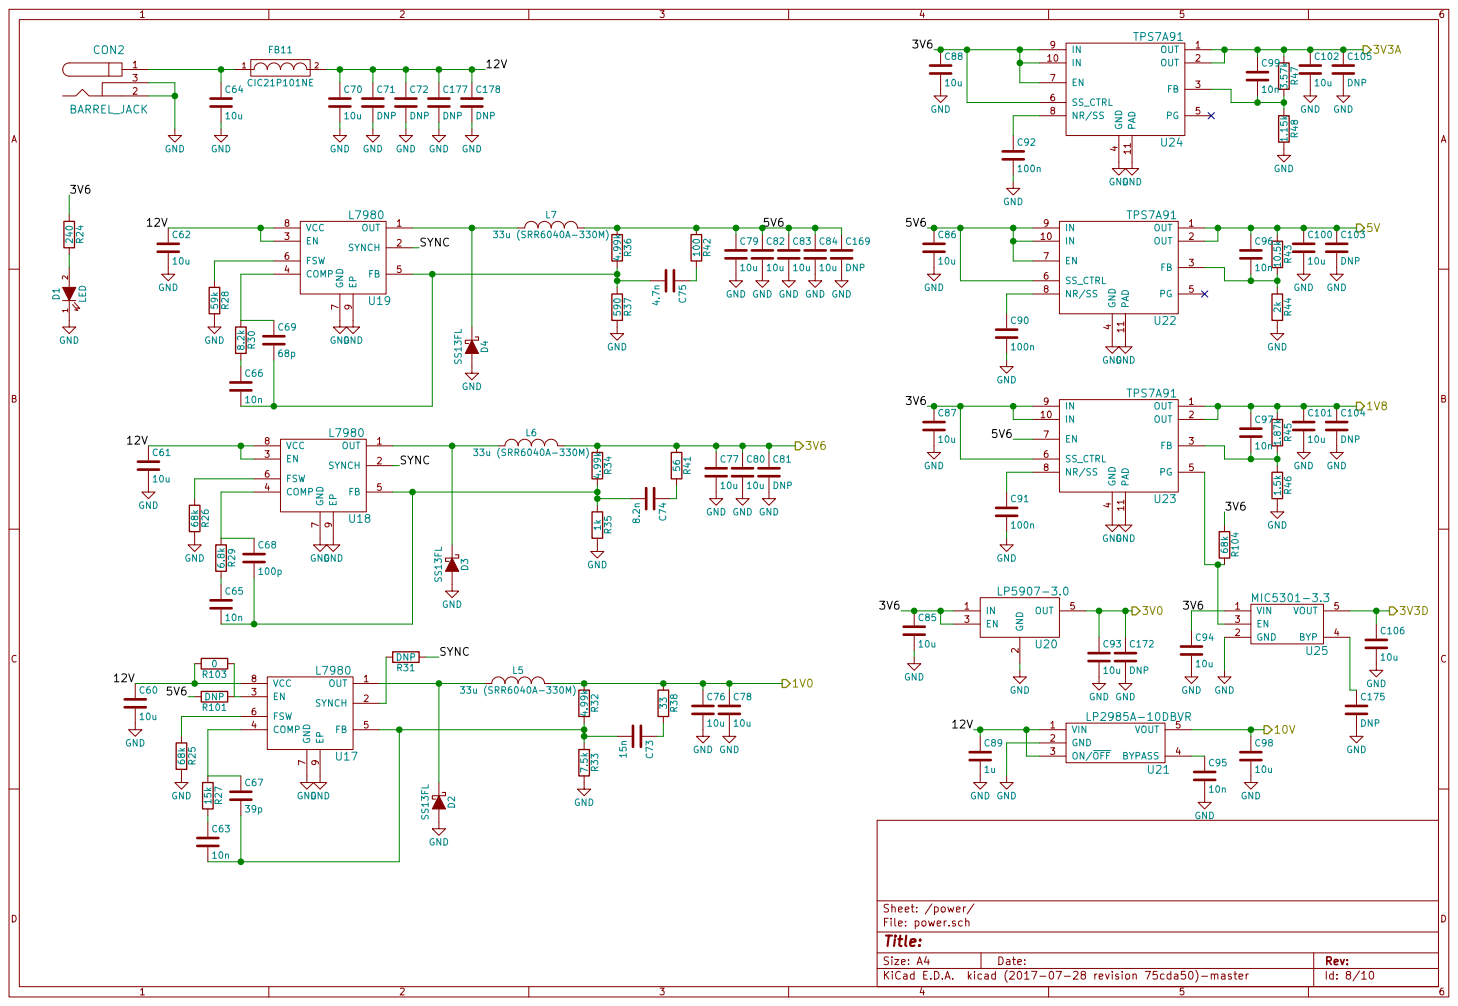
[picture p18: page 8]

4 PG 5 SS_CTRL 6 EN 7 NR/SS 8

1 2 D1 LED GND240 R24 3V6 OUT 1 SYNCH EN 2

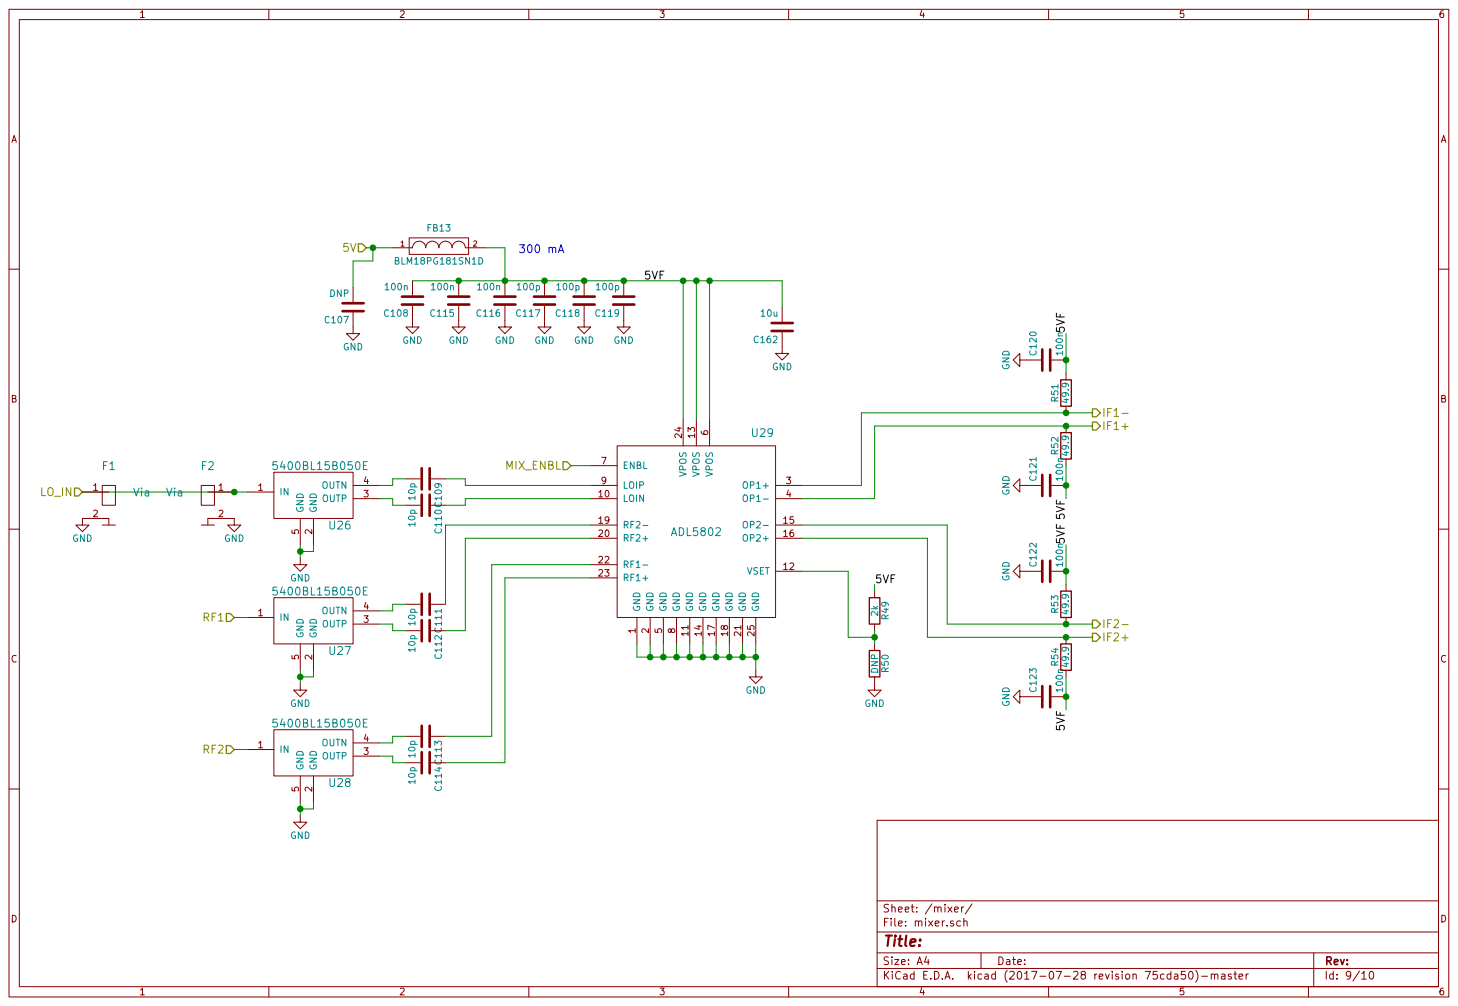
[picture p19: page 9]

Id: 9/10 Title: File: mixer.sch Sheet: /mixer/ GND

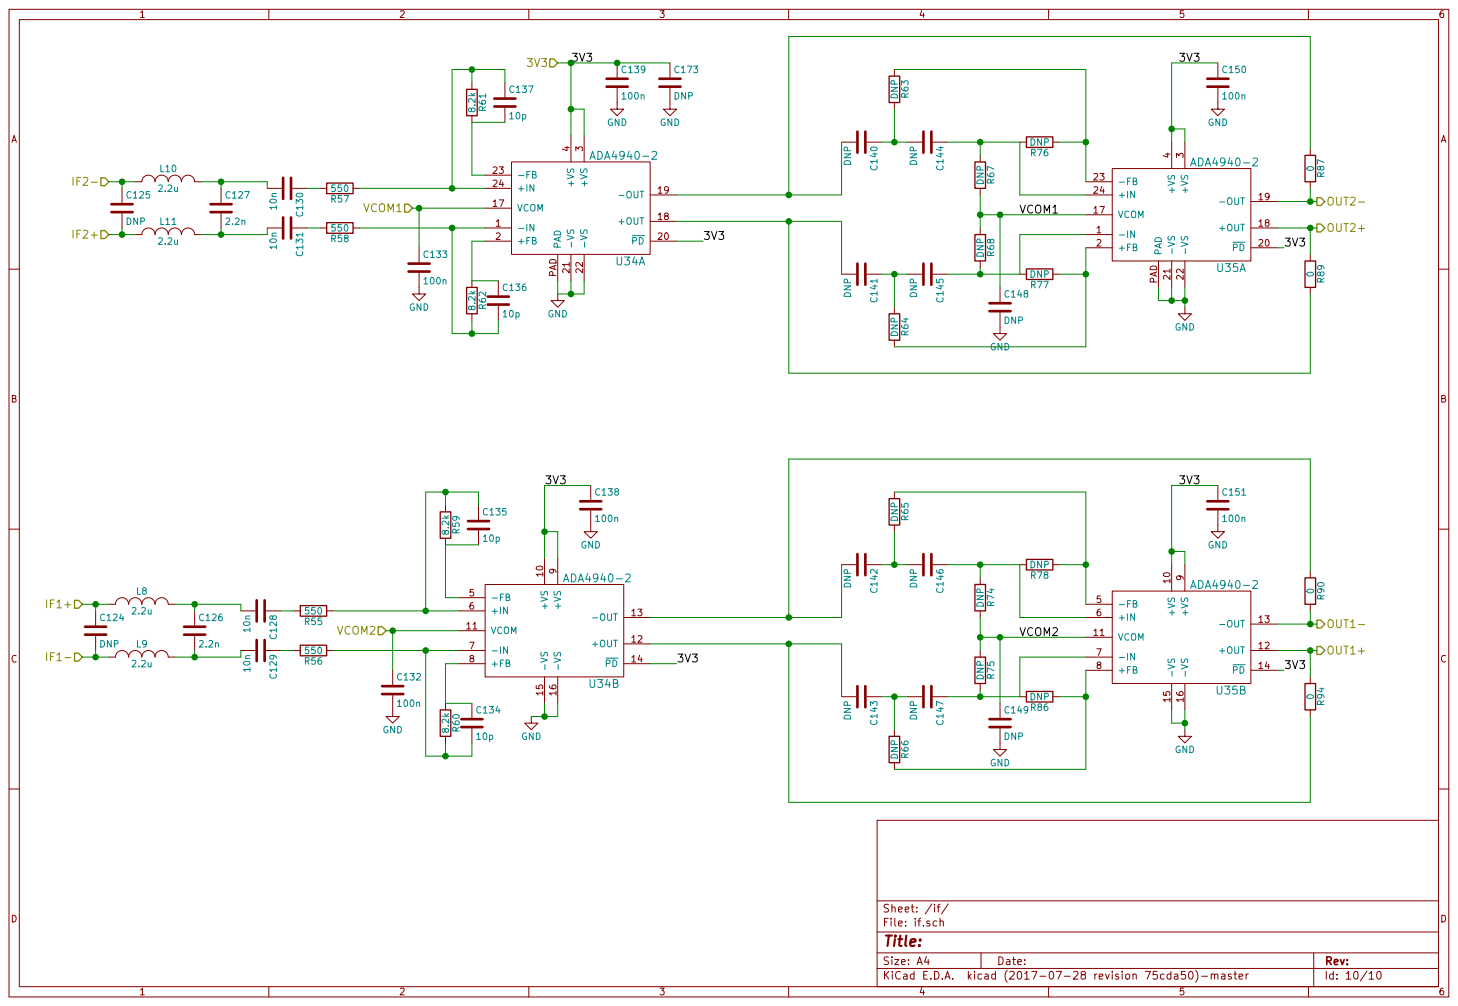
[picture p20: page 10]

Id: 10/10 Title: File: if.sch Sheet: /if/
