davidmhunt/fmcw3/hardware/fmcw3.kicad_pcb

## KiCad design hardware/fmcw3.kicad_pcb (continued)

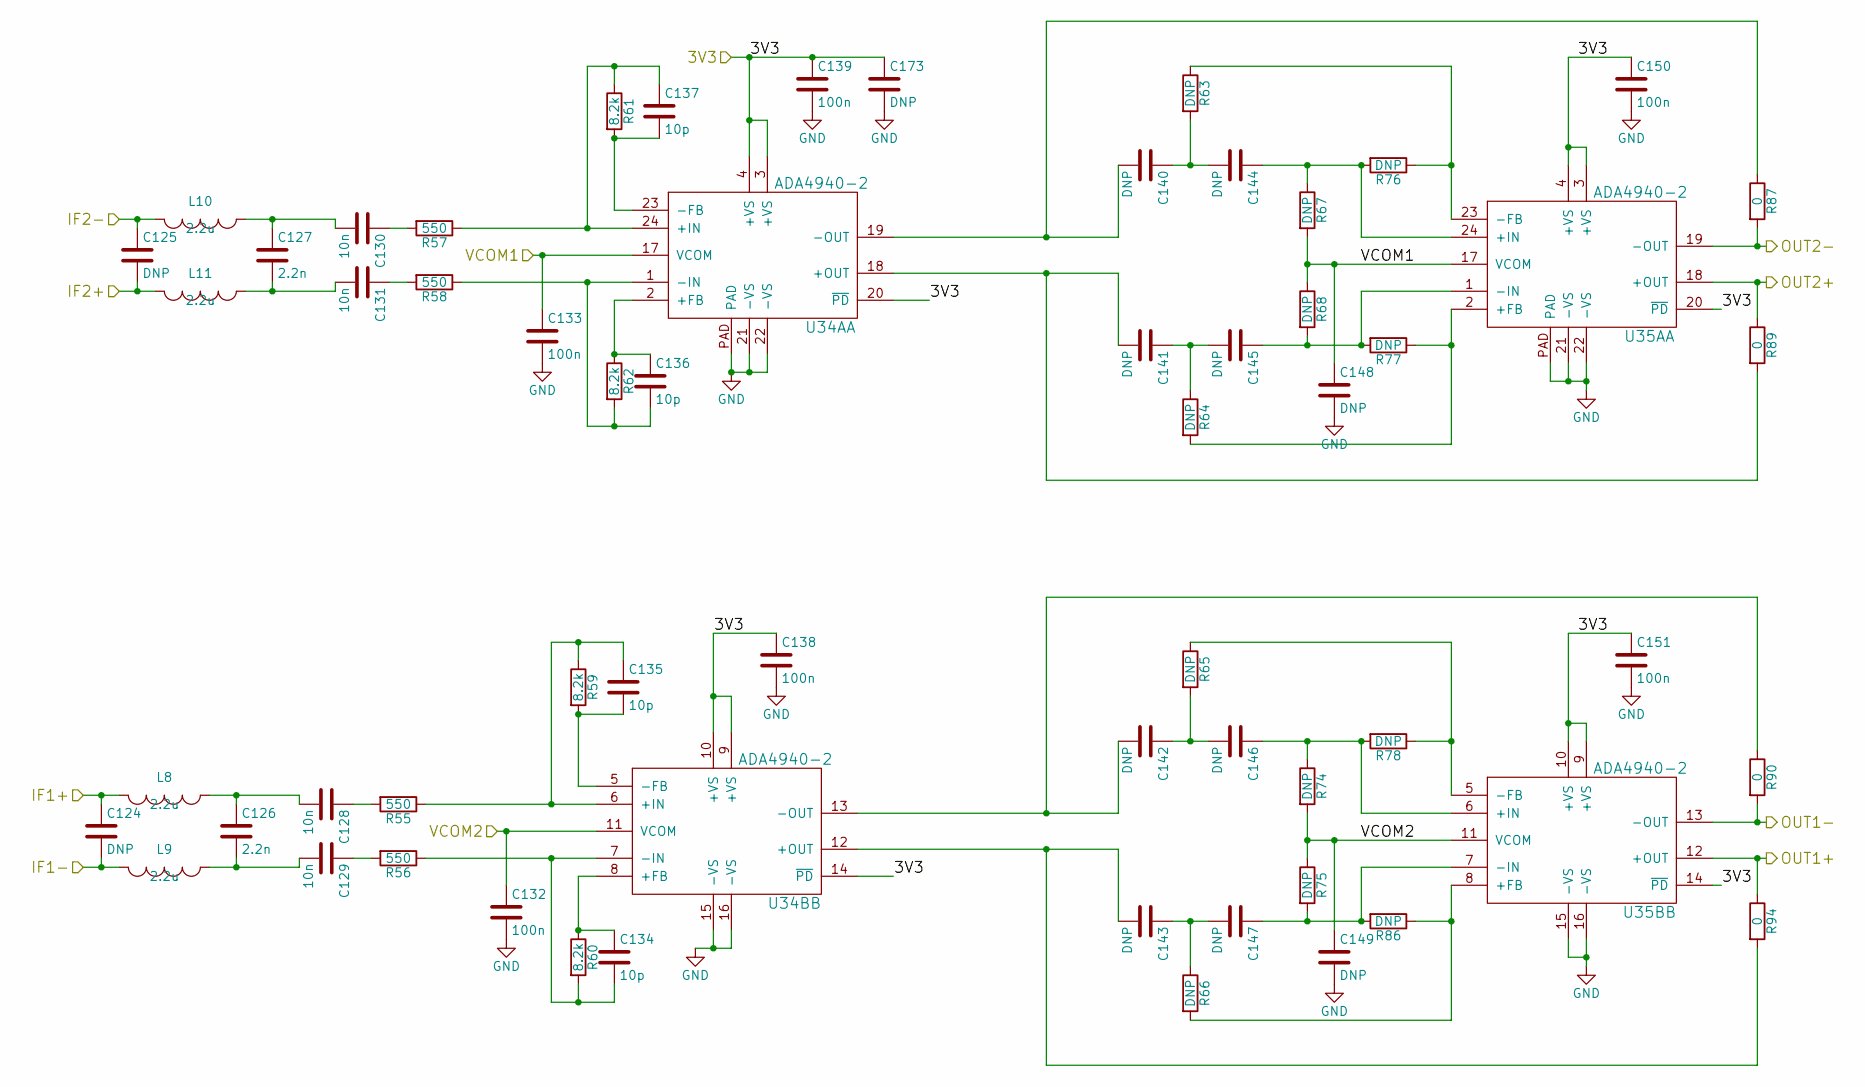
[picture p28: schematic if.kicad_sch]

Parts:
C124, C125, C140, C141, C142, C143, C144, C145, C146, C147, C148, C149: DNP; C_0402b
C126, C127: 2.2n; C_0402b
C128, C129, C130, C131: 10n; C_0402b
C132, C133, C138, C139, C150, C151: 100n; C_0402b
C134, C135, C136, C137: 10p; C_0402b
C173: DNP; C_0805b
L8, L9, L10, L11: 2.2u; C_0805b
R55, R56, R57, R58: 550; R_0402b
R59, R60, R61, R62: 8.2k; R_0402b
R63, R64, R65, R66, R67, R68, R74, R75, R76, R77, R78, R86: DNP; R_0402b
R87, R89, R90, R94: 0; R_0402b
U34A, U34B, U35A, U35B: ADA4940-2; VFQFN-24

Connections:
/3V3A: C138.1, C139.1, C150.1, C151.1, C173.1, U34A.3 (+VS), U34A.4 (+VS), U34A.20 (~PD), U34B.9 (+VS), U34B.10 (+VS), U34B.14 (~PD), U35A.3 (+VS), U35A.4 (+VS), U35A.20 (~PD), U35B.9 (+VS), U35B.10 (+VS), U35B.14 (~PD); also elsewhere on the board
/ADC1+: R94.1, U35B.12 (+OUT); also elsewhere on the board
/ADC1-: R90.2, U35B.13 (-OUT); also elsewhere on the board
/ADC2+: R89.1, U35A.18 (+OUT); also elsewhere on the board
/ADC2-: R87.2, U35A.19 (-OUT); also elsewhere on the board
/ADC_VCM1: C133.1, C148.1, R67.2, R68.1, U34A.17 (VCOM), U35A.17 (VCOM); also elsewhere on the board
/ADC_VCM2: C132.1, C149.1, R74.2, R75.1, U34B.11 (VCOM), U35B.11 (VCOM); also elsewhere on the board
/if/IF1+: C124.1, L8.1; also elsewhere on the board
/if/IF1-: C124.2, L9.1; also elsewhere on the board
/if/IF2+: C125.2, L11.1; also elsewhere on the board
/if/IF2-: C125.1, L10.1; also elsewhere on the board
GND: C132.2, C133.2, C138.2, C139.2, C148.2, C149.2, C150.2, C151.2, C173.2, U34A.21 (-VS), U34A.22 (-VS), U34A.PAD, U34B.15 (-VS), U34B.16 (-VS), U35A.21 (-VS), U35A.22 (-VS), U35A.PAD, U35B.15 (-VS), U35B.16 (-VS); also elsewhere on the board
unnamed: C126.1, C128.2, L8.2
unnamed: C126.2, C129.2, L9.2
unnamed: C127.1, C130.2, L10.2
unnamed: C127.2, C131.2, L11.2
unnamed: C128.1, R55.2
unnamed: C129.1, R56.2
unnamed: C130.1, R57.2
unnamed: C131.1, R58.2
unnamed 184: C134.1, R60.1, U34B.8 (+FB); also elsewhere on the board
unnamed 185: C134.2, R56.1, R60.2, U34B.7 (-IN); also elsewhere on the board
unnamed 186: C135.1, R55.1, R59.1, U34B.6 (+IN); also elsewhere on the board
unnamed 187: C135.2, R59.2, U34B.5 (-FB); also elsewhere on the board
unnamed 188: C136.1, R62.1, U34A.2 (+FB); also elsewhere on the board
unnamed 189: C136.2, R58.1, R62.2, U34A.1 (-IN); also elsewhere on the board
unnamed 190: C137.1, R57.1, R61.1, U34A.24 (+IN); also elsewhere on the board
unnamed 191: C137.2, R61.2, U34A.23 (-FB); also elsewhere on the board
unnamed: C140.1, C144.2, R63.2
unnamed 193: C140.2, R87.1, U34A.19 (-OUT); also elsewhere on the board
unnamed: C141.1, C145.2, R64.1
unnamed 195: C141.2, R89.2, U34A.18 (+OUT); also elsewhere on the board
unnamed: C142.1, C146.2, R65.2
unnamed 197: C142.2, R90.1, U34B.13 (-OUT); also elsewhere on the board
unnamed: C143.1, C147.2, R66.1
unnamed 199: C143.2, R94.2, U34B.12 (+OUT); also elsewhere on the board
unnamed 200: C144.1, R67.1, R76.2, U35A.24 (+IN); also elsewhere on the board
unnamed 201: C145.1, R68.2, R77.2, U35A.1 (-IN); also elsewhere on the board
unnamed 202: C146.1, R74.1, R78.2, U35B.6 (+IN); also elsewhere on the board
unnamed 203: C147.1, R75.2, R86.2, U35B.7 (-IN); also elsewhere on the board
unnamed 245: R63.1, R76.1, U35A.23 (-FB); also elsewhere on the board
unnamed 246: R64.2, R77.1, U35A.2 (+FB); also elsewhere on the board
unnamed 247: R65.1, R78.1, U35B.5 (-FB); also elsewhere on the board
unnamed 248: R66.2, R86.1, U35B.8 (+FB); also elsewhere on the board

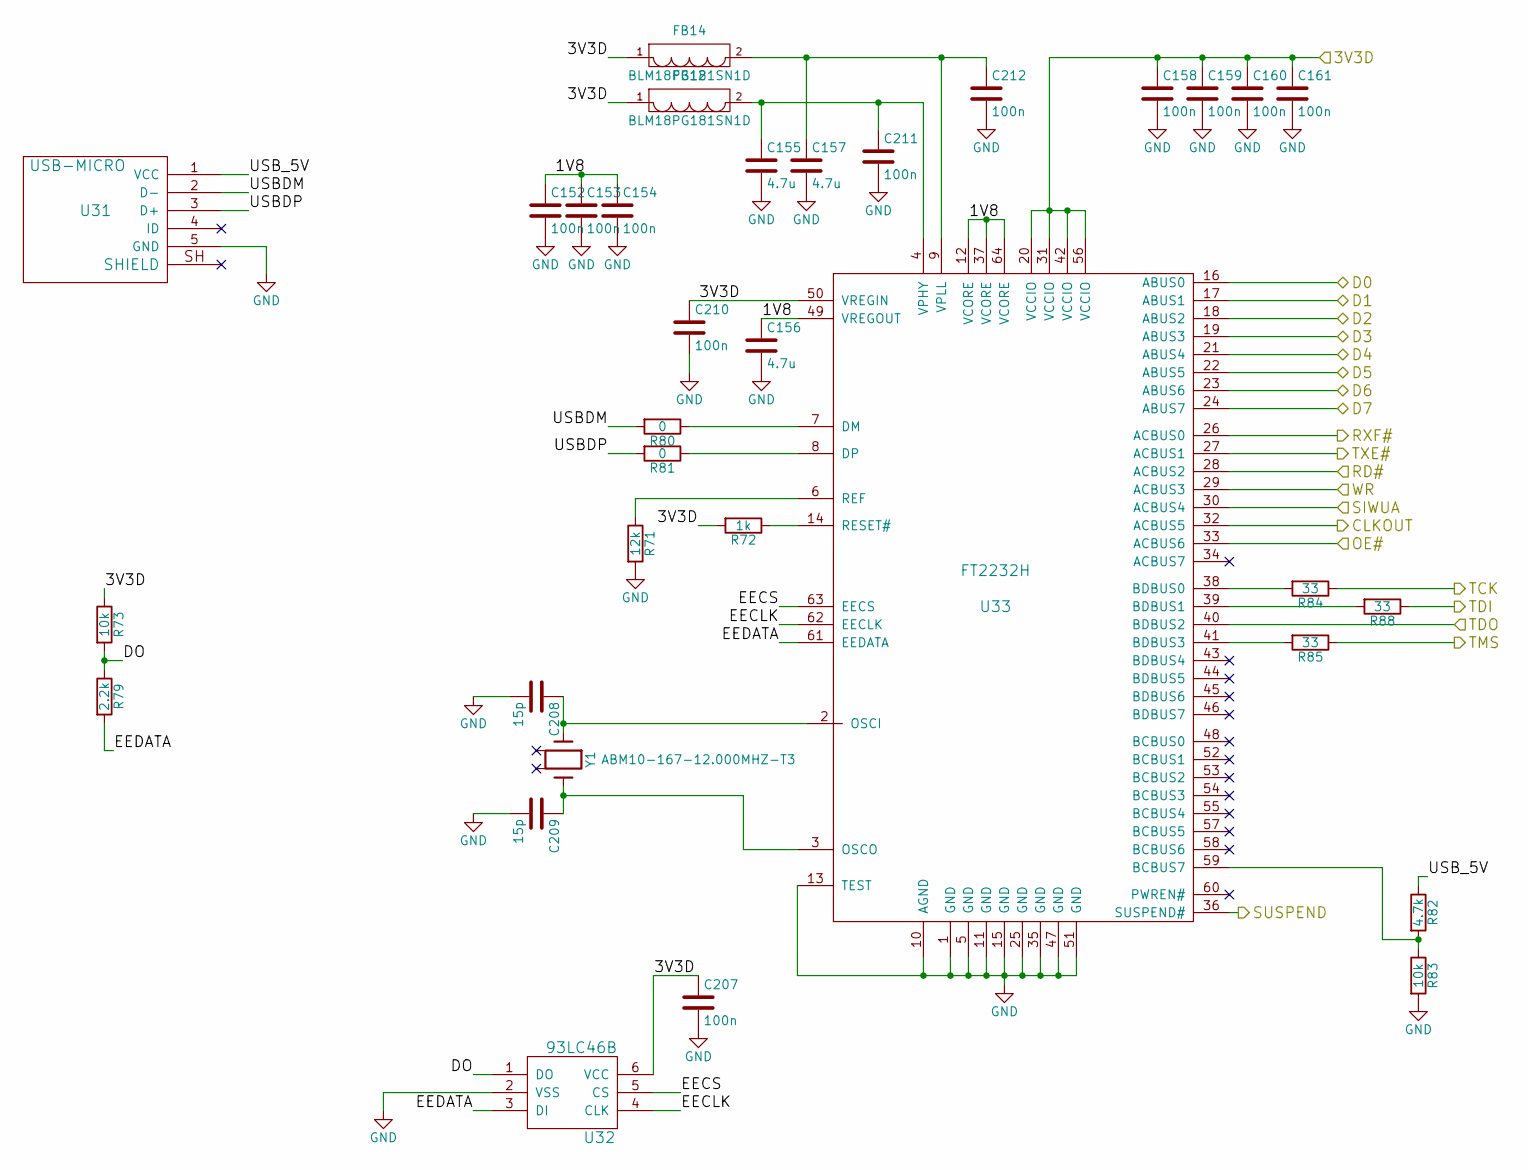
[picture p29: schematic usb.kicad_sch]

Parts:
C152, C153, C154, C158, C159, C160, C161, C207, C210, C211, C212: 100n; C_0402b
C155, C156, C157: 4.7u; C_0603b
C208, C209: 15p; C_0402b
FB12, FB14: BLM18PG181SN1D; C_0603b
R71: 12k; R_0402b
R72: 1k; R_0402b
R73, R83: 10k; R_0402b
R79: 2.2k; R_0402b
R80, R81: 0; R_0402b
R82: 4.7k; R_0402b
R84, R85, R88: 33; R_0402b
U31: USB-MICRO; USB_MICRO
U32: 93LC46B; SOT-23-6
U33: FT2232H; LQFP-64_10x10mm_Pitch0.5mm
Y1: ABM10-167-12.000MHZ-T3; ABM10

Connections:
/3V3D: C158.1, C159.1, C160.1, C161.1, C207.1, C210.1, FB12.1, FB14.1, R72.2, R73.1, U32.6 (VCC), U33.20 (VCCIO), U33.31 (VCCIO), U33.42 (VCCIO), U33.50 (VREGIN), U33.56 (VCCIO); also elsewhere on the board
/fpga/CLKOUT: U33.32 (ACBUS5); also elsewhere on the board
/fpga/FT_D0: U33.16 (ABUS0); also elsewhere on the board
/fpga/FT_D1: U33.17 (ABUS1); also elsewhere on the board
/fpga/FT_D2: U33.18 (ABUS2); also elsewhere on the board
/fpga/FT_D3: U33.19 (ABUS3); also elsewhere on the board
/fpga/FT_D4: U33.21 (ABUS4); also elsewhere on the board
/fpga/FT_D5: U33.22 (ABUS5); also elsewhere on the board
/fpga/FT_D6: U33.23 (ABUS6); also elsewhere on the board
/fpga/FT_D7: U33.24 (ABUS7); also elsewhere on the board
/fpga/FT_SUSPEND: U33.36 (SUSPEND#); also elsewhere on the board
/fpga/OE#: U33.33 (ACBUS6); also elsewhere on the board
/fpga/RD#: U33.28 (ACBUS2); also elsewhere on the board
/fpga/RXF#: U33.26 (ACBUS0); also elsewhere on the board
/fpga/SIWUA: U33.30 (ACBUS4); also elsewhere on the board
/fpga/TCK: R84.1; also elsewhere on the board
/fpga/TDI: R88.1; also elsewhere on the board
/fpga/TDO: U33.40 (BDBUS2); also elsewhere on the board
/fpga/TMS: R85.1; also elsewhere on the board
/fpga/TXE#: U33.27 (ACBUS1); also elsewhere on the board
/fpga/WR: U33.29 (ACBUS3); also elsewhere on the board
/fpga/usb/1V8: C152.1, C153.1, C154.1, C156.1, U33.12 (VCORE), U33.37 (VCORE), U33.49 (VREGOUT), U33.64 (VCORE)
/fpga/usb/DO: R73.2, R79.1, U32.1 (DO)
/fpga/usb/EECLK: U32.4 (CLK), U33.62 (EECLK)
/fpga/usb/EECS: U32.5 (CS), U33.63 (EECS)
/fpga/usb/EEDATA: R79.2, U32.3 (DI), U33.61 (EEDATA)
/fpga/usb/USBDM: R80.2, U31.2 (D-)
/fpga/usb/USBDP: R81.2, U31.3 (D+)
/fpga/usb/USB_5V: R82.1, U31.1 (VCC)
GND: C152.2, C153.2, C154.2, C155.2, C156.2, C157.2, C158.2, C159.2, C160.2, C161.2, C207.2, C208.2, C209.2, C210.2, C211.2, C212.2, R71.2, R83.2, U31.5 (GND), U32.2 (VSS), U33.1 (GND), U33.5 (GND), U33.10 (AGND), U33.11 (GND), U33.13 (TEST), U33.15 (GND), U33.25 (GND), U33.35 (GND), U33.47 (GND), U33.51 (GND); also elsewhere on the board
unnamed: C155.1, C211.1, FB12.2, U33.4 (VPHY)
unnamed: C157.1, C212.1, FB14.2, U33.9 (VPLL)
unnamed: C208.1, U33.2 (OSCI), Y1.1
unnamed: C209.1, U33.3 (OSCO), Y1.3
unnamed: R71.1, U33.6 (REF)
unnamed: R72.1, U33.14 (RESET#)
unnamed: R80.1, U33.7 (DM)
unnamed: R81.1, U33.8 (DP)
unnamed: R82.2, R83.1, U33.59 (BCBUS7)
unnamed: R84.2, U33.38 (BDBUS0)
unnamed: R85.2, U33.41 (BDBUS3)
unnamed: R88.2, U33.39 (BDBUS1)

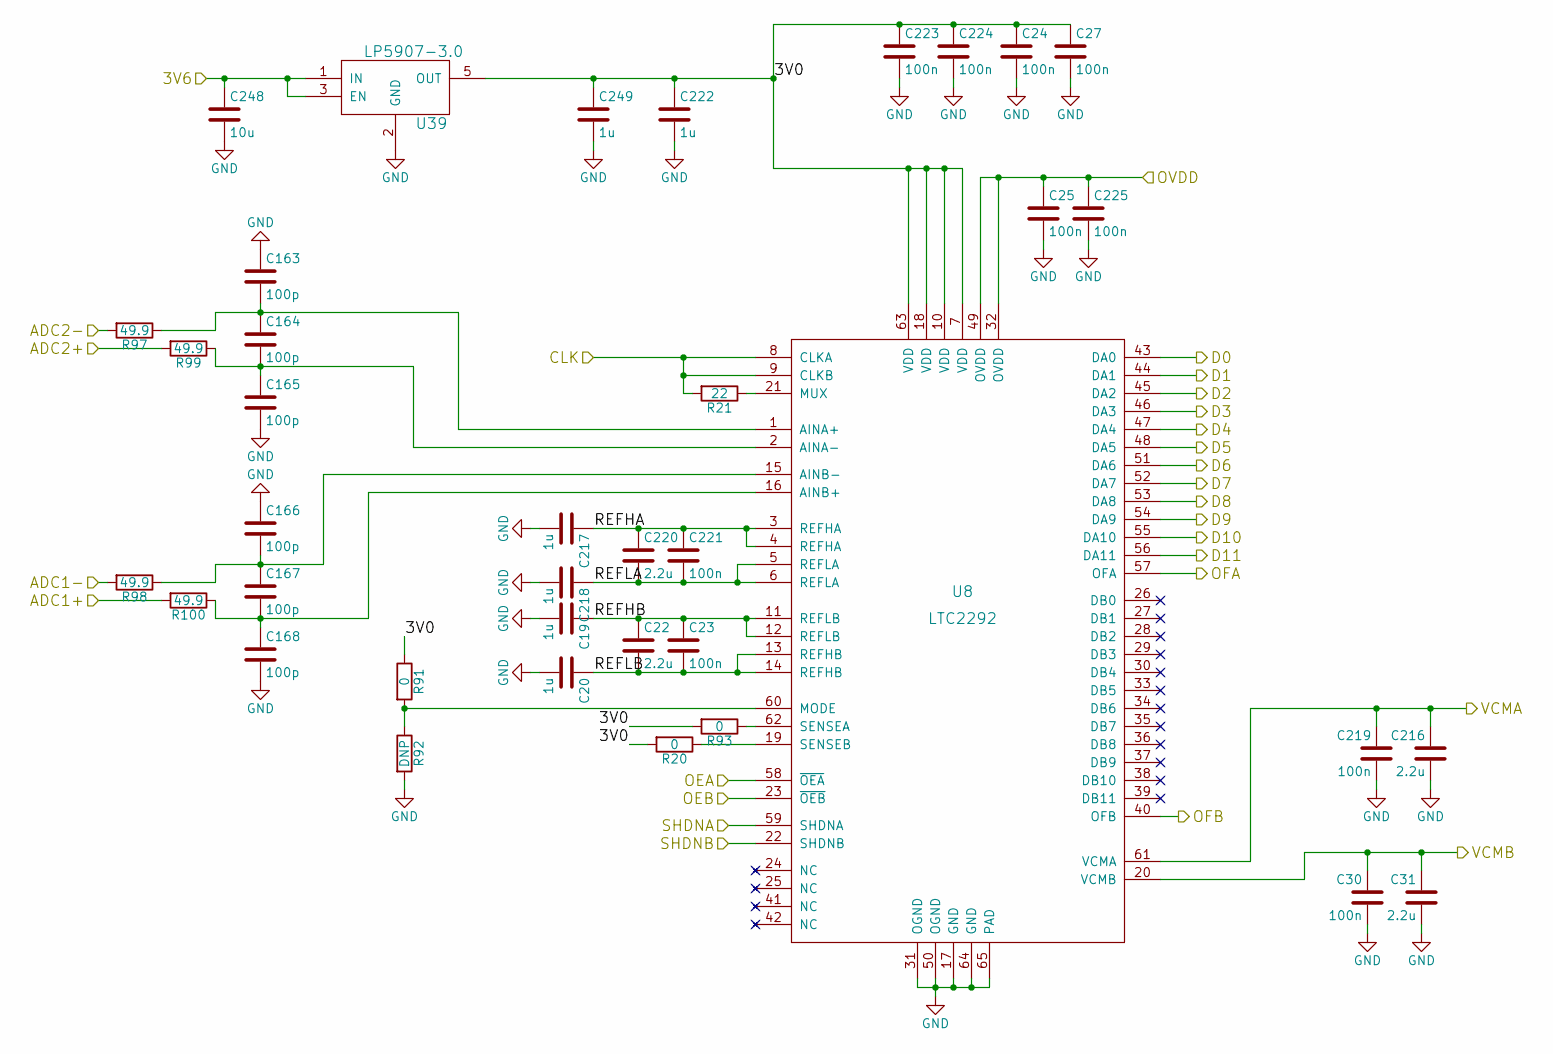
[picture p30: schematic adc.kicad_sch]

Parts:
C19, C20, C217, C218, C222, C249: 1u; C_0603b
C22, C31, C216, C220: 2.2u; C_0603b
C23, C24, C25, C27, C30, C219, C221, C223, C224, C225: 100n; C_0402b
C163, C164, C165, C166, C167, C168: 100p; C_0402b
C248: 10u; C_0805b
R20, R91, R93: 0; R_0402b
R21: 22; R_0402b
R92: DNP; R_0402b
R97, R98, R99, R100: 49.9; R_0402b
U8: LTC2292; QFN-64-1EP_9x9mm_Pitch0.5mm
U39: LP5907-3.0; SOT-23-5

Connections:
/3V3D: C25.1, C225.1, U8.32 (OVDD), U8.49 (OVDD); also elsewhere on the board
/3V6: C248.1, U39.1 (IN), U39.3 (EN); also elsewhere on the board
/ADC1+: R100.2; also elsewhere on the board
/ADC1-: R98.2; also elsewhere on the board
/ADC2+: R99.2; also elsewhere on the board
/ADC2-: R97.2; also elsewhere on the board
/ADC_REF: R21.2, U8.8 (CLKA), U8.9 (CLKB); also elsewhere on the board
/ADC_VCM1: C216.1, C219.1, U8.61 (VCMA); also elsewhere on the board
/ADC_VCM2: C30.1, C31.1, U8.20 (VCMB); also elsewhere on the board
/fpga/ADC_OE1: U8.58 (~OEA); also elsewhere on the board
/fpga/ADC_OE2: U8.23 (~OEB); also elsewhere on the board
/fpga/ADC_SHDN1: U8.59 (SHDNA); also elsewhere on the board
/fpga/ADC_SHDN2: U8.22 (SHDNB); also elsewhere on the board
/fpga/D0: U8.43 (DA0); also elsewhere on the board
/fpga/D1: U8.44 (DA1); also elsewhere on the board
/fpga/D2: U8.45 (DA2); also elsewhere on the board
/fpga/D3: U8.46 (DA3); also elsewhere on the board
/fpga/D4: U8.47 (DA4); also elsewhere on the board
/fpga/D5: U8.48 (DA5); also elsewhere on the board
/fpga/D6: U8.51 (DA6); also elsewhere on the board
/fpga/D7: U8.52 (DA7); also elsewhere on the board
/fpga/D8: U8.53 (DA8); also elsewhere on the board
/fpga/D9: U8.54 (DA9); also elsewhere on the board
/fpga/D10: U8.55 (DA10); also elsewhere on the board
/fpga/D11: U8.56 (DA11); also elsewhere on the board
/fpga/OF1: U8.57 (OFA); also elsewhere on the board
/fpga/OF2: U8.40 (OFB); also elsewhere on the board
/fpga/adc/3V0: C24.1, C27.1, C222.1, C223.1, C224.1, C249.1, R20.2, R91.1, R93.2, U8.7 (VDD), U8.10 (VDD), U8.18 (VDD), U8.63 (VDD), U39.5 (OUT)
/fpga/adc/REFHA: C217.1, C220.1, C221.1, U8.3 (REFHA), U8.4 (REFHA)
/fpga/adc/REFHB: C19.1, C22.1, C23.1, U8.11 (REFLB), U8.12 (REFLB)
/fpga/adc/REFLA: C218.1, C220.2, C221.2, U8.5 (REFLA), U8.6 (REFLA)
/fpga/adc/REFLB: C20.1, C22.2, C23.2, U8.13 (REFHB), U8.14 (REFHB)
GND: C19.2, C20.2, C24.2, C25.2, C27.2, C30.2, C31.2, C163.1, C165.2, C166.1, C168.2, C216.2, C217.2, C218.2, C219.2, C222.2, C223.2, C224.2, C225.2, C248.2, C249.2, R92.2, U8.17 (GND), U8.31 (OGND), U8.50 (OGND), U8.64 (GND), U8.65 (PAD), U39.2 (GND); also elsewhere on the board
unnamed: C163.2, C164.1, R97.1, U8.1 (AINA+)
unnamed: C164.2, C165.1, R99.1, U8.2 (AINA-)
unnamed: C166.2, C167.1, R98.1, U8.15 (AINB-)
unnamed: C167.2, C168.1, R100.1, U8.16 (AINB+)
unnamed: R20.1, U8.19 (SENSEB)
unnamed: R21.1, U8.21 (MUX)
unnamed: R91.2, R92.1, U8.60 (MODE)
unnamed: R93.1, U8.62 (SENSEA)

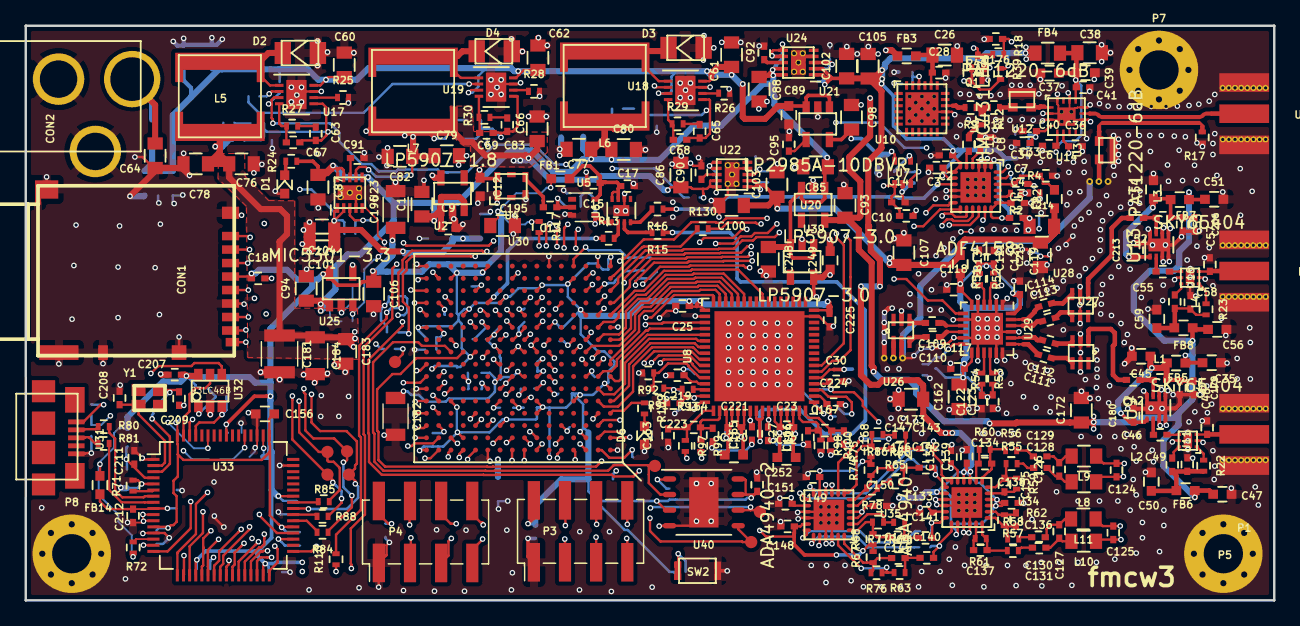
[picture p31: board fmcw3.kicad_pcb from above]

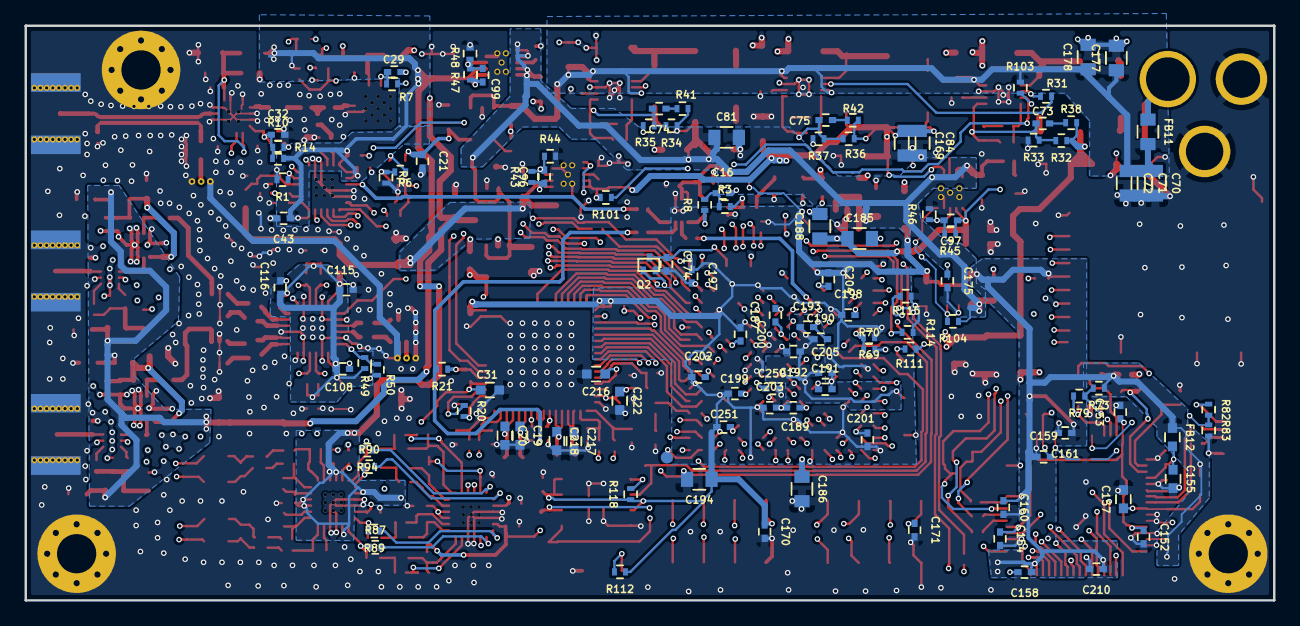
[picture p32: board fmcw3.kicad_pcb from below]

Board: 4 copper layers, 101.8 x 46.8 mm, 429 parts (114 on the bottom side), 267 nets.

Other parts of the board:
U30: XC7A15T-1FTG256C; FTG256
U34, U35: ADA4940-2; VFQFN-24

Their connections:
/1V0: U30.E10, U30.F7, U30.F9, U30.F11, U30.G6, U30.H9, U30.J6, U30.K9, U30.L8; also elsewhere on the board
/1V8: U30.G8, U30.G10, U30.J10, U30.K11, U30.L10; also elsewhere on the board
/3V3A: U34.3, U34.4, U34.9, U34.10, U34.14, U34.20, U35.3, U35.4, U35.9, U35.10, U35.14, U35.20; also elsewhere on the board
/3V3D: U30.A6, U30.A16, U30.B3, U30.B13, U30.C10, U30.D7, U30.E4, U30.E7, U30.E14, U30.F1, U30.H15, U30.J2, U30.J12, U30.L6, U30.L16, U30.M3, U30.M13, U30.N10, U30.P7, U30.R4, U30.R14, U30.T1, U30.T11; also elsewhere on the board
/ADC1+: U35.12; also elsewhere on the board
/ADC1-: U35.13; also elsewhere on the board
/ADC2+: U35.18; also elsewhere on the board
/ADC2-: U35.19; also elsewhere on the board
/ADC_CE: U30.R3; also elsewhere on the board
/ADC_VCM1: U34.17, U35.17; also elsewhere on the board
/ADC_VCM2: U34.11, U35.11; also elsewhere on the board
/ADF_DATA: U30.M2; also elsewhere on the board
/ADF_LE: U30.N1; also elsewhere on the board
/ADF_MUXOUT: U30.K3; also elsewhere on the board
/ADF_TXDATA: U30.P3; also elsewhere on the board
/FPGA_REF: U30.N11; also elsewhere on the board
/MIX_ENBL: U30.J4; also elsewhere on the board
/PA_OFF: U30.T2; also elsewhere on the board
/fpga/ADC_OE1: U30.B2; also elsewhere on the board
/fpga/ADC_OE2: U30.P1; also elsewhere on the board
/fpga/ADC_SHDN1: U30.B1; also elsewhere on the board
/fpga/ADC_SHDN2: U30.N2; also elsewhere on the board
/fpga/ADF_DONE: U30.T4; also elsewhere on the board
/fpga/CARD_DETECT: U30.H16; also elsewhere on the board
/fpga/CCLK: U30.E8; also elsewhere on the board
/fpga/CLKOUT: U30.A15; also elsewhere on the board
/fpga/D0: U30.L2; also elsewhere on the board
/fpga/D1: U30.K2; also elsewhere on the board
/fpga/D2: U30.K1; also elsewhere on the board
/fpga/D3: U30.J3; also elsewhere on the board
/fpga/D4: U30.H1; also elsewhere on the board
/fpga/D5: U30.H2; also elsewhere on the board
/fpga/D6: U30.H3; also elsewhere on the board
/fpga/D7: U30.G2; also elsewhere on the board
/fpga/D8: U30.G1; also elsewhere on the board
/fpga/D9: U30.F2; also elsewhere on the board
/fpga/D10: U30.E1; also elsewhere on the board
/fpga/D11: U30.E2; also elsewhere on the board
/fpga/EXT1_1: U30.C11; also elsewhere on the board
/fpga/EXT1_2: U30.B10; also elsewhere on the board
/fpga/EXT1_3: U30.A9; also elsewhere on the board
/fpga/EXT1_4: U30.C12; also elsewhere on the board
/fpga/EXT1_5: U30.B9; also elsewhere on the board
/fpga/EXT1_6: U30.A8; also elsewhere on the board
/fpga/EXT2_1: U30.B7; also elsewhere on the board
/fpga/EXT2_2: U30.A5; also elsewhere on the board
/fpga/EXT2_3: U30.A4; also elsewhere on the board
/fpga/EXT2_4: U30.A7; also elsewhere on the board
/fpga/EXT2_5: U30.B5; also elsewhere on the board
/fpga/EXT2_6: U30.A3; also elsewhere on the board
/fpga/FT_D0: U30.F15; also elsewhere on the board
/fpga/FT_D1: U30.G16; also elsewhere on the board
/fpga/FT_D2: U30.G15; also elsewhere on the board
/fpga/FT_D3: U30.F14; also elsewhere on the board
/fpga/FT_D4: U30.E16; also elsewhere on the board
/fpga/FT_D5: U30.E15; also elsewhere on the board
/fpga/FT_D6: U30.D16; also elsewhere on the board
/fpga/FT_D7: U30.D15; also elsewhere on the board
/fpga/FT_SUSPEND: U30.C16; also elsewhere on the board
/fpga/INIT_B: U30.K10; also elsewhere on the board
/fpga/LED: U30.D1; also elsewhere on the board
/fpga/M0: U30.M9; also elsewhere on the board
/fpga/M1: U30.M10; also elsewhere on the board
/fpga/M2: U30.M11; also elsewhere on the board
/fpga/OE#: U30.A12; also elsewhere on the board
/fpga/OF1: U30.C2; also elsewhere on the board
/fpga/OF2: U30.M1; also elsewhere on the board
/fpga/PROGRAM_B: U30.L9; also elsewhere on the board
/fpga/RD#: U30.B14; also elsewhere on the board
/fpga/RXF#: U30.B16; also elsewhere on the board
/fpga/SD_CLK: U30.N14; also elsewhere on the board
/fpga/SD_CMD: U30.P16; also elsewhere on the board
/fpga/SD_DAT0: U30.N16; also elsewhere on the board
/fpga/SD_DAT1: U30.M16; also elsewhere on the board
/fpga/SD_DAT2: U30.R16; also elsewhere on the board
/fpga/SD_DAT3: U30.R15; also elsewhere on the board
/fpga/SIWUA: U30.A13; also elsewhere on the board
/fpga/SPI_CS: U30.L12; also elsewhere on the board
/fpga/SPI_DIN: U30.J14; also elsewhere on the board
/fpga/SPI_MOSI: U30.J13; also elsewhere on the board
/fpga/TCK: U30.L7; also elsewhere on the board
/fpga/TDI: U30.N7; also elsewhere on the board
/fpga/TDO: U30.N8; also elsewhere on the board
/fpga/TMS: U30.M7; also elsewhere on the board
/fpga/TXE#: U30.B15; also elsewhere on the board
/fpga/WR: U30.A14; also elsewhere on the board
GND: U30.A1, U30.A11, U30.B8, U30.C5, U30.C15, U30.D2, U30.D12, U30.E9, U30.F6, U30.F8, U30.F10, U30.F16, U30.G3, U30.G7, U30.G9, U30.G13, U30.H6, U30.H7, U30.J7, U30.J8, U30.J9, U30.J11, U30.K4, U30.K6, U30.K7, U30.K8, U30.K14, U30.L1, U30.L11, U30.M8, U30.N5, U30.N15, U30.P2, U30.P12, U30.R9, U30.T6, U30.T16, U34.15, U34.16, U34.21, U34.22, U34.PAD, U35.15, U35.16, U35.21, U35.22, U35.PAD; also elsewhere on the board
unnamed 184: U34.8; also elsewhere on the board
unnamed 185: U34.7; also elsewhere on the board
unnamed 186: U34.6; also elsewhere on the board
unnamed 187: U34.5; also elsewhere on the board
unnamed 188: U34.2; also elsewhere on the board
unnamed 189: U34.1; also elsewhere on the board
unnamed 190: U34.24; also elsewhere on the board
unnamed 191: U34.23; also elsewhere on the board
unnamed 193: U34.19; also elsewhere on the board
unnamed 195: U34.18; also elsewhere on the board
unnamed 197: U34.13; also elsewhere on the board
unnamed 199: U34.12; also elsewhere on the board
unnamed 200: U35.24; also elsewhere on the board
unnamed 201: U35.1; also elsewhere on the board
unnamed 202: U35.6; also elsewhere on the board
unnamed 203: U35.7; also elsewhere on the board
unnamed 222: U30.A2; also elsewhere on the board
unnamed 223: U30.H10; also elsewhere on the board
unnamed 245: U35.23; also elsewhere on the board
unnamed 246: U35.2; also elsewhere on the board
unnamed 247: U35.5; also elsewhere on the board
unnamed 248: U35.8; also elsewhere on the board
unnamed 249: U30.L15; also elsewhere on the board
unnamed 262: U30.R1; also elsewhere on the board
