davidmhunt/fmcw3/(commit log)

2026-09-20 Migrate KiCad 4 project to KiCad 10
    Converts the 2017-era project (EESchema Schematic File Version 2,
    kicad_pcb 20170123) to KiCad 10 format (version 20260306).
    Schematics could not be converted by any kicad-cli: KiCad 10 dropped the
    legacy EESchema reader, and KiCad 8's CLI has no upgrade subcommand. The
    conversion ran through the KiCad 8 GUI (docker kicad/kicad:8.0), then
    kicad-cli sch upgrade locally for each sheet.
    - Symbol remap + rescue: 657 symbols resolved, 0 failures. 607 mapped to
    fmcw3-rescue (generic parts pinned to the 2017 cache so pin numbering
    does not silently change), 50 to the project library.
    - sym-lib-table and fmcw3-rescue.lib are load-bearing: without them the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
    [adc.kicad_sch, adc.sch, fmcw3.kicad_pcb, fmcw3.kicad_sch, fmcw3.sch, fpga.kicad_sch, fpga.sch, if.kicad_sch]
2026-09-20 Restore Forsten's original design rules; re-pour zones
    The KiCad 10 migration reset the board constraints to stock defaults, which
    are coarser than this board actually is, so DRC flagged 2395 violations that
    were rule mismatches rather than design faults.
    Recovered the 2017 values from the legacy kicad_pcb (setup) and
    (net_class Default) blocks on master and applied them:
    min track width 0.15 mm (was defaulting to 0.20)
    min via diameter 0.46 mm (was 0.50)
    min hole diameter 0.254 mm (was 0.30)
    min clearance 0.13 mm (was 0.20)
    solder mask 0.20 mm
    micro/blind vias disallowed, as in the original
    DRC after: 2395 -> 1394 violations, 0 unconnected items.
    tr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
    [fmcw3.kicad_pcb]
2026-09-30 Hardware: kicad10-build base - legacy/ split, parts/ sourcing tooling, READMEs, KiCad 10 PDF
    Move KiCad 4 leftovers (fmcw3.pro, fmcw3-cache.lib, imu.sch, libs/fmcw3.bak/.bck,
    2017 fmcw3.pdf) into hardware/legacy/ with a README; add parts/ (BOM, parts list,
    DigiKey availability check) with the credentials file gitignored; add a fresh
    KiCad 10 schematic PDF at hardware/fmcw3.pdf; document layout and branches in README.
    No schematic/PCB/project file changes; netlist identical to kicad10-migration.
    Directive: hw-01 (falcon work item #57)
    [availability.csv, bom_pcb.csv, imu.sch, parts.csv]
2026-09-30 Researcher: complete fmcw3 BOM sourcing data, resolve fuzzy MPNs, add fields_to_apply
    Every BOM group now has a status in availability.csv; generic passives are
    spec-only (no MPN); fuzzy suffixes resolved with datasheet citations or
    flagged needs-David (suffix_decisions.csv). Corrects MIC5301 (YD5, SOT-23-5)
    and L7980 (L7980TR, DFN 3x3) package picks and U34/U35 qty (2 ICs).
    Adds parts/.gitignore for __pycache__.
    Directive: hw-02
    Tracker: #58
    [availability.csv, fields_to_apply.csv, parts.csv, suffix_decisions.csv]
2026-09-30 Hardware: apply sourcing fields to fmcw3 schematic symbols (hw-02)
    Adds Manufacturer, MPN, DigiKey PN, Status (obsolete/NFND/needs-David:
    see docs/hardware/fmcw3 memo) and, for generic passives, spec-only
    Tolerance/Voltage/Dielectric hidden fields to 355 refs from
    parts/fields_to_apply.csv. The 4 existing manf# fields are renamed to
    MPN. Value, footprint, nets and PCB untouched. ERC 679 unchanged;
    netlist nets/components identical.
    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
    [adc.kicad_sch, fmcw3.kicad_sch, fpga.kicad_sch, if.kicad_sch, mixer.kicad_sch, power.kicad_sch, rx.kicad_sch, tx.kicad_sch]
2026-09-30 Researcher: fmcw3 datasheet library manifest, fetch script, Datasheet URL fields (hw-06)
    Gitignored local PDF library (52 fetched, 2 to pull by hand), manifest.csv,
    stdlib fetch.py, datasheet_fields.csv (61 refs) and datasheet_left_as_is.csv
    (294 refs) for the schematic Datasheet property pass.
    Directive: hw-06
    Tracker: #62
    [datasheet_fields.csv, datasheet_left_as_is.csv, manifest.csv]
2026-09-30 Hardware: set vendor datasheet URLs in fmcw3 Datasheet fields (hw-06)
    Datasheet property only, 61 refs from parts/datasheet_fields.csv
    (incl. shared-sheet U11/U16 and multi-unit U30/U34/U35); all other
    refs untouched. ERC 679 unchanged, nets identical, 0 unconnected.
    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
    [adc.kicad_sch, fmcw3.kicad_sch, fpga.kicad_sch, if.kicad_sch, mixer.kicad_sch, power.kicad_sch, rx.kicad_sch, tx.kicad_sch]
